nmikstas/atari_gravitar_black_widow/kicad/atari_gravitar_black_widow/Sheet3B.kicad_sch

## KiCad design kicad/atari_gravitar_black_widow/Sheet3B.kicad_sch (2022-01-29, an earlier design)

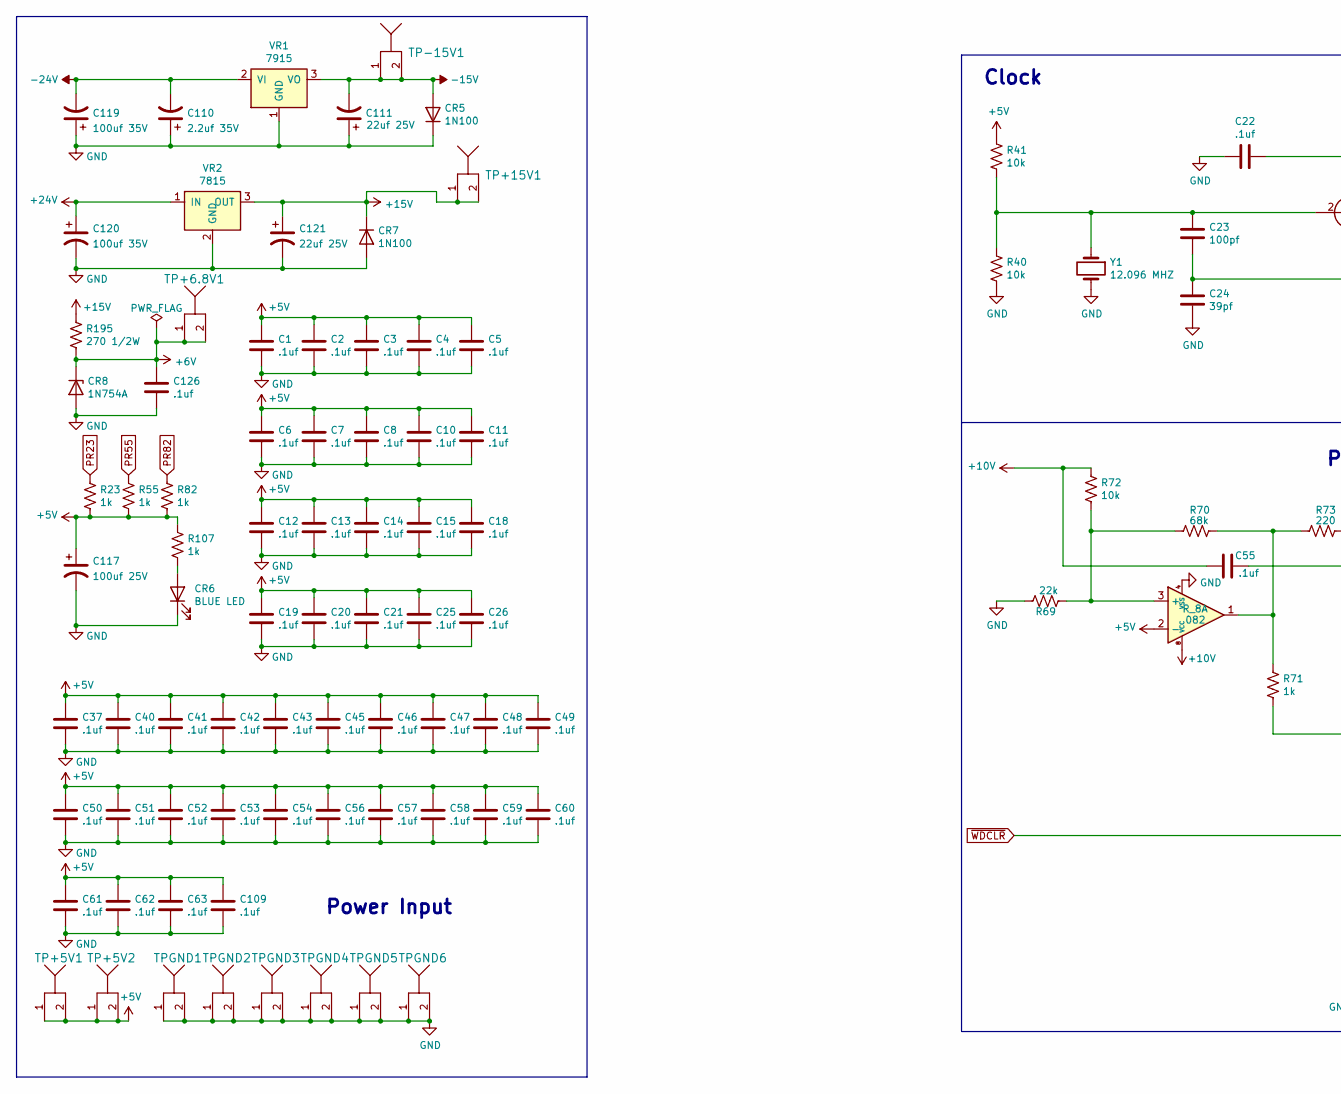
[picture p1: schematic Sheet3B.kicad_sch, part in row 1, column 1]

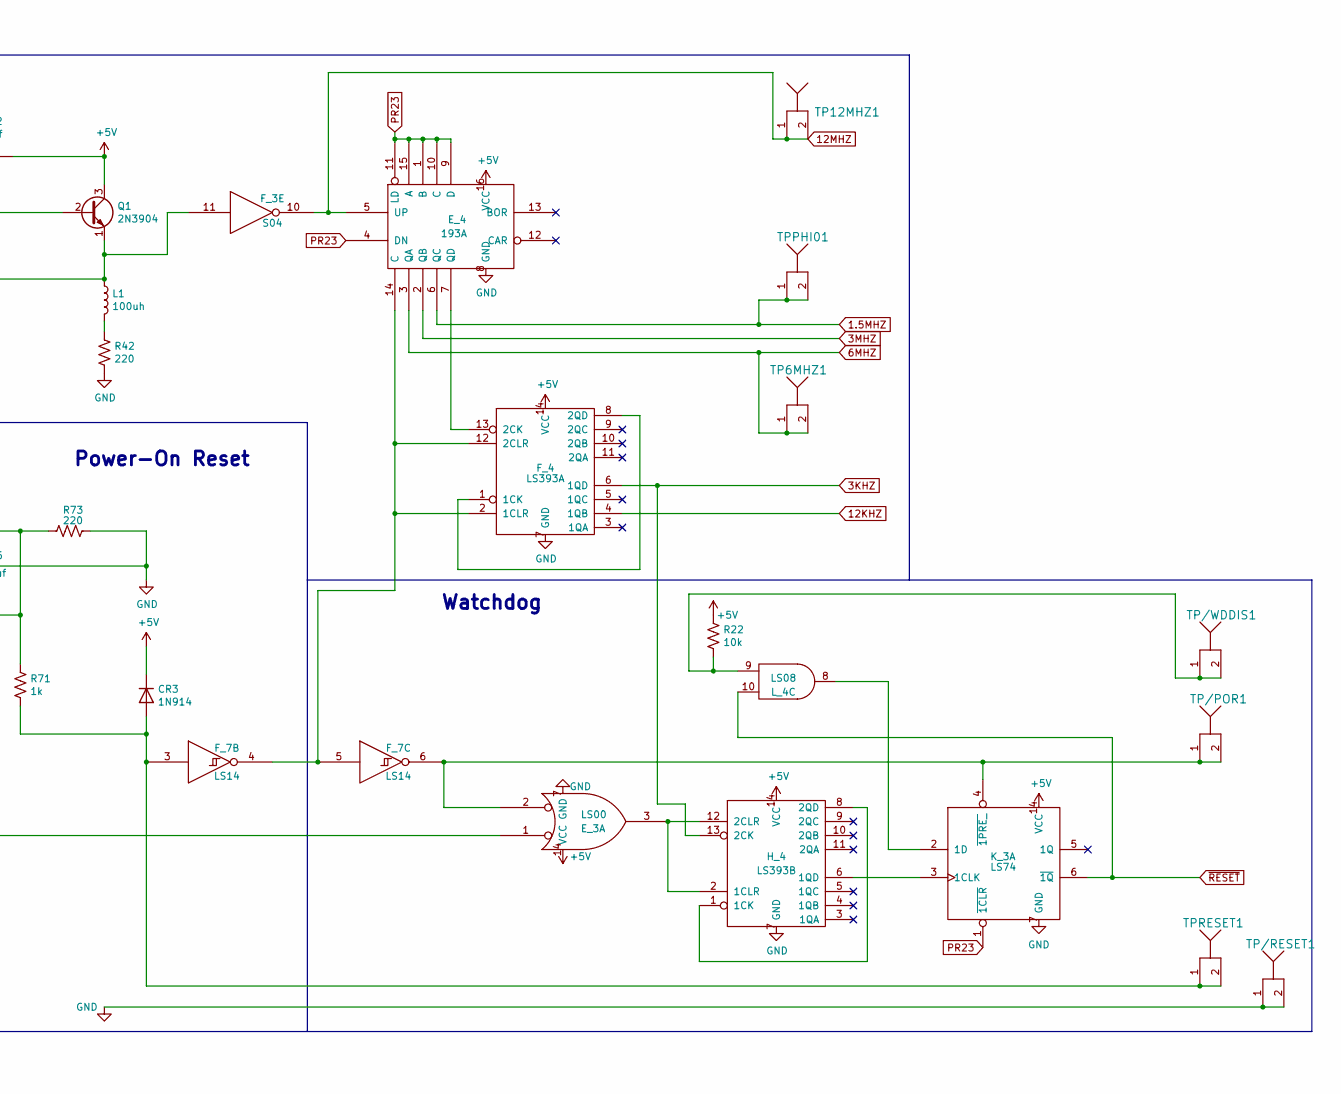
[picture p2: schematic Sheet3B.kicad_sch, part in row 1, column 2]

Parts:
C1, C2, C3, C4, C5, C6, C7, C8, C10, C11, C12, C13, C14, C15, C18, C19, C20, C21, C22, C25, C26, C37, C40, C41, C42, C43, C45, C46, C47, C48, C49, C50, C51, C52, C53, C54, C55, C56, C57, C58, C59, C60, C61, C62, C63, C109, C126: .1uf
C23: 100pf
C24: 39pf
C110: 2.2uf 35V
C111, C121: 22uf 25V
C117: 100uf 25V
C119, C120: 100uf 35V
CR3: 1N914
CR5, CR7: 1N100
CR6: BLUE LED
CR8: 1N754A
E_3: LS00
E_4: 193A
F_3: S04
F_4: LS393A
F_7: LS14
H_4: LS393B
K_3: LS74
L1: 100uh
L_4: LS08
Q1: 2N3904
R22, R40, R41, R72: 10k
R23, R55, R71, R82, R107: 1k
R42, R73: 220
R69: 22k
R70: 68k
R195: 270 1/2W
R_8: 082
TP6MHZ1, TP12MHZ1: TP
TP+5V1, TP+5V2, TP+6.8V1, TP+15V1: TP
TP-15V1: TP
TP/POR1: TP
TP/RESET1: TP
TP/WDDIS1: TP
TPGND1, TPGND2, TPGND3, TPGND4, TPGND5, TPGND6: TP
TPPHI01: TP
TPRESET1: TP
VR1: 7915
VR2: 7815
Y1: 12.096 MHZ

Connections:
1.5MHZ: E_4.6 (QC), TPPHI01.1, TPPHI01.2
3KHZ: F_4.6 (1QD), H_4.13 (2CK)
3MHZ: E_4.2 (QB)
6MHZ: E_4.3 (QA), TP6MHZ1.1, TP6MHZ1.2
12KHZ: F_4.4 (1QB)
12MHZ: E_4.5 (UP), F_3.10, TP12MHZ1.1, TP12MHZ1.2
+5V: C1.1, C2.1, C3.1, C4.1, C5.1, C6.1, C7.1, C8.1, C10.1, C11.1, C12.1, C13.1, C14.1, C15.1, C18.1, C19.1, C20.1, C21.1, C22.1, C25.1, C26.1, C37.1, C40.1, C41.1, C42.1, C43.1, C45.1, C46.1, C47.1, C48.1, C49.1, C50.1, C51.1, C52.1, C53.1, C54.1, C56.1, C57.1, C58.1, C59.1, C60.1, C61.1, C62.1, C63.1, C109.1, C117.1, CR3.1 (K), E_3.14 (VCC), E_4.16 (VCC), F_4.14 (VCC), H_4.14 (VCC), K_3.14 (VCC), Q1.3 (C), R22.1, R23.2, R41.1, R55.2, R82.2, R107.1, R_8.2 (-), TP+5V1.1, TP+5V1.2, TP+5V2.1, TP+5V2.2
+6V: C126.1, CR8.1 (K), R195.2, TP+6.8V1.1, TP+6.8V1.2
+10V: C55.2, R72.1, R_8.8 (VCC)
+15V: C121.1, CR7.1 (K), R195.1, TP+15V1.1, TP+15V1.2, VR2.3 (OUT)
+24V: C120.1, VR2.1 (IN)
-15V: C111.2, CR5.2 (A), TP-15V1.1, TP-15V1.2, VR1.3 (VO)
-24V: C110.2, C119.2, VR1.2 (VI)
GND: C1.2, C2.2, C3.2, C4.2, C5.2, C6.2, C7.2, C8.2, C10.2, C11.2, C12.2, C13.2, C14.2, C15.2, C18.2, C19.2, C20.2, C21.2, C22.2, C24.2, C25.2, C26.2, C37.2, C40.2, C41.2, C42.2, C43.2, C45.2, C46.2, C47.2, C48.2, C49.2, C50.2, C51.2, C52.2, C53.2, C54.2, C55.1, C56.2, C57.2, C58.2, C59.2, C60.2, C61.2, C62.2, C63.2, C109.2, C110.1, C111.1, C117.2, C119.1, C120.2, C121.2, C126.2, CR5.1 (K), CR6.1 (K), CR7.2 (A), CR8.2 (A), E_3.7 (GND), E_4.8 (GND), F_4.7 (GND), H_4.7 (GND), K_3.7 (GND), R40.2, R42.2, R69.2, R73.1, R_8.4 (VSS), TP/RESET1.1, TP/RESET1.2, TPGND1.1, TPGND1.2, TPGND2.1, TPGND2.2, TPGND3.1, TPGND3.2, TPGND4.1, TPGND4.2, TPGND5.1, TPGND5.2, TPGND6.1, TPGND6.2, VR1.1 (GND), VR2.2 (GND), Y1.2
unnamed: C23.1, Q1.2 (B), R40.1, R41.2, Y1.1
unnamed: C23.2, C24.1, F_3.11, L1.1, Q1.1 (E)
unnamed: CR3.2 (A), F_7.3, R71.2, TPRESET1.1, TPRESET1.2
unnamed: CR6.2 (A), R107.2
unnamed: E_3.2, F_7.6, K_3.4 (~1PRE_), TP/POR1.1, TP/POR1.2
unnamed: E_3.3, H_4.2 (1CLR), H_4.12 (2CLR)
unnamed: E_4.7 (QD), F_4.13 (2CK)
unnamed: E_4.14 (C), F_4.2 (1CLR), F_4.12 (2CLR), F_7.4, F_7.5
unnamed: F_4.1 (1CK), F_4.8 (2QD)
unnamed: H_4.1 (1CK), H_4.8 (2QD)
unnamed: H_4.6 (1QD), K_3.3 (1CLK)
unnamed: K_3.2 (1D), L_4.8
unnamed: L1.2, R42.1
unnamed: L_4.9, R22.2, TP/WDDIS1.1, TP/WDDIS1.2
unnamed: R69.1, R70.2, R72.2, R_8.3 (+)
unnamed: R70.1, R71.1, R73.2, R_8.1
PR23: E_4.1 (B), E_4.4 (DN), E_4.9 (D), E_4.10 (C), E_4.11 (LD), E_4.15 (A), K_3.1 (~1CLR), R23.1
PR55: R55.1
PR82: R82.1
~RESET: K_3.6 (~1Q), L_4.10
~WDCLR: E_3.1

Notes on the sheet:
Power-On Reset
Power Input
Clock
Watchdog
