nmikstas/atari_gravitar_black_widow/kicad/atari_gravitar_black_widow/Sheet4A.kicad_sch

## KiCad design kicad/atari_gravitar_black_widow/Sheet4A.kicad_sch (2022-02-08, an earlier design)

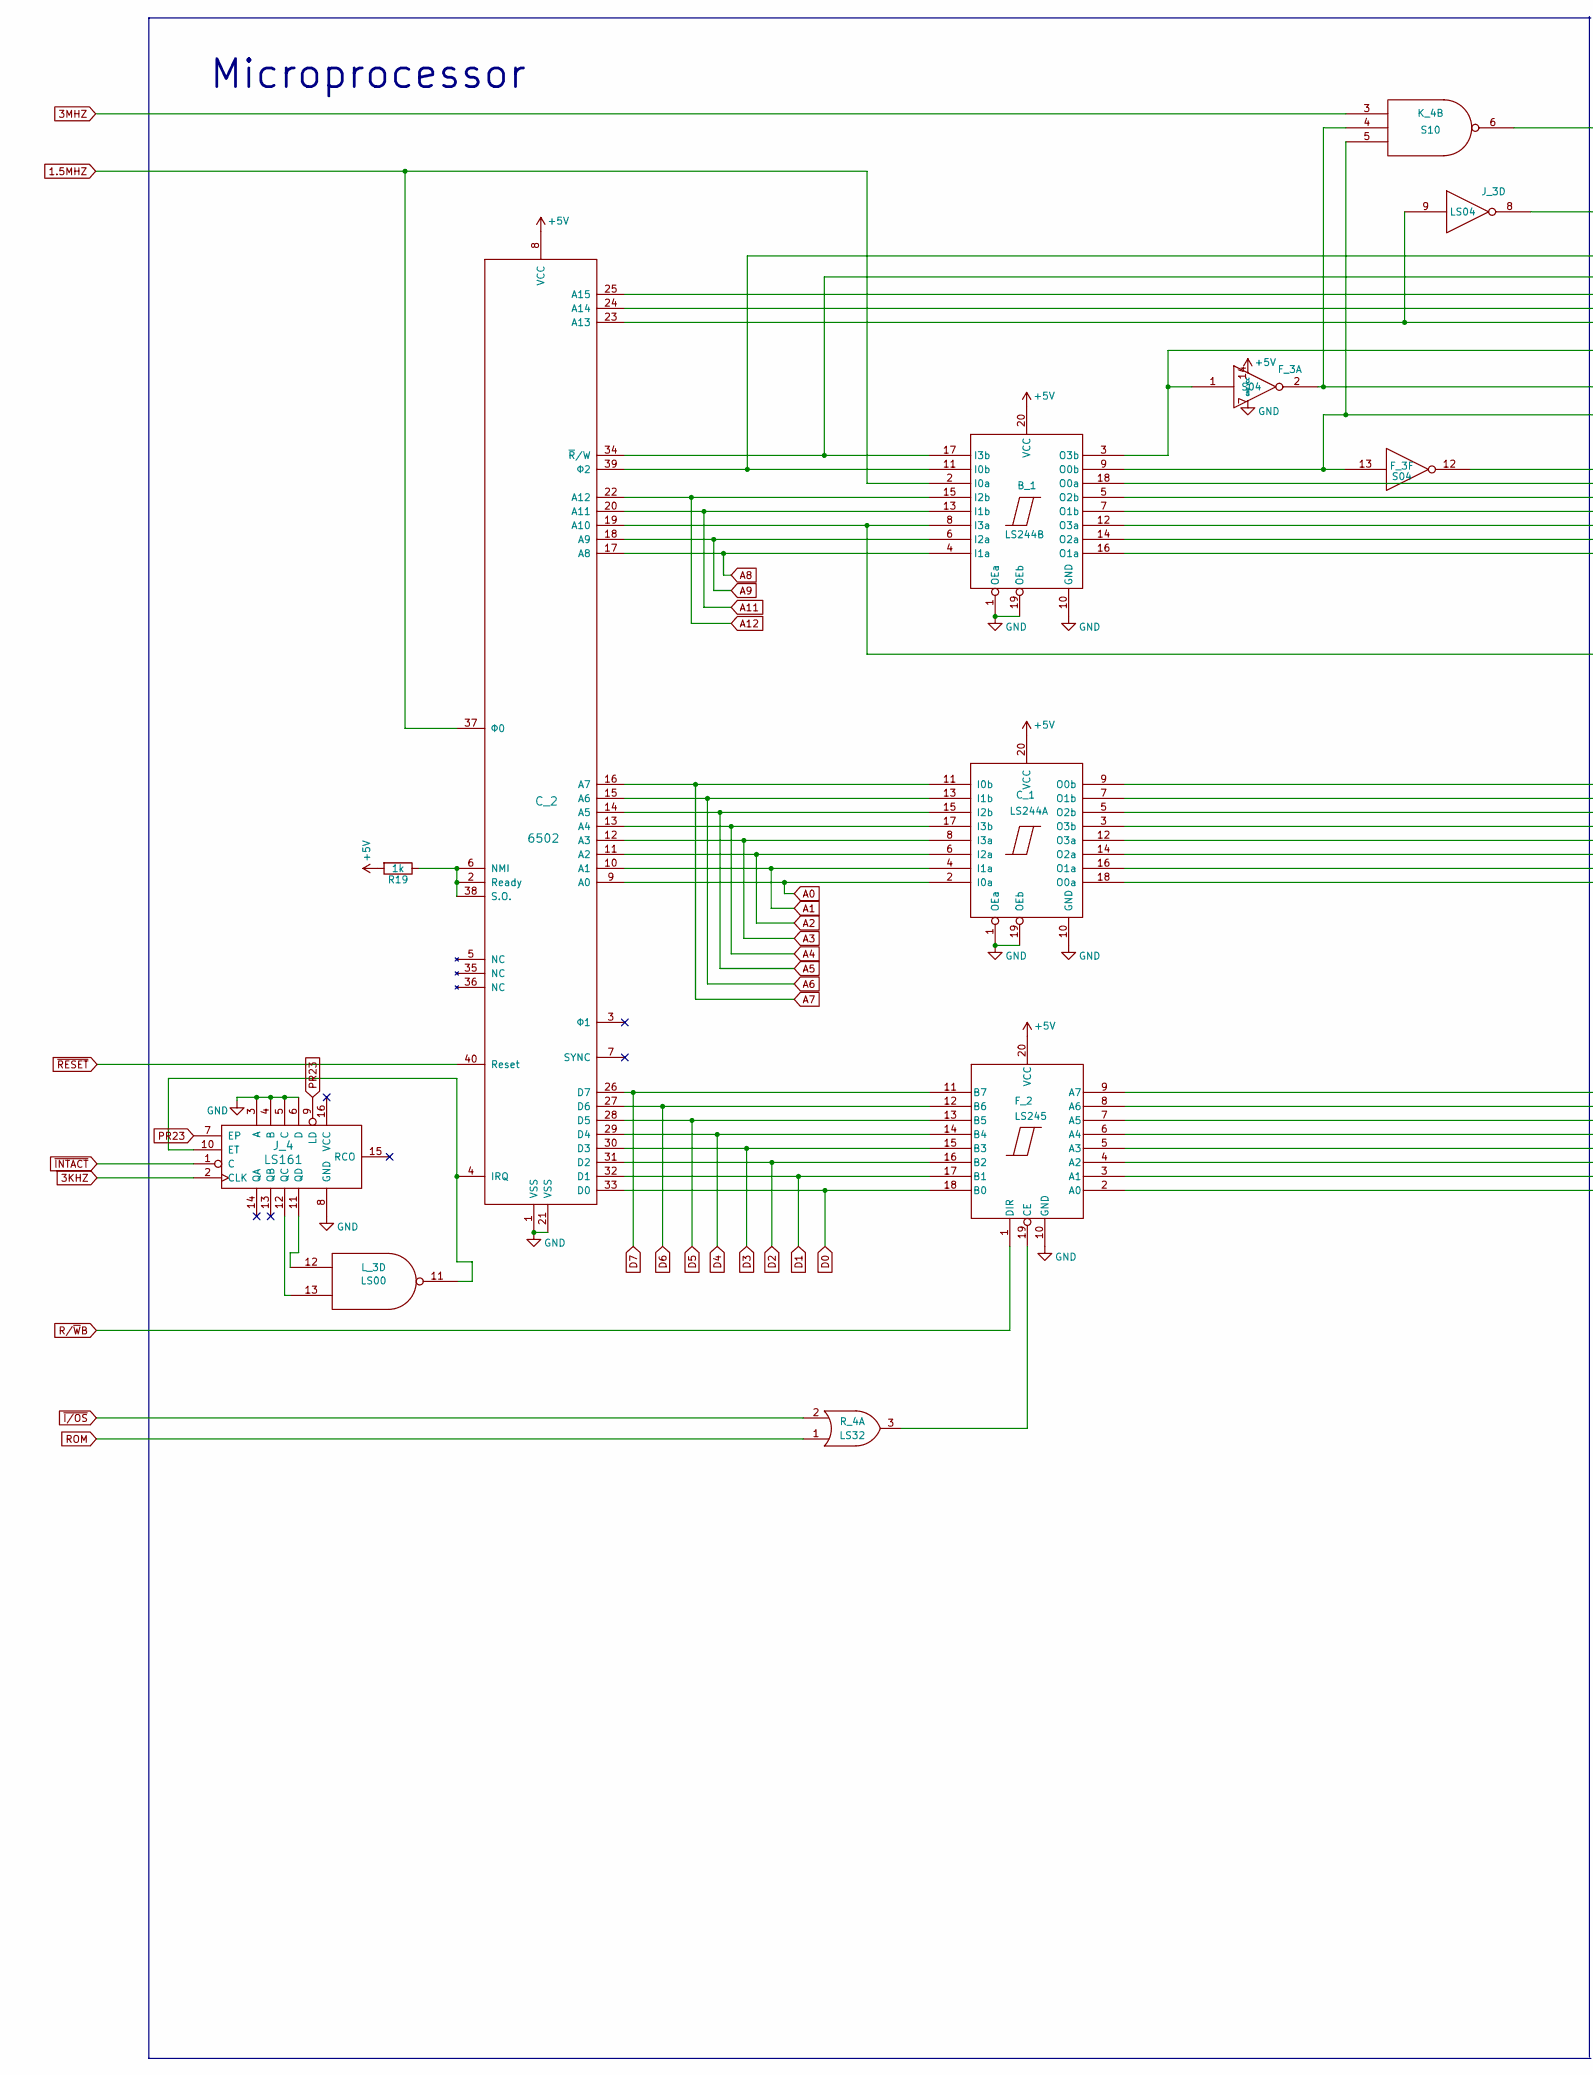
[picture p3: schematic Sheet4A.kicad_sch, part in row 1, column 1]

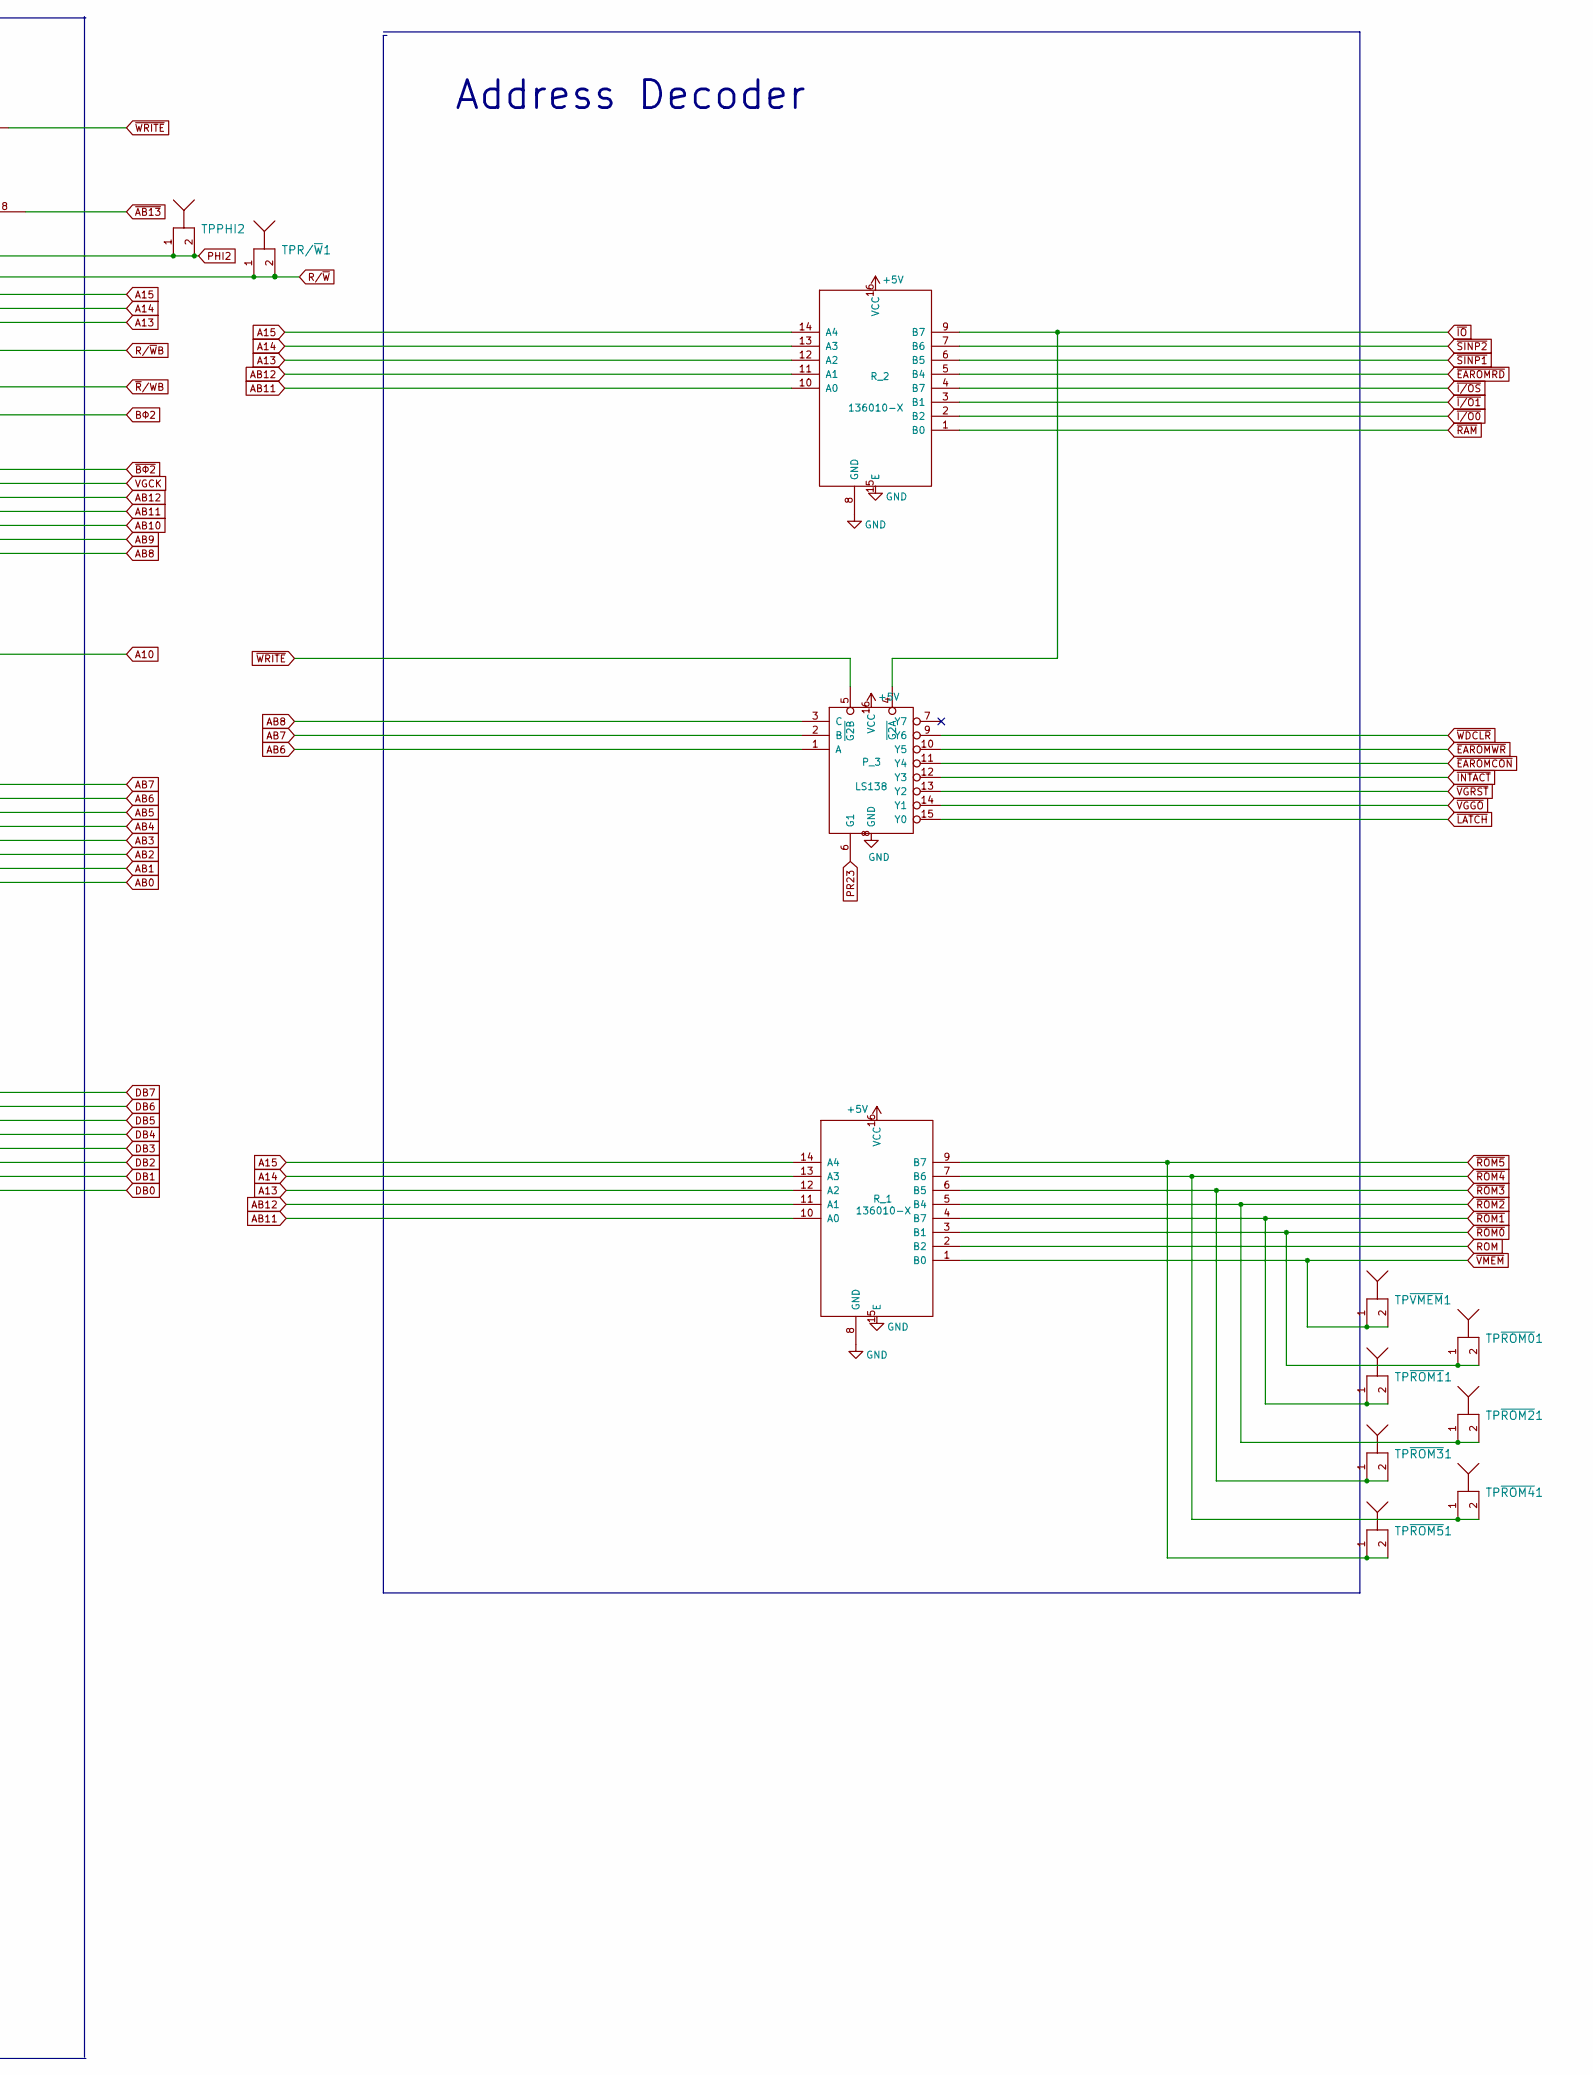
[picture p4: schematic Sheet4A.kicad_sch, part in row 1, column 2]

Parts:
B_1: LS244B
C_1: LS244A
C_2: 6502
F_2: LS245
F_3: S04
J_3: LS04
J_4: LS161
K_4: S10
L_3: LS00
P_3: LS138
R19: 1k
R_1, R_2: 136010-X
R_4: LS32
TPPHI2: TP
TPR/~{W}1: TP
TP~{ROM0}1, TP~{ROM1}1, TP~{ROM2}1, TP~{ROM3}1, TP~{ROM4}1, TP~{ROM5}1: TP
TP~{VMEM}1: TP

Connections:
1.5MHZ: B_1.2 (I0a), C_2.37 (Φ0)
3KHZ: J_4.2 (CLK)
3MHZ: K_4.3
+5V: B_1.20 (VCC), C_1.20 (VCC), C_2.8 (VCC), F_2.20 (VCC), F_3.14 (VCC), P_3.16 (VCC), R19.2, R_1.16 (VCC), R_2.16 (VCC)
A0: C_1.2 (I0a), C_2.9 (A0)
A1: C_1.4 (I1a), C_2.10 (A1)
A2: C_1.6 (I2a), C_2.11 (A2)
A3: C_1.8 (I3a), C_2.12 (A3)
A4: C_1.17 (I3b), C_2.13 (A4)
A5: C_1.15 (I2b), C_2.14 (A5)
A6: C_1.13 (I1b), C_2.15 (A6)
A7: C_1.11 (I0b), C_2.16 (A7)
A8: B_1.4 (I1a), C_2.17 (A8)
A9: B_1.6 (I2a), C_2.18 (A9)
A10: B_1.8 (I3a), C_2.19 (A10)
A11: B_1.13 (I1b), C_2.20 (A11)
A12: B_1.15 (I2b), C_2.22 (A12)
A13: C_2.23 (A13), J_3.9, R_1.12 (A2), R_2.12 (A2)
A14: C_2.24 (A14), R_1.13 (A3), R_2.13 (A3)
A15: C_2.25 (A15), R_1.14 (A4), R_2.14 (A4)
AB0: C_1.18 (O0a)
AB1: C_1.16 (O1a)
AB2: C_1.14 (O2a)
AB3: C_1.12 (O3a)
AB4: C_1.3 (O3b)
AB5: C_1.5 (O2b)
AB6: C_1.7 (O1b), P_3.1 (A)
AB7: C_1.9 (O0b), P_3.2 (B)
AB8: B_1.16 (O1a), P_3.3 (C)
AB9: B_1.14 (O2a)
AB10: B_1.12 (O3a)
AB11: B_1.7 (O1b), R_1.10 (A0), R_2.10 (A0)
AB12: B_1.5 (O2b), R_1.11 (A1), R_2.11 (A1)
BΦ2: B_1.9 (O0b), F_3.13, K_4.5
D0: C_2.33 (D0), F_2.18 (B0)
D1: C_2.32 (D1), F_2.17 (B1)
D2: C_2.31 (D2), F_2.16 (B2)
D3: C_2.30 (D3), F_2.15 (B3)
D4: C_2.29 (D4), F_2.14 (B4)
D5: C_2.28 (D5), F_2.13 (B5)
D6: C_2.27 (D6), F_2.12 (B6)
D7: C_2.26 (D7), F_2.11 (B7)
DB0: F_2.2 (A0)
DB1: F_2.3 (A1)
DB2: F_2.4 (A2)
DB3: F_2.5 (A3)
DB4: F_2.6 (A4)
DB5: F_2.7 (A5)
DB6: F_2.8 (A6)
DB7: F_2.9 (A7)
GND: B_1.1 (OEa), B_1.10 (GND), B_1.19 (OEb), C_1.1 (OEa), C_1.10 (GND), C_1.19 (OEb), C_2.1 (VSS), C_2.21 (VSS), F_2.10 (GND), F_3.7 (GND), J_4.3 (A), J_4.4 (B), J_4.5 (C), J_4.6 (D), J_4.8 (GND), P_3.8 (GND), R_1.8 (GND), R_1.15 (E), R_2.8 (GND), R_2.15 (E)
unnamed: C_2.2 (Ready), C_2.6 (NMI), C_2.38 (S.O.), R19.1
unnamed: C_2.4 (IRQ), J_4.10 (ET), L_3.11
unnamed: F_2.19 (CE), R_4.3
unnamed: J_4.11 (QD), L_3.12
unnamed: J_4.12 (QC), L_3.13
PHI2: B_1.11 (I0b), C_2.39 (Φ2), TPPHI2.1, TPPHI2.2
PR23: J_4.7 (EP), J_4.9 (LD), P_3.6 (G1)
ROM: R_1.2 (B2), R_4.1
R/~W: B_1.17 (I3b), C_2.34 (~R/W), TPR/~{W}1.1, TPR/~{W}1.2
R/~WB: B_1.3 (O3b), F_2.1 (DIR), F_3.1
VGCK: B_1.18 (O0a)
~AB13: J_3.8
~BΦ2: F_3.12
~EAROMCON: P_3.11 (Y4)
~EAROMRD: R_2.5 (B4)
~EAROMWR: P_3.10 (Y5)
~INTACT: J_4.1 (C), P_3.12 (Y3)
~IO: P_3.4 (~G2A), R_2.9 (B7)
~I/O0: R_2.2 (B2)
~I/O1: R_2.3 (B1)
~I/OS: R_2.4 (B7), R_4.2
~LATCH: P_3.15 (Y0)
~RAM: R_2.1 (B0)
~RESET: C_2.40 (Reset)
~ROM0: R_1.3 (B1), TP~{ROM0}1.1, TP~{ROM0}1.2
~ROM1: R_1.4 (B7), TP~{ROM1}1.1, TP~{ROM1}1.2
~ROM2: R_1.5 (B4), TP~{ROM2}1.1, TP~{ROM2}1.2
~ROM3: R_1.6 (B5), TP~{ROM3}1.1, TP~{ROM3}1.2
~ROM4: R_1.7 (B6), TP~{ROM4}1.1, TP~{ROM4}1.2
~ROM5: R_1.9 (B7), TP~{ROM5}1.1, TP~{ROM5}1.2
~R/WB: F_3.2, K_4.4
~SINP1: R_2.6 (B5)
~SINP2: R_2.7 (B6)
~VGGO: P_3.14 (Y1)
~VGRST: P_3.13 (Y2)
~VMEM: R_1.1 (B0), TP~{VMEM}1.1, TP~{VMEM}1.2
~WDCLR: P_3.9 (Y6)
~WRITE: K_4.6, P_3.5 (~G2B)

Notes on the sheet:
Microprocessor
Address Decoder
