nmikstas/atari_gravitar_black_widow/kicad/atari_gravitar_black_widow/Sheet4B.kicad_sch

## KiCad design kicad/atari_gravitar_black_widow/Sheet4B.kicad_sch (2022-03-18, an earlier design)

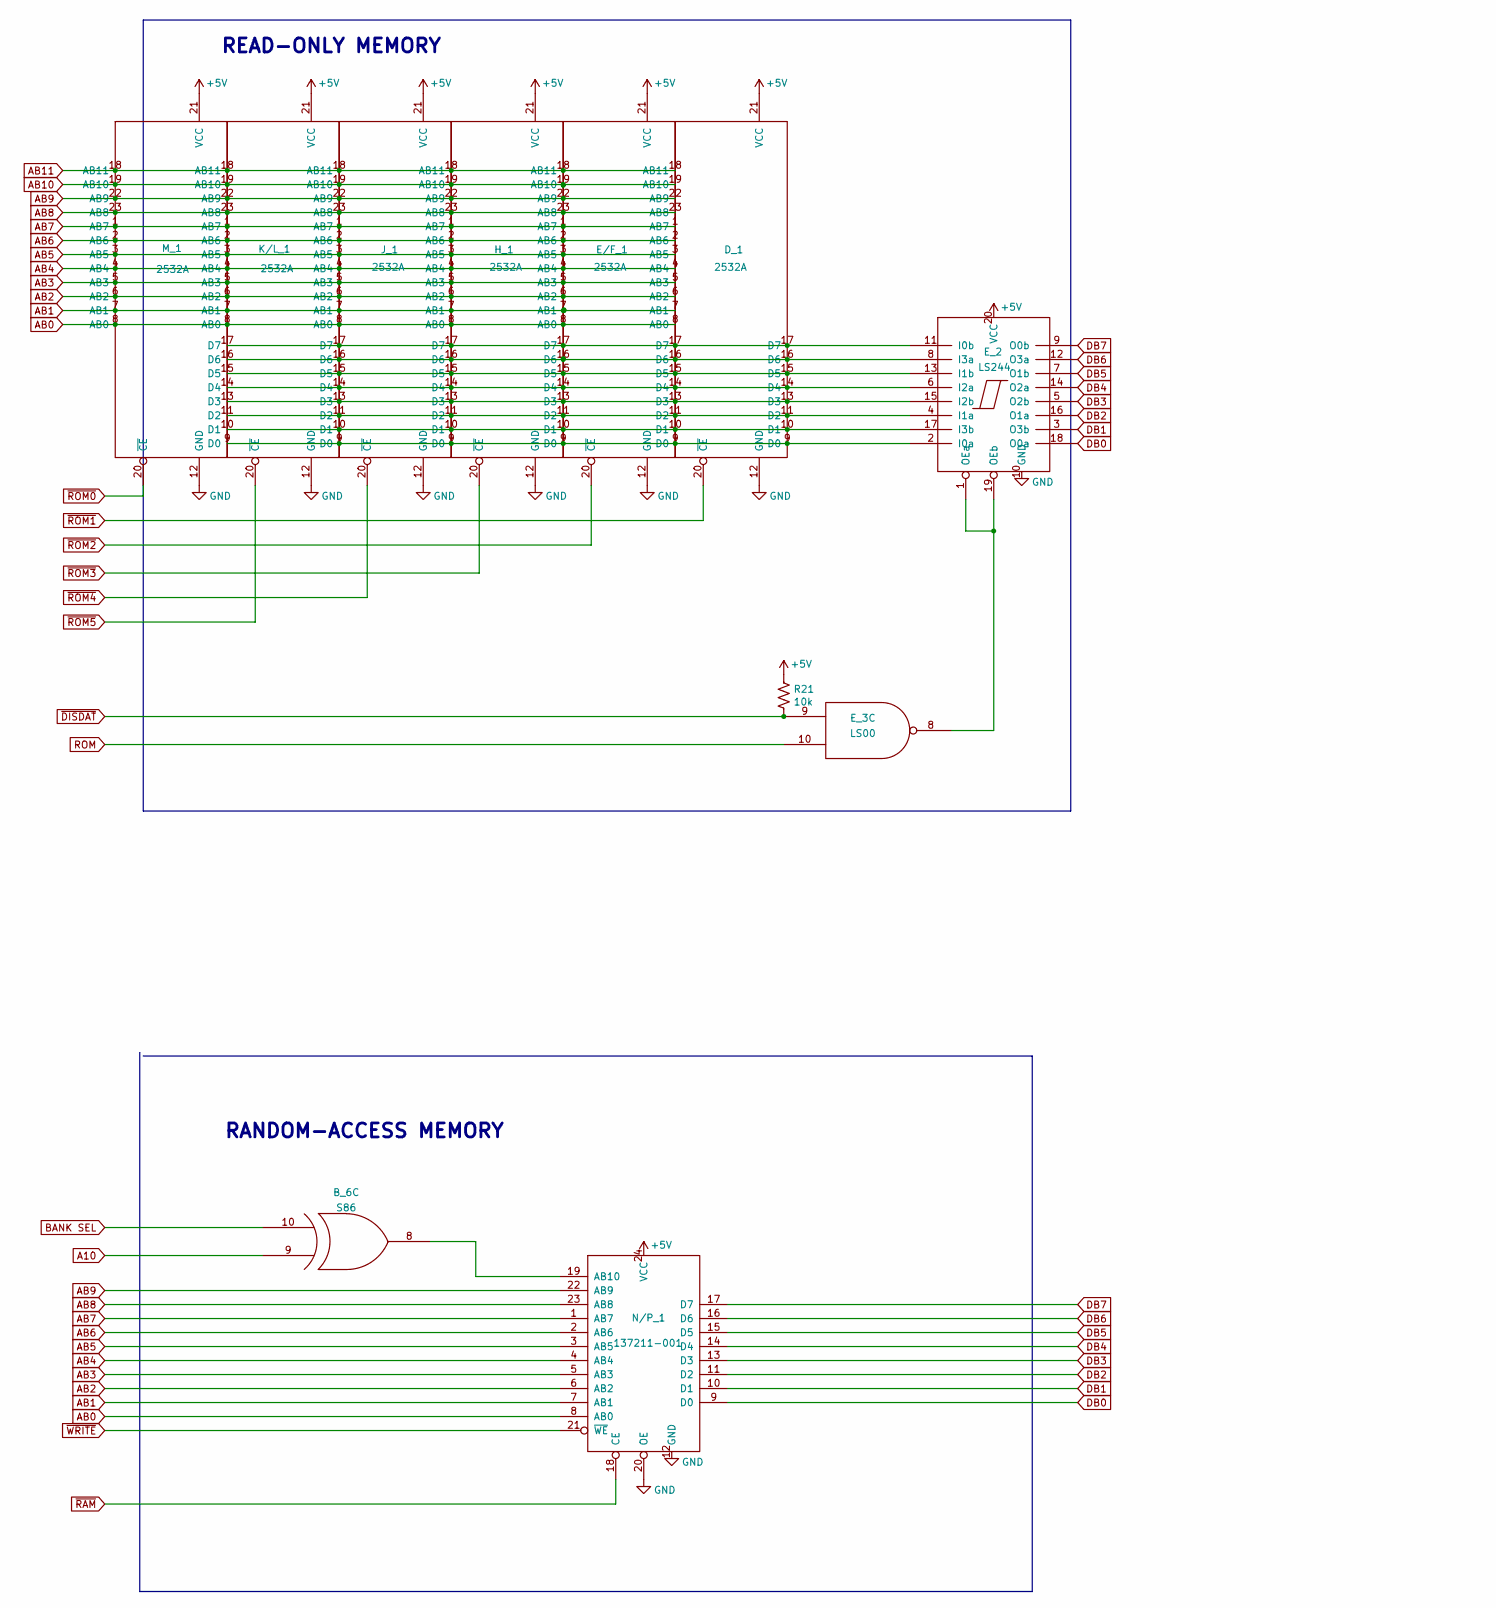
[picture p5: schematic Sheet4B.kicad_sch, part in row 1, column 1]

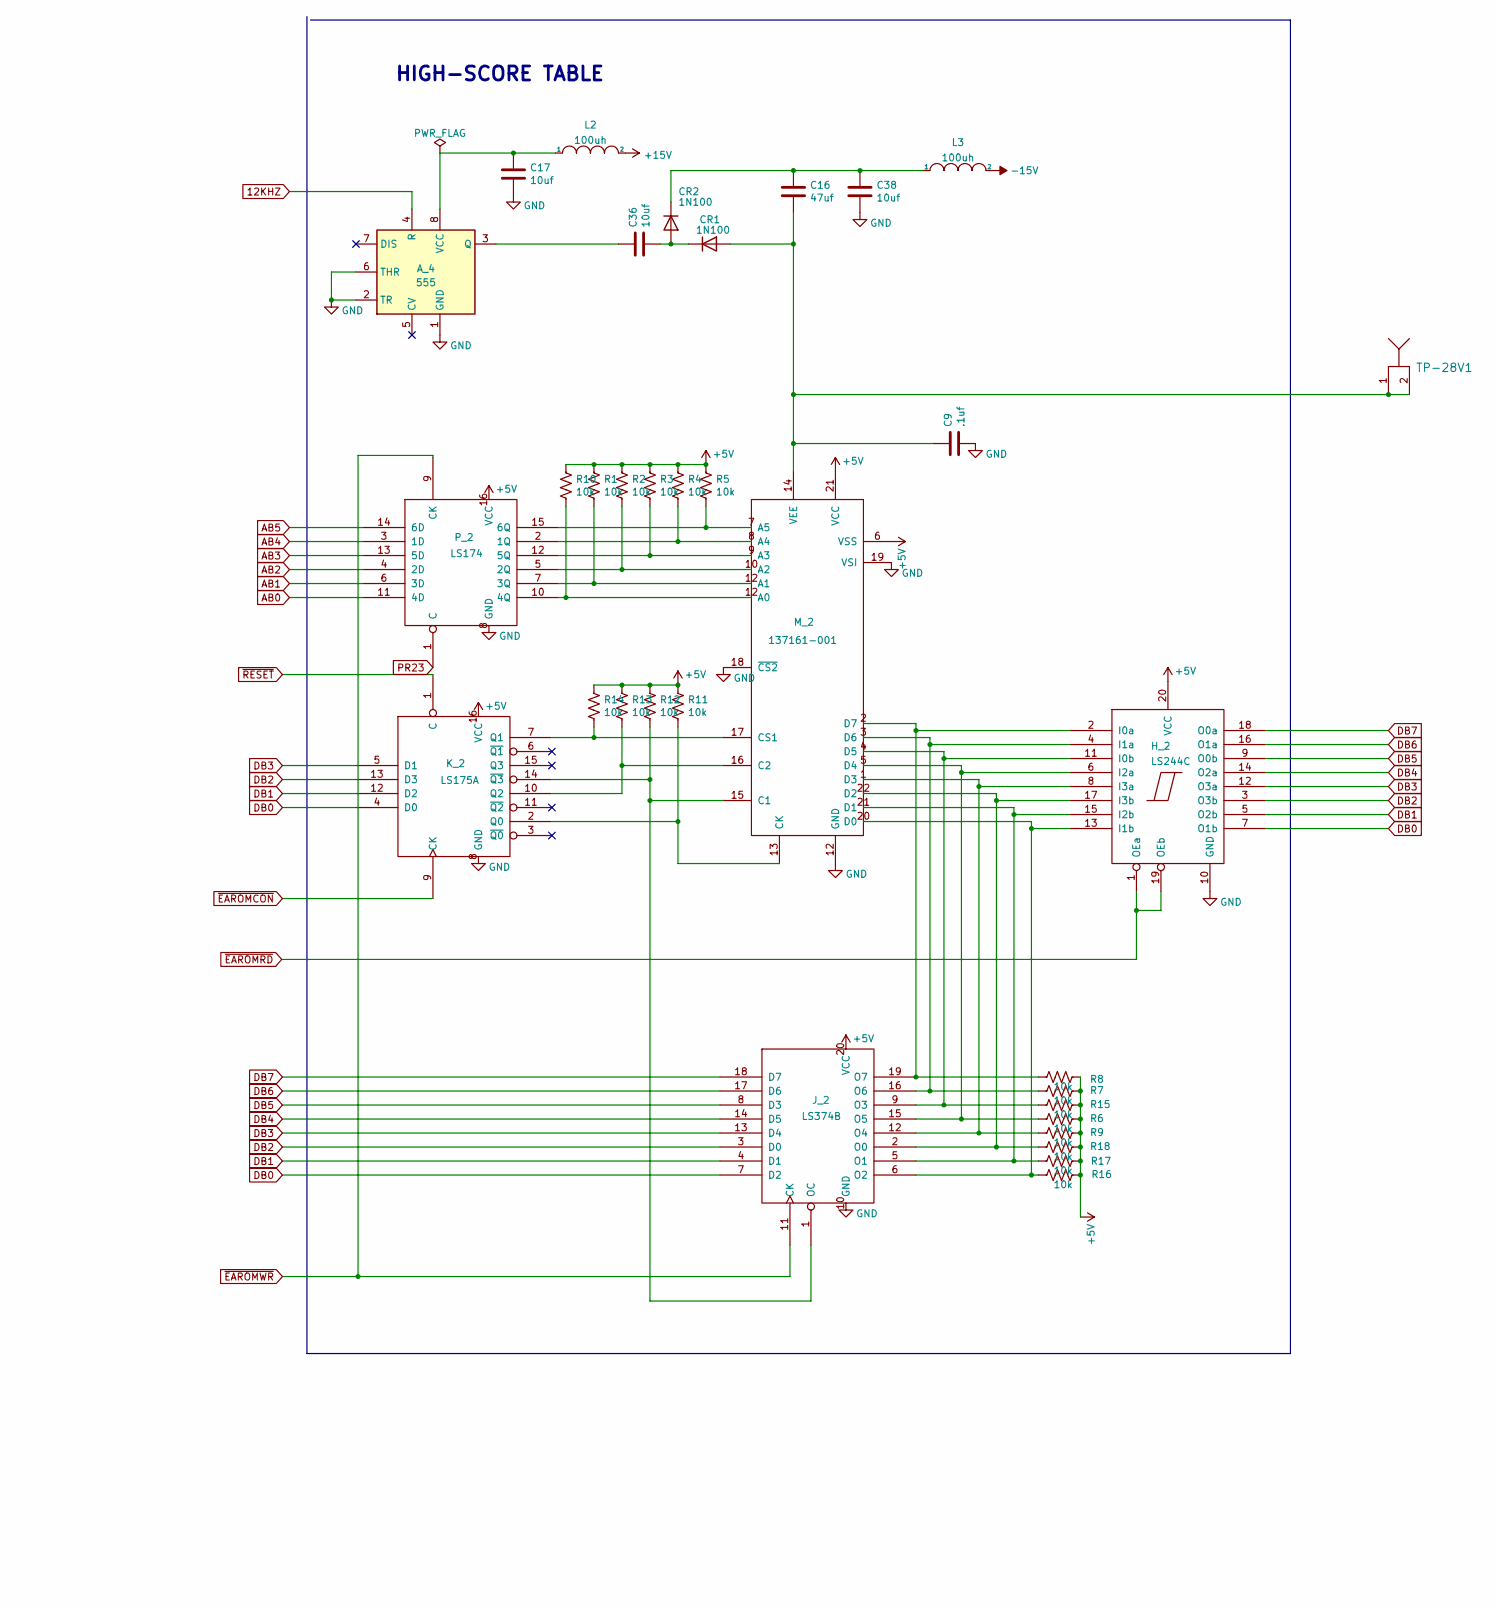
[picture p6: schematic Sheet4B.kicad_sch, part in row 1, column 2]

Parts:
A_4: 555
B_6: S86
C9: .1uf
C16: 47uf
C17, C36, C38: 10uf
CR1, CR2: 1N100
D_1: 2532A
E/F_1: 2532A
E_2: LS244
E_3: LS00
H_1: 2532A
H_2: LS244C
J_1: 2532A
J_2: LS374B
K/L_1: 2532A
K_2: LS175A
L2, L3: 100uh
M_1: 2532A
M_2: 137161-001
N/P_1: 137211-001
P_2: LS174
R1, R2, R3, R4, R5, R6, R7, R8, R9, R10, R11, R12, R13, R14, R15, R16, R17, R18, R21: 10k
TP-28V1: TP

Connections:
12KHZ: A_4.4 (R)
+5V: D_1.21 (VCC), E/F_1.21 (VCC), E_2.20 (VCC), H_1.21 (VCC), H_2.20 (VCC), J_1.21 (VCC), J_2.20 (VCC), K/L_1.21 (VCC), K_2.16 (VCC), M_1.21 (VCC), M_2.6 (VSS), M_2.21 (D1), N/P_1.24 (VCC), P_2.16 (VCC), R1.1, R2.1, R3.1, R4.1, R5.1, R6.1, R7.1, R8.1, R9.1, R10.1, R11.1, R12.1, R13.1, R14.1, R15.1, R16.1, R17.1, R18.1, R21.1
+15V: L2.2
-15V: L3.2
A10: B_6.9
AB0: D_1.8 (AB0), E/F_1.8 (AB0), H_1.8 (AB0), J_1.8 (AB0), K/L_1.8 (AB0), M_1.8 (AB0), N/P_1.8 (AB0), P_2.11 (4D)
AB1: D_1.7 (AB1), E/F_1.7 (AB1), H_1.7 (AB1), J_1.7 (AB1), K/L_1.7 (AB1), M_1.7 (AB1), N/P_1.7 (AB1), P_2.6 (3D)
AB2: D_1.6 (AB2), E/F_1.6 (AB2), H_1.6 (AB2), J_1.6 (AB2), K/L_1.6 (AB2), M_1.6 (AB2), N/P_1.6 (AB2), P_2.4 (2D)
AB3: D_1.5 (AB3), E/F_1.5 (AB3), H_1.5 (AB3), J_1.5 (AB3), K/L_1.5 (AB3), M_1.5 (AB3), N/P_1.5 (AB3), P_2.13 (5D)
AB4: D_1.4 (AB4), E/F_1.4 (AB4), H_1.4 (AB4), J_1.4 (AB4), K/L_1.4 (AB4), M_1.4 (AB4), N/P_1.4 (AB4), P_2.3 (1D)
AB5: D_1.3 (AB5), E/F_1.3 (AB5), H_1.3 (AB5), J_1.3 (AB5), K/L_1.3 (AB5), M_1.3 (AB5), N/P_1.3 (AB5), P_2.14 (6D)
AB6: D_1.2 (AB6), E/F_1.2 (AB6), H_1.2 (AB6), J_1.2 (AB6), K/L_1.2 (AB6), M_1.2 (AB6), N/P_1.2 (AB6)
AB7: D_1.1 (AB7), E/F_1.1 (AB7), H_1.1 (AB7), J_1.1 (AB7), K/L_1.1 (AB7), M_1.1 (AB7), N/P_1.1 (AB7)
AB8: D_1.23 (AB8), E/F_1.23 (AB8), H_1.23 (AB8), J_1.23 (AB8), K/L_1.23 (AB8), M_1.23 (AB8), N/P_1.23 (AB8)
AB9: D_1.22 (AB9), E/F_1.22 (AB9), H_1.22 (AB9), J_1.22 (AB9), K/L_1.22 (AB9), M_1.22 (AB9), N/P_1.22 (AB9)
AB10: D_1.19 (AB10), E/F_1.19 (AB10), H_1.19 (AB10), J_1.19 (AB10), K/L_1.19 (AB10), M_1.19 (AB10)
AB11: D_1.18 (AB11), E/F_1.18 (AB11), H_1.18 (AB11), J_1.18 (AB11), K/L_1.18 (AB11), M_1.18 (AB11)
BANK SEL: B_6.10
DB0: E_2.18 (O0a), H_2.7 (O1b), J_2.7 (D2), K_2.4 (D0), N/P_1.9 (D0)
DB1: E_2.3 (O3b), H_2.5 (O2b), J_2.4 (D1), K_2.12 (D2), N/P_1.10 (D1)
DB2: E_2.16 (O1a), H_2.3 (O3b), J_2.3 (D0), K_2.13 (D3), N/P_1.11 (D2)
DB3: E_2.5 (O2b), H_2.12 (O3a), J_2.13 (D4), K_2.5 (D1), N/P_1.13 (D3)
DB4: E_2.14 (O2a), H_2.14 (O2a), J_2.14 (D5), N/P_1.14 (D4)
DB5: E_2.7 (O1b), H_2.9 (O0b), J_2.8 (D3), N/P_1.15 (D5)
DB6: E_2.12 (O3a), H_2.16 (O1a), J_2.17 (D6), N/P_1.16 (D6)
DB7: E_2.9 (O0b), H_2.18 (O0a), J_2.18 (D7), N/P_1.17 (D7)
GND: A_4.1 (GND), A_4.2 (TR), A_4.6 (THR), C9.2, C17.2, C38.2, D_1.12 (GND), E/F_1.12 (GND), E_2.10 (GND), H_1.12 (GND), H_2.10 (GND), J_1.12 (GND), J_2.10 (GND), K/L_1.12 (GND), K_2.8 (GND), M_1.12 (GND), M_2.12 (A0), M_2.18 (~CS2), M_2.19 (VSI), N/P_1.12 (GND), N/P_1.20 (OE), P_2.8 (GND)
unnamed: A_4.3 (Q), C36.1
unnamed: A_4.8 (VCC), C17.1, L2.1
unnamed: B_6.8, N/P_1.19 (AB10)
unnamed: C16.1, C38.1, CR2.1 (K), L3.1
unnamed: C9.1, C16.2, CR1.2 (A), M_2.14 (VEE), TP-28V1.1, TP-28V1.2
unnamed: C36.2, CR1.1 (K), CR2.2 (A)
unnamed: D_1.9 (D0), E/F_1.9 (D0), E_2.2 (I0a), H_1.9 (D0), J_1.9 (D0), K/L_1.9 (D0), M_1.9 (D0)
unnamed: D_1.10 (D1), E/F_1.10 (D1), E_2.17 (I3b), H_1.10 (D1), J_1.10 (D1), K/L_1.10 (D1), M_1.10 (D1)
unnamed: D_1.11 (D2), E/F_1.11 (D2), E_2.4 (I1a), H_1.11 (D2), J_1.11 (D2), K/L_1.11 (D2), M_1.11 (D2)
unnamed: D_1.13 (D3), E/F_1.13 (D3), E_2.15 (I2b), H_1.13 (D3), J_1.13 (D3), K/L_1.13 (D3), M_1.13 (D3)
unnamed: D_1.14 (D4), E/F_1.14 (D4), E_2.6 (I2a), H_1.14 (D4), J_1.14 (D4), K/L_1.14 (D4), M_1.14 (D4)
unnamed: D_1.15 (D5), E/F_1.15 (D5), E_2.13 (I1b), H_1.15 (D5), J_1.15 (D5), K/L_1.15 (D5), M_1.15 (D5)
unnamed: D_1.16 (D6), E/F_1.16 (D6), E_2.8 (I3a), H_1.16 (D6), J_1.16 (D6), K/L_1.16 (D6), M_1.16 (D6)
unnamed: D_1.17 (D7), E/F_1.17 (D7), E_2.11 (I0b), H_1.17 (D7), J_1.17 (D7), K/L_1.17 (D7), M_1.17 (D7)
unnamed: E_2.1 (OEa), E_2.19 (OEb), E_3.8
unnamed: H_2.2 (I0a), J_2.19 (O7), M_2.2 (D7), R8.2
unnamed: H_2.4 (I1a), J_2.16 (O6), M_2.3 (D6), R7.2
unnamed: H_2.6 (I2a), J_2.15 (O5), M_2.5 (D4), R6.2
unnamed: H_2.8 (I3a), J_2.12 (O4), M_2.1 (D3), R9.2
unnamed: H_2.11 (I0b), J_2.9 (O3), M_2.4 (D5), R15.2
unnamed: H_2.13 (I1b), J_2.6 (O2), M_2.20 (D0), R16.2
unnamed: H_2.15 (I2b), J_2.5 (O1), M_2.21 (D1), R17.2
unnamed: H_2.17 (I3b), J_2.2 (O0), M_2.22 (D2), R18.2
unnamed: J_2.1 (OC), K_2.14 (~Q3), M_2.15 (C1), R12.2
unnamed: K_2.2 (Q0), M_2.13 (CK), R11.2
unnamed: K_2.7 (Q1), M_2.17 (CS1), R14.2
unnamed: K_2.10 (Q2), M_2.16 (C2), R13.2
unnamed: M_2.7 (A5), P_2.15 (6Q), R5.2
unnamed: M_2.8 (A4), P_2.2 (1Q), R4.2
unnamed: M_2.9 (A3), P_2.12 (5Q), R3.2
unnamed: M_2.10 (A2), P_2.5 (2Q), R2.2
unnamed: M_2.12 (A0), P_2.7 (3Q), P_2.10 (4Q), R1.2, R10.2
PR23: P_2.1 (C)
ROM: E_3.10
~DISDAT: E_3.9, R21.2
~EAROMCON: K_2.9 (CK)
~EAROMRD: H_2.1 (OEa), H_2.19 (OEb)
~EAROMWR: J_2.11 (CK), P_2.9 (CK)
~RAM: N/P_1.18 (CE)
~RESET: K_2.1 (C)
~ROM0: M_1.20 (~CE)
~ROM1: D_1.20 (~CE)
~ROM2: E/F_1.20 (~CE)
~ROM3: H_1.20 (~CE)
~ROM4: J_1.20 (~CE)
~ROM5: K/L_1.20 (~CE)
~WRITE: N/P_1.21 (~WE)

Notes on the sheet:
READ-ONLY MEMORY
RANDOM-ACCESS MEMORY
HIGH-SCORE TABLE
