nmikstas/atari_gravitar_black_widow/kicad/atari_gravitar_black_widow/Sheet5A.kicad_sch

## KiCad design kicad/atari_gravitar_black_widow/Sheet5A.kicad_sch (2022-03-22, an earlier design)

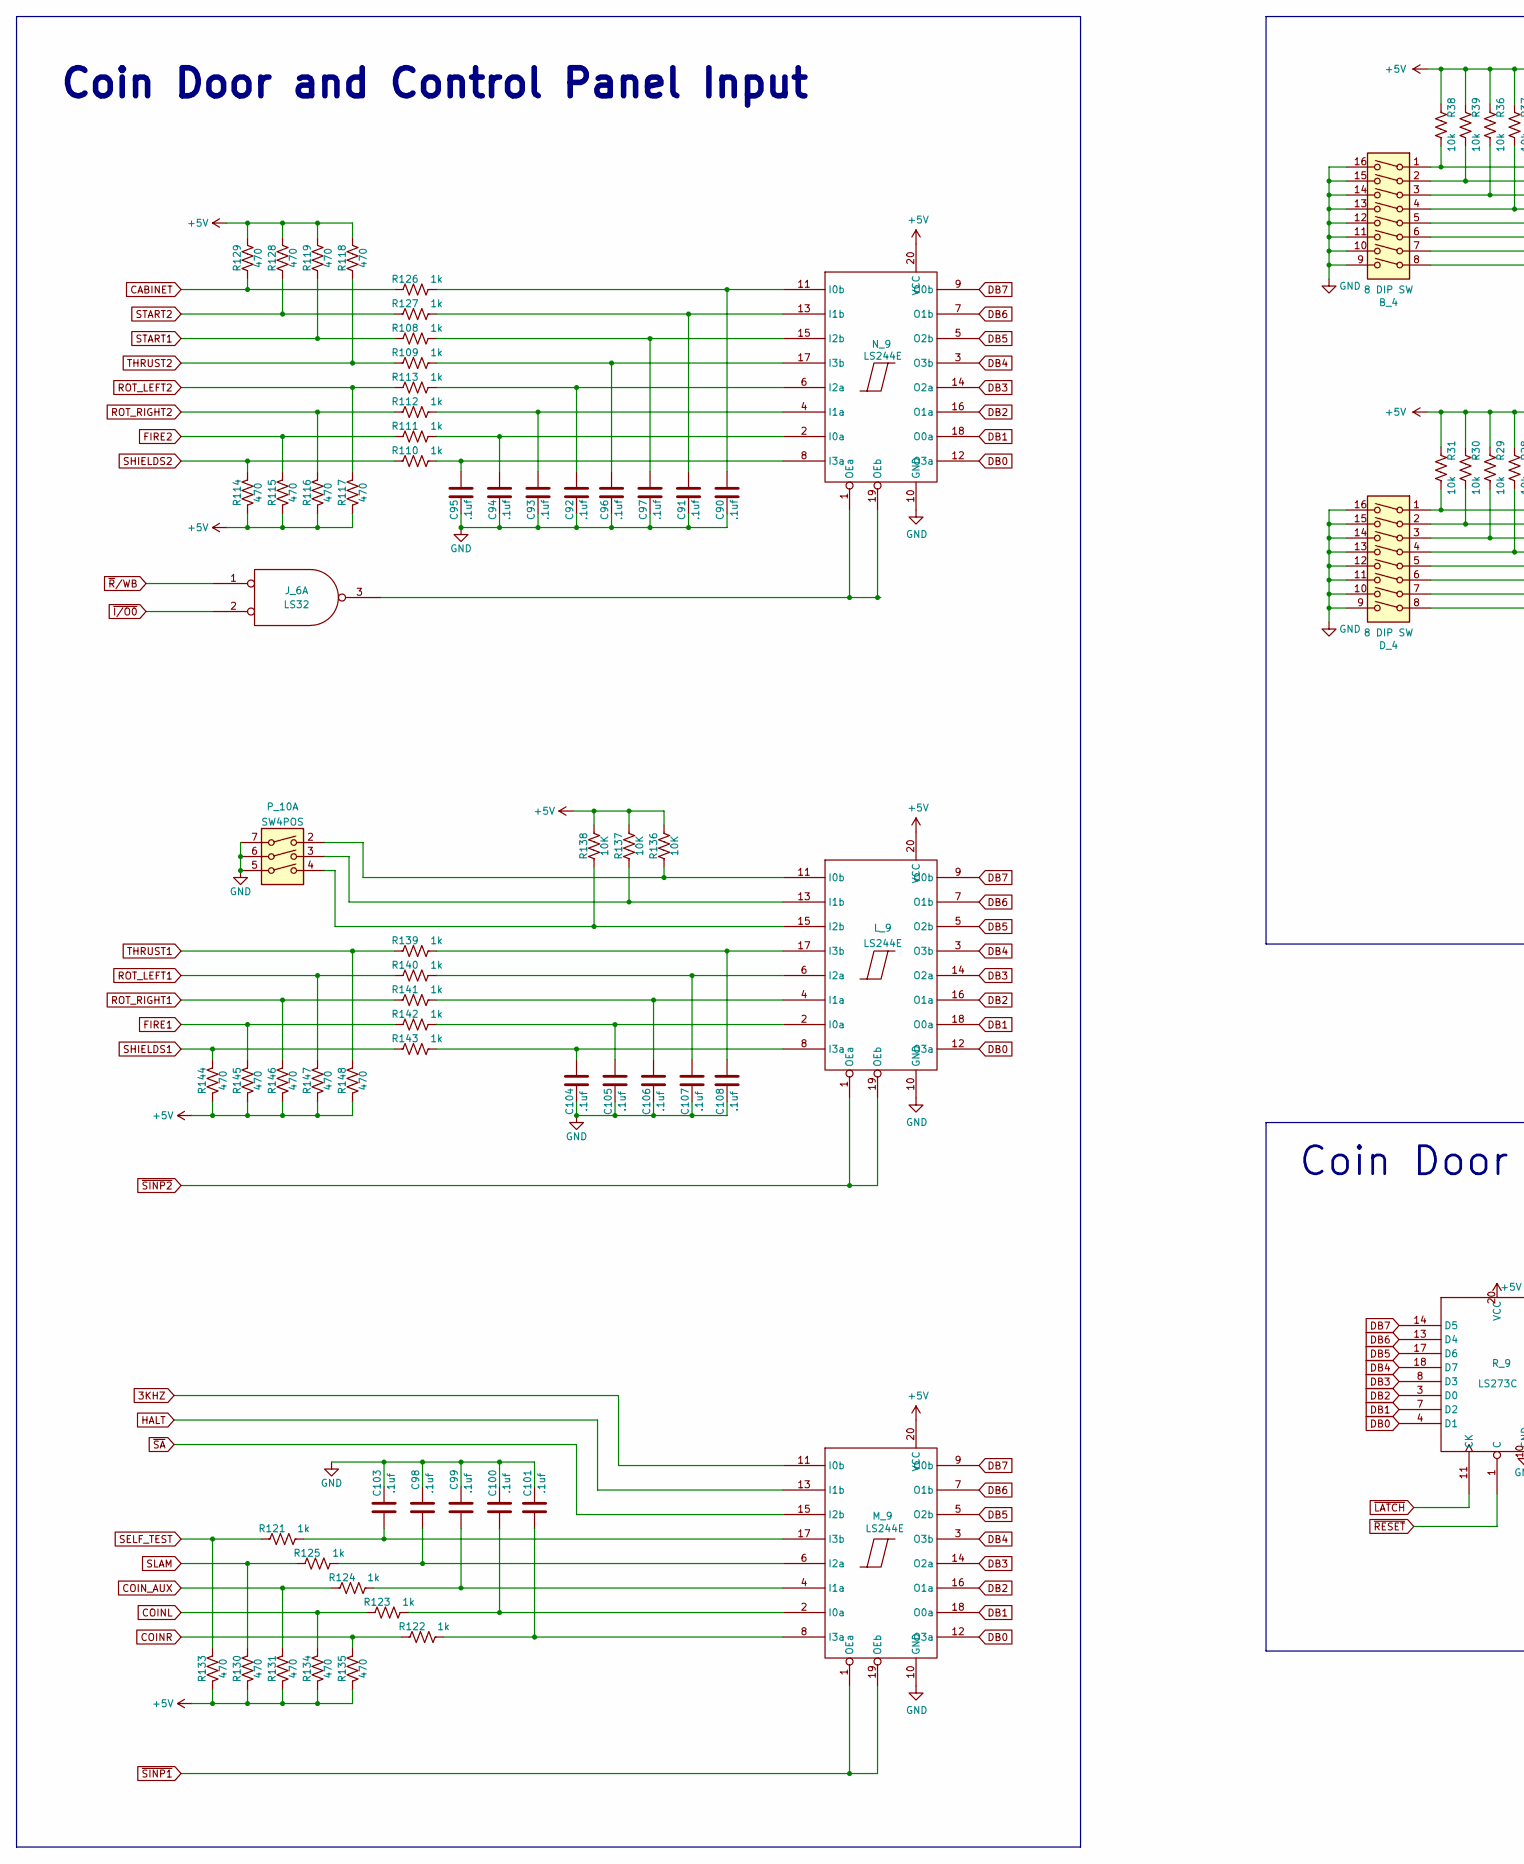
[picture p7: schematic Sheet5A.kicad_sch, part in row 1, column 1]

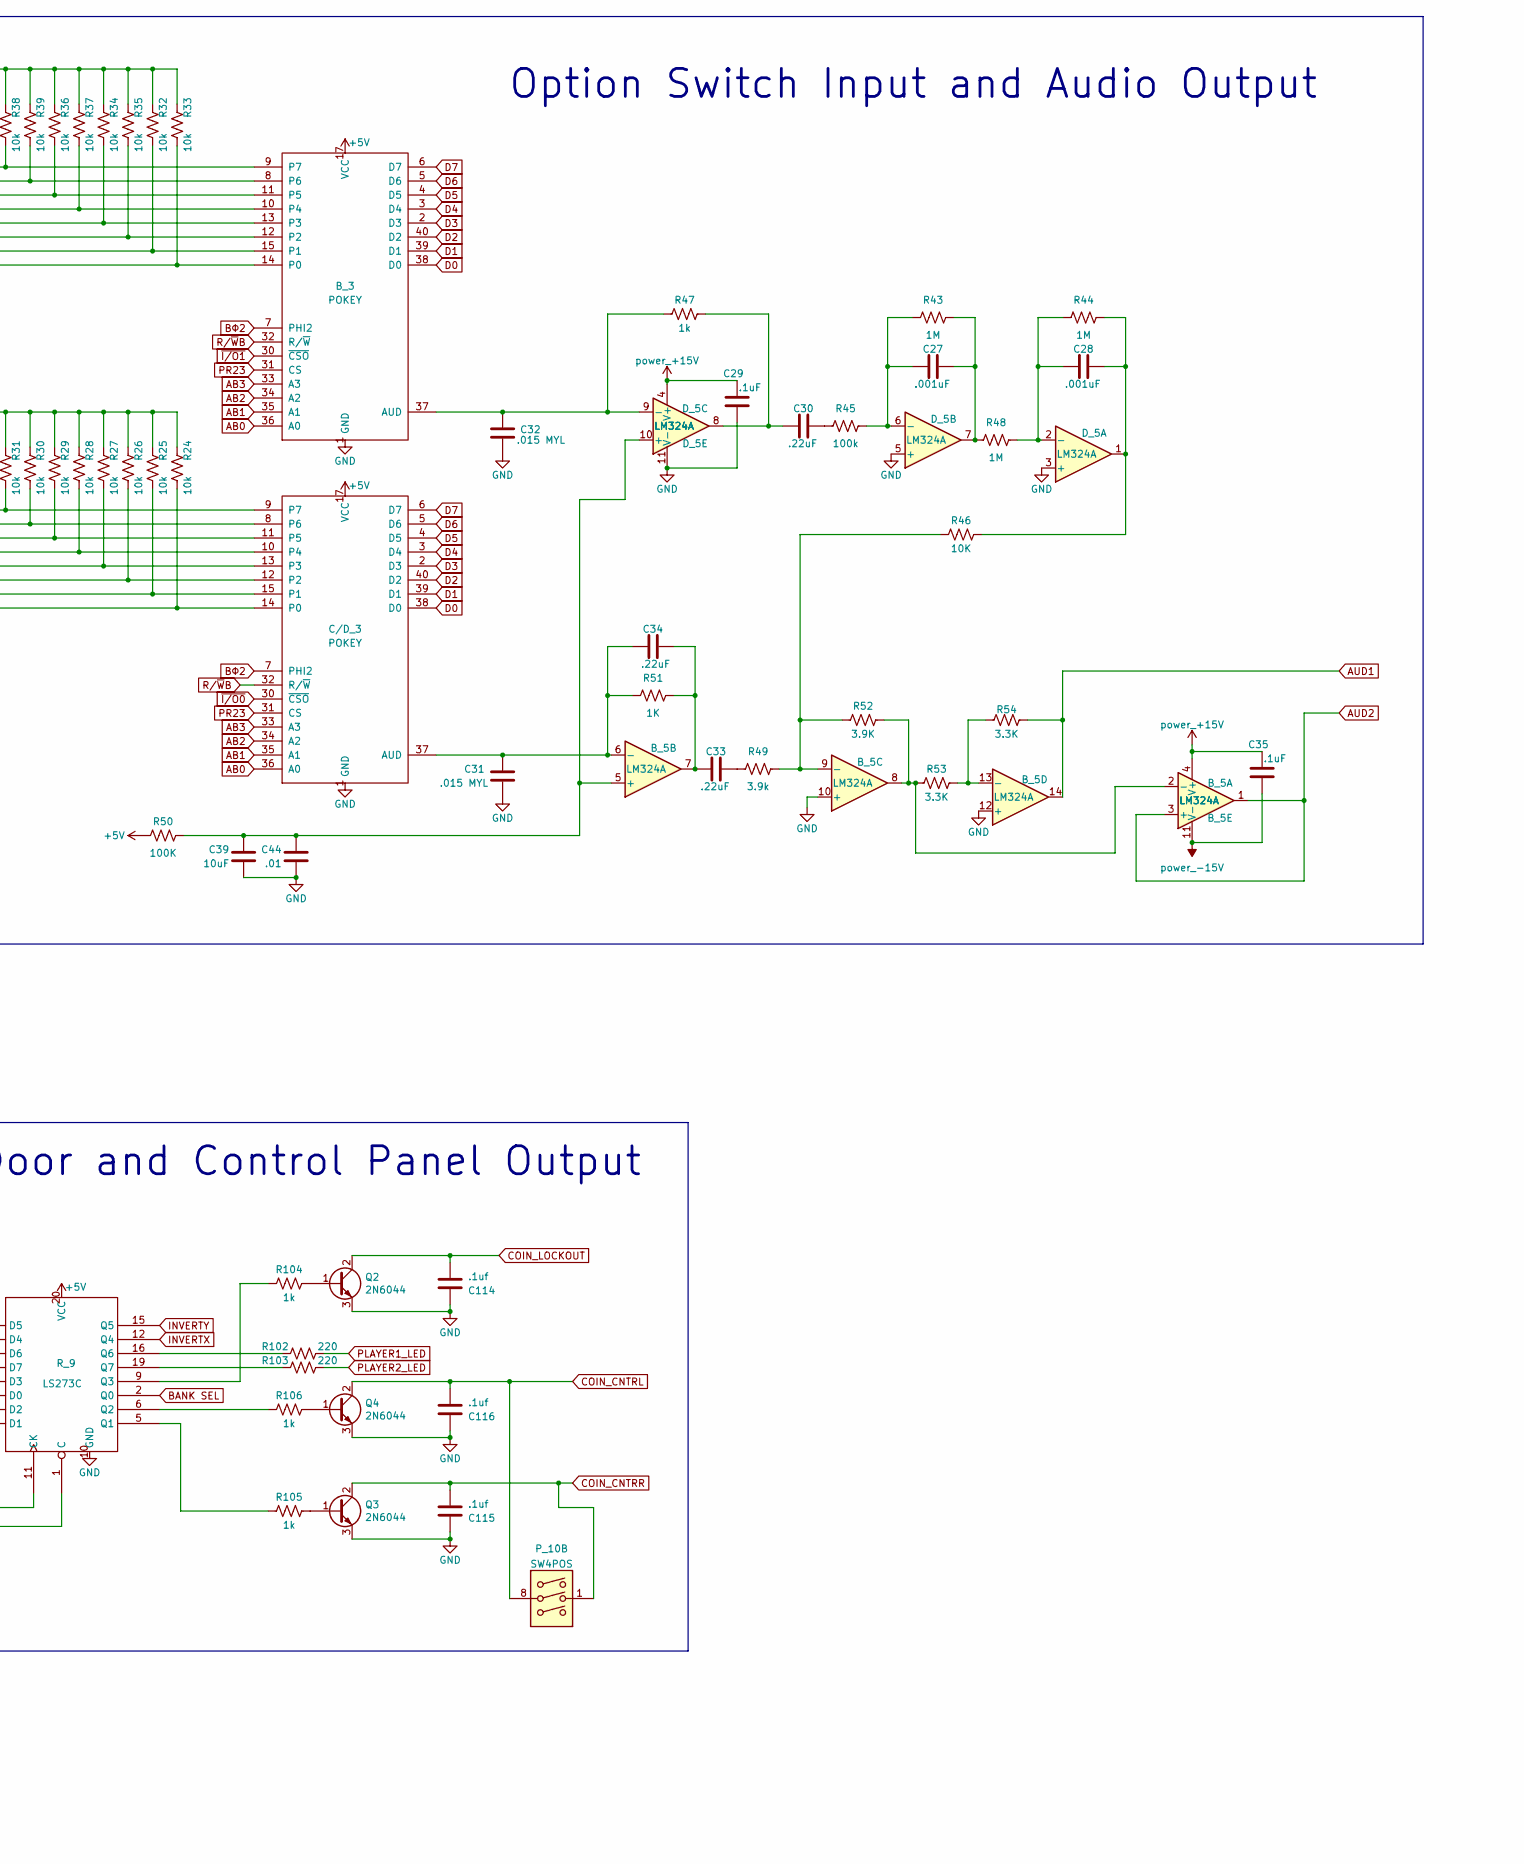
[picture p8: schematic Sheet5A.kicad_sch, part in row 1, column 2]

Parts:
B_3: POKEY
B_4: 8 DIP SW
B_5: LM324A
C27, C28: .001uF
C29, C35: .1uF
C30, C33, C34: .22uF
C31, C32: .015 MYL
C39: 10uF
C44: .01
C90, C91, C92, C93, C94, C95, C96, C97, C98, C99, C100, C101, C103, C104, C105, C106, C107, C108, C114, C115, C116: .1uf
C/D_3: POKEY
D_4: 8 DIP SW
D_5: LM324A
J_6: LS32
L_9: LS244E
M_9: LS244E
N_9: LS244E
P_10: SW4POS
Q2, Q3, Q4: 2N6044
R24, R25, R26, R27, R28, R29, R30, R31, R32, R33, R34, R35, R36, R37, R38, R39: 10k
R43, R44, R48: 1M
R45: 100k
R46, R136, R137, R138: 10K
R47, R104, R105, R106, R108, R109, R110, R111, R112, R113, R121, R122, R123, R124, R125, R126, R127, R139, R140, R141, R142, R143: 1k
R49: 3.9k
R50: 100K
R51: 1K
R52: 3.9K
R53, R54: 3.3K
R102, R103: 220
R114, R115, R116, R117, R118, R119, R128, R129, R130, R131, R133, R134, R135, R144, R145, R146, R147, R148: 470
R_9: LS273C

Connections:
3KHZ: M_9.11 (I0b)
+5V: B_3.17 (VCC), C/D_3.17 (VCC), L_9.20 (VCC), M_9.20 (VCC), N_9.20 (VCC), R24.2, R25.2, R26.2, R27.2, R28.2, R29.2, R30.2, R31.2, R32.2, R33.2, R34.2, R35.2, R36.2, R37.2, R38.2, R39.2, R50.2, R114.1, R115.1, R116.1, R117.1, R118.1, R119.1, R128.1, R129.1, R130.1, R131.1, R133.1, R134.1, R135.1, R136.1, R137.1, R138.1, R144.1, R145.1, R146.1, R147.1, R148.1, R_9.20 (VCC)
AB0: B_3.36 (A0), C/D_3.36 (A0)
AB1: B_3.35 (A1), C/D_3.35 (A1)
AB2: B_3.34 (A2), C/D_3.34 (A2)
AB3: B_3.33 (A3), C/D_3.33 (A3)
AUD1: B_5.14, R54.1
AUD2: B_5.1, B_5.3 (+)
BANK SEL: R_9.2 (Q0)
BΦ2: B_3.7 (PHI2), C/D_3.7 (PHI2)
CABINET: R126.2, R129.2
COINL: R123.2, R134.2
COINR: R122.2, R135.2
COIN_AUX: R124.2, R131.2
COIN_CNTRL: C116.1, P_10.8, Q4.2 (C)
COIN_CNTRR: C115.1, P_10.1, Q3.2 (C)
COIN_LOCKOUT: C114.1, Q2.2 (C)
D0: B_3.38 (D0), C/D_3.38 (D0)
D1: B_3.39 (D1), C/D_3.39 (D1)
D2: B_3.40 (D2), C/D_3.40 (D2)
D3: B_3.2 (D3), C/D_3.2 (D3)
D4: B_3.3 (D4), C/D_3.3 (D4)
D5: B_3.4 (D5), C/D_3.4 (D5)
D6: B_3.5 (D6), C/D_3.5 (D6)
D7: B_3.6 (D7), C/D_3.6 (D7)
DB0: L_9.12 (O3a), M_9.12 (O3a), N_9.12 (O3a), R_9.4 (D1)
DB1: L_9.18 (O0a), M_9.18 (O0a), N_9.18 (O0a), R_9.7 (D2)
DB2: L_9.16 (O1a), M_9.16 (O1a), N_9.16 (O1a), R_9.3 (D0)
DB3: L_9.14 (O2a), M_9.14 (O2a), N_9.14 (O2a), R_9.8 (D3)
DB4: L_9.3 (O3b), M_9.3 (O3b), N_9.3 (O3b), R_9.18 (D7)
DB5: L_9.5 (O2b), M_9.5 (O2b), N_9.5 (O2b), R_9.17 (D6)
DB6: L_9.7 (O1b), M_9.7 (O1b), N_9.7 (O1b), R_9.13 (D4)
DB7: L_9.9 (O0b), M_9.9 (O0b), N_9.9 (O0b), R_9.14 (D5)
FIRE1: R142.2, R145.2
FIRE2: R111.2, R115.2
GND: B_3.1 (GND), B_4.9, B_4.10, B_4.11, B_4.12, B_4.13, B_4.14, B_4.15, B_4.16, B_5.10 (+), B_5.12 (+), C29.1, C31.1, C32.1, C39.1, C44.1, C90.2, C91.2, C92.2, C93.2, C94.2, C95.2, C96.2, C97.2, C98.2, C99.2, C100.2, C101.2, C103.2, C104.2, C105.2, C106.2, C107.2, C108.2, C114.2, C115.2, C116.2, C/D_3.1 (GND), D_4.9, D_4.10, D_4.11, D_4.12, D_4.13, D_4.14, D_4.15, D_4.16, D_5.3 (+), D_5.5 (+), D_5.11 (V-), L_9.10 (GND), M_9.10 (GND), N_9.10 (GND), P_10.5, P_10.6, P_10.7, Q2.3 (E), Q3.3 (E), Q4.3 (E), R_9.10 (GND)
HALT: M_9.13 (I1b)
INVERTX: R_9.12 (Q4)
INVERTY: R_9.15 (Q5)
unnamed: B_3.8 (P6), B_4.2, R39.1
unnamed: B_3.9 (P7), B_4.1, R38.1
unnamed: B_3.10 (P4), B_4.4, R37.1
unnamed: B_3.11 (P5), B_4.3, R36.1
unnamed: B_3.12 (P2), B_4.6, R35.1
unnamed: B_3.13 (P3), B_4.5, R34.1
unnamed: B_3.14 (P0), B_4.8, R33.1
unnamed: B_3.15 (P1), B_4.7, R32.1
unnamed: B_3.37 (AUD), C32.2, D_5.9 (-), R47.2
unnamed: B_5.2 (-), B_5.8, R52.1, R53.2
unnamed: B_5.5 (+), C39.2, C44.2, D_5.10 (+), R50.1
unnamed: B_5.6 (-), C31.2, C34.1, C/D_3.37 (AUD), R51.2
unnamed: B_5.7, C33.1, C34.2, R51.1
unnamed: B_5.9 (-), R46.2, R49.1, R52.2
unnamed: B_5.13 (-), R53.1, R54.2
unnamed: C27.1, D_5.6 (-), R43.2, R45.1
unnamed: C27.2, D_5.7, R43.1, R48.2
unnamed: C28.1, D_5.2 (-), R44.2, R48.1
unnamed: C28.2, D_5.1, R44.1, R46.1
unnamed: C30.1, D_5.8, R47.1
unnamed: C30.2, R45.2
unnamed: C33.2, R49.2
unnamed: C90.1, N_9.11 (I0b), R126.1
unnamed: C91.1, N_9.13 (I1b), R127.1
unnamed: C92.1, N_9.6 (I2a), R113.1
unnamed: C93.1, N_9.4 (I1a), R112.1
unnamed: C94.1, N_9.2 (I0a), R111.1
unnamed: C95.1, N_9.8 (I3a), R110.1
unnamed: C96.1, N_9.17 (I3b), R109.1
unnamed: C97.1, N_9.15 (I2b), R108.1
unnamed: C98.1, M_9.6 (I2a), R125.1
unnamed: C99.1, M_9.4 (I1a), R124.1
unnamed: C100.1, M_9.2 (I0a), R123.1
unnamed: C101.1, M_9.8 (I3a), R122.1
unnamed: C103.1, M_9.17 (I3b), R121.1
unnamed: C104.1, L_9.8 (I3a), R143.1
unnamed: C105.1, L_9.2 (I0a), R142.1
unnamed: C106.1, L_9.4 (I1a), R141.1
unnamed: C107.1, L_9.6 (I2a), R140.1
unnamed: C108.1, L_9.17 (I3b), R139.1
unnamed: C/D_3.8 (P6), D_4.2, R30.1
unnamed: C/D_3.9 (P7), D_4.1, R31.1
unnamed: C/D_3.10 (P4), D_4.4, R28.1
unnamed: C/D_3.11 (P5), D_4.3, R29.1
unnamed: C/D_3.12 (P2), D_4.6, R26.1
unnamed: C/D_3.13 (P3), D_4.5, R27.1
unnamed: C/D_3.14 (P0), D_4.8, R24.1
unnamed: C/D_3.15 (P1), D_4.7, R25.1
unnamed: L_9.11 (I0b), P_10.2, R136.2
unnamed: L_9.13 (I1b), P_10.3, R137.2
unnamed: L_9.15 (I2b), P_10.4, R138.2
unnamed: N_9.1 (OEa), N_9.19 (OEb)
unnamed: Q2.1 (B), R104.1
unnamed: Q3.1 (B), R105.1
unnamed: Q4.1 (B), R106.1
unnamed: R102.2, R_9.16 (Q6)
unnamed: R103.2, R_9.19 (Q7)
unnamed: R104.2, R_9.9 (Q3)
unnamed: R105.2, R_9.5 (Q1)
unnamed: R106.2, R_9.6 (Q2)
PLAYER1_LED: R102.1
PLAYER2_LED: R103.1
PR23: B_3.31 (CS), C/D_3.31 (CS)
ROT_LEFT1: R140.2, R147.2
ROT_LEFT2: R113.2, R117.2
ROT_RIGHT1: R141.2, R146.2
ROT_RIGHT2: R112.2, R116.2
R/~WB: B_3.32 (R/~W), C/D_3.32 (R/~W)
SELF_TEST: R121.2, R133.2
SHIELDS1: R143.2, R144.2
SHIELDS2: R110.2, R114.2
SLAM: R125.2, R130.2
START1: R108.2, R119.2
START2: R127.2, R128.2
THRUST1: R139.2, R148.2
THRUST2: R109.2, R118.2
power_+15V: B_5.4 (V+), C29.2, C35.2, D_5.4 (V+)
power_-15V: B_5.11 (V-), C35.1
~I/O0: C/D_3.30 (~CSO)
~I/O1: B_3.30 (~CSO)
~LATCH: R_9.11 (CK)
~RESET: R_9.1 (C)
~SA: M_9.15 (I2b)
~SINP1: M_9.1 (OEa), M_9.19 (OEb)
~SINP2: L_9.1 (OEa), L_9.19 (OEb)

Notes on the sheet:
Option Switch Input and Audio Output
Coin Door and Control Panel Input
Coin Door and Control Panel Output
