nmikstas/atari_gravitar_black_widow/kicad/atari_gravitar_black_widow/Sheet5B.kicad_sch

## KiCad design kicad/atari_gravitar_black_widow/Sheet5B.kicad_sch (2022-02-02, an earlier design)

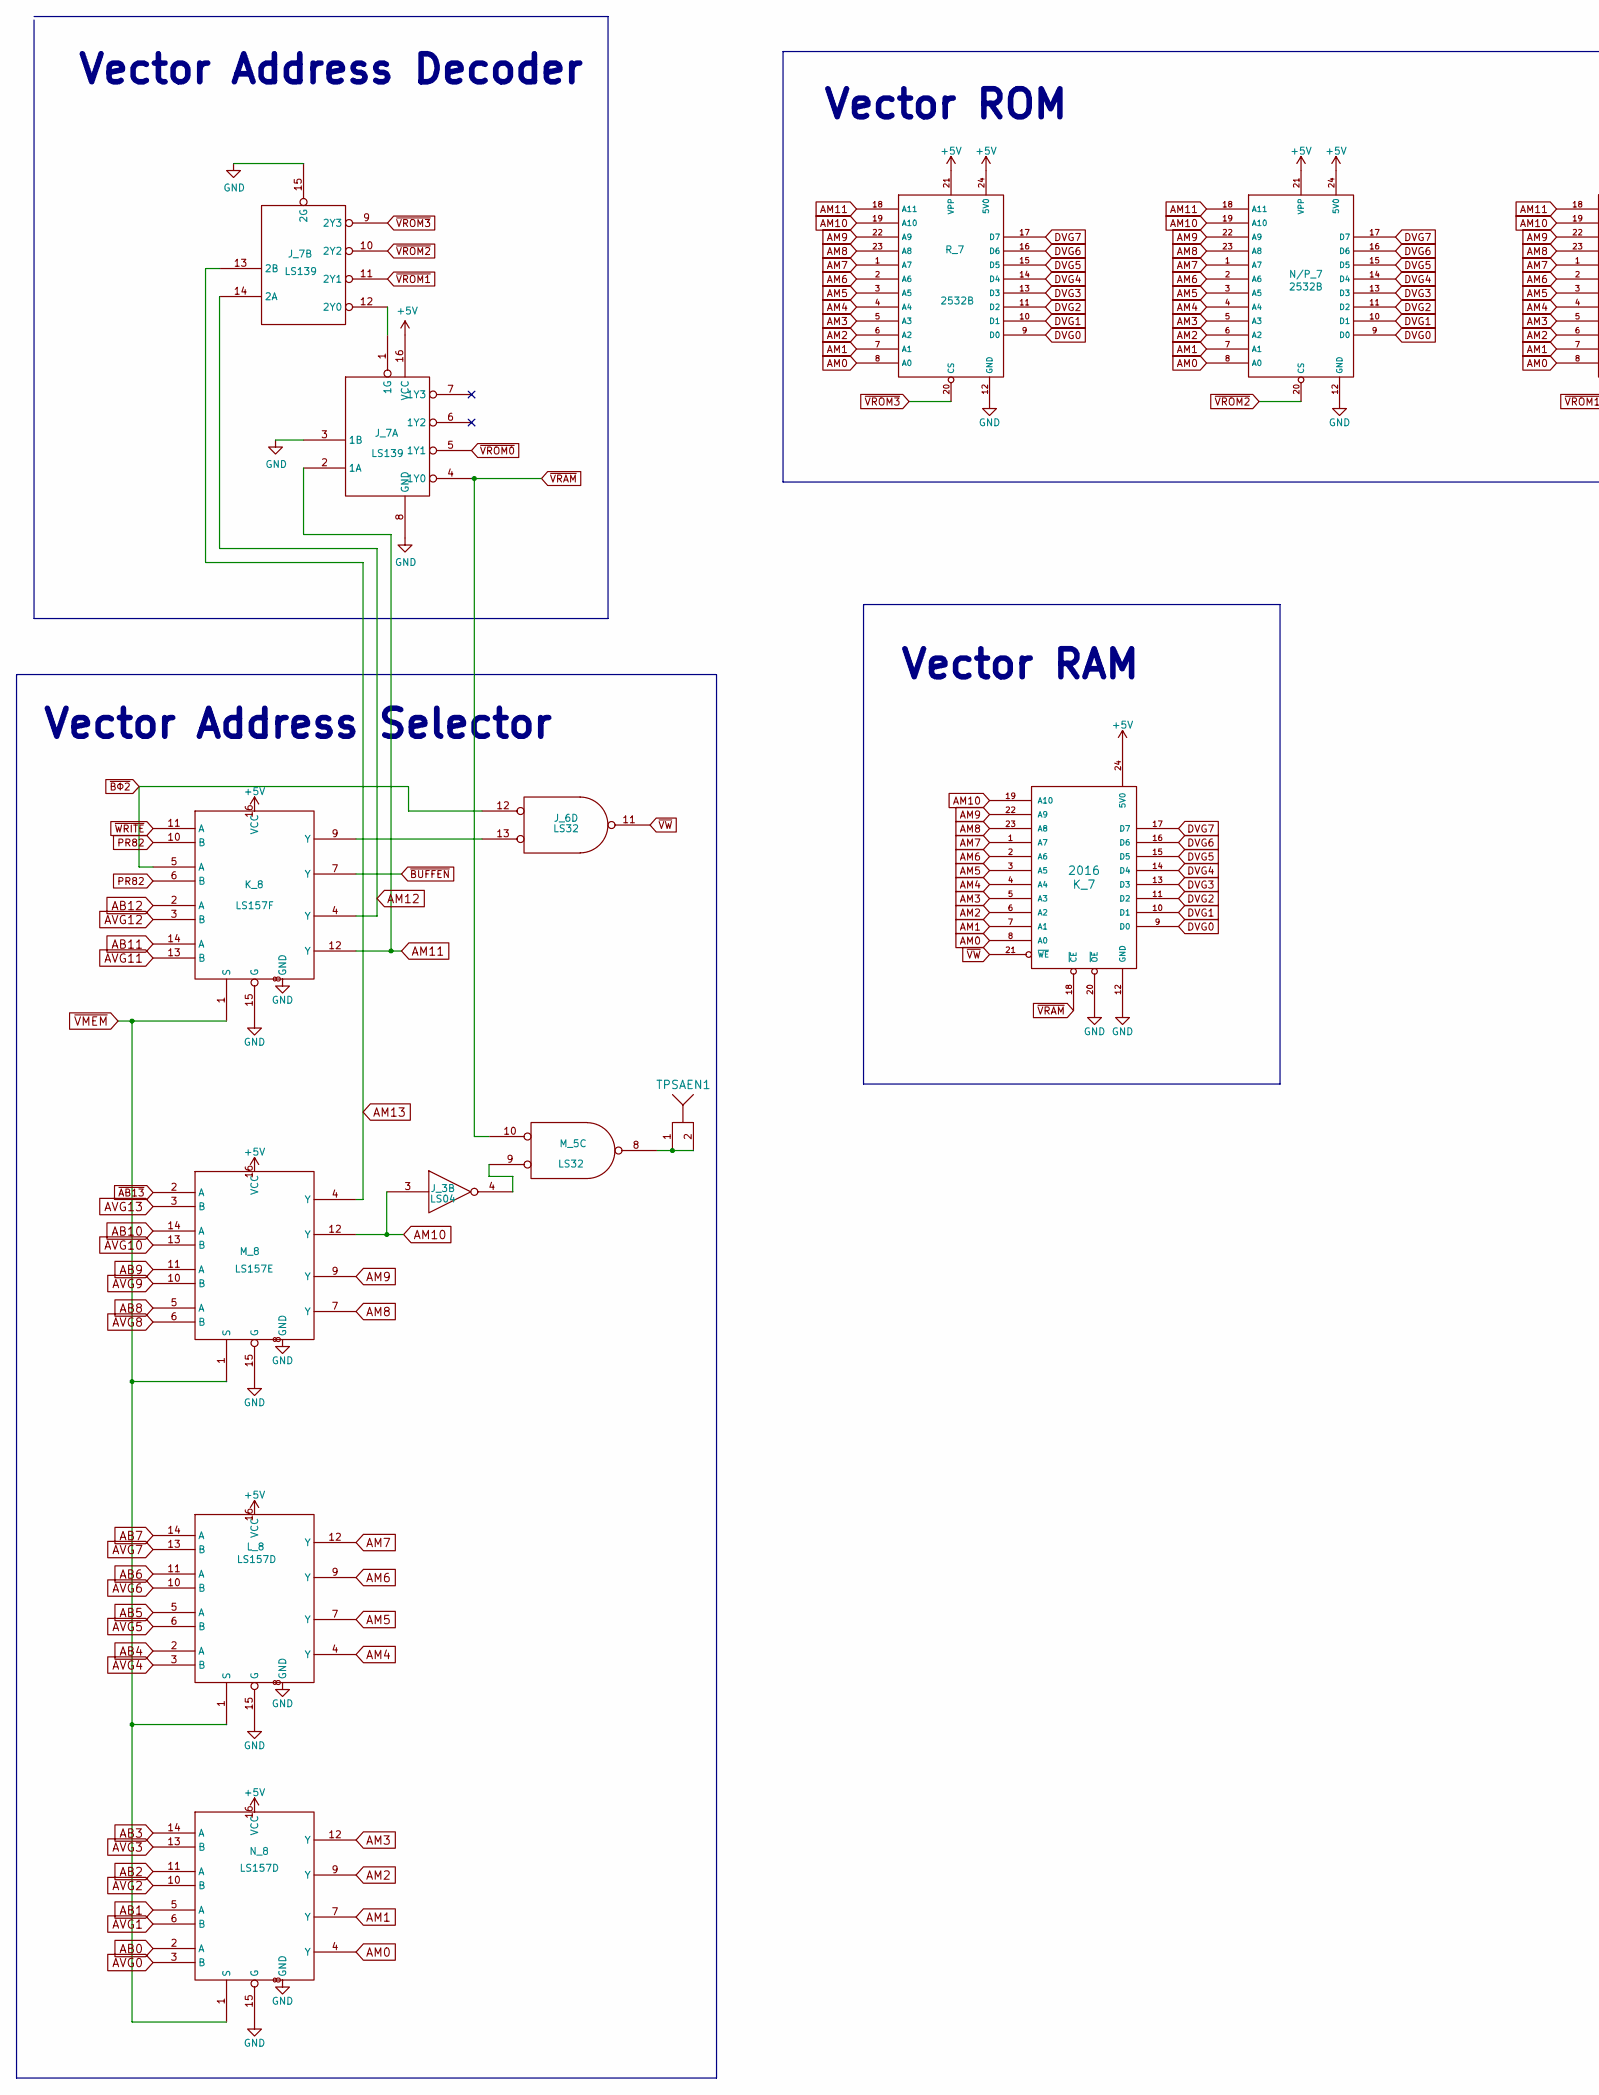
[picture p9: schematic Sheet5B.kicad_sch, part in row 1, column 1]

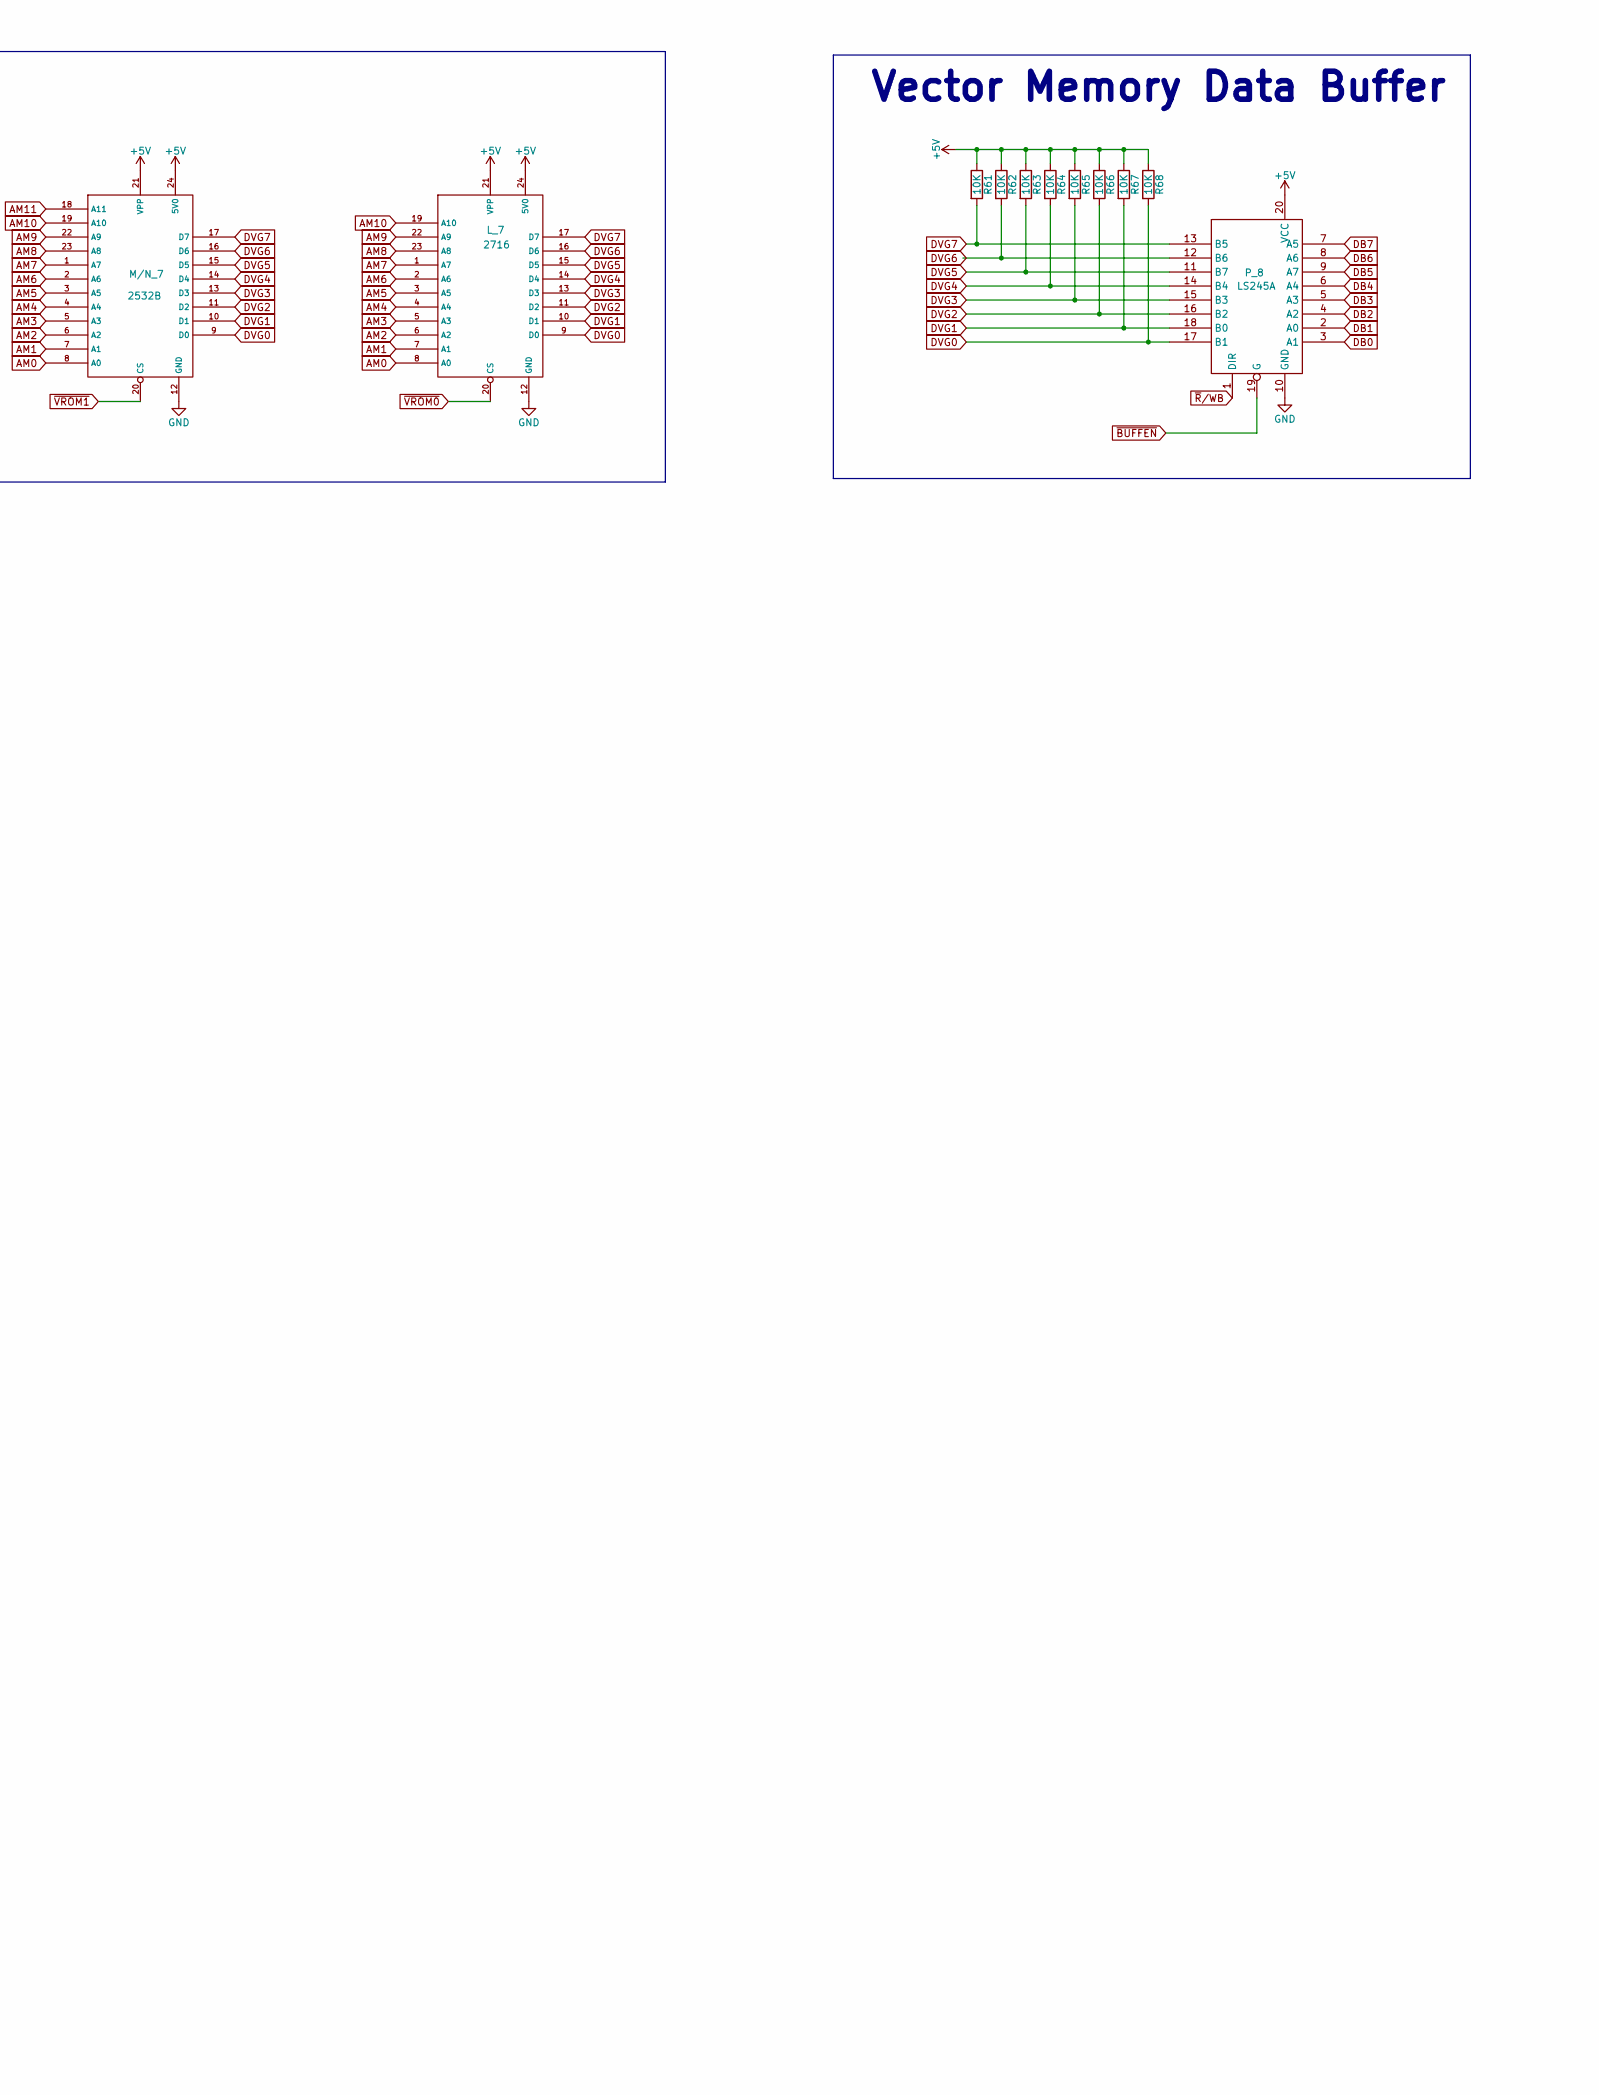
[picture p10: schematic Sheet5B.kicad_sch, part in row 1, column 2]

Parts:
J_3: LS04
J_6: LS32
J_7: LS139
K_7: 2016
K_8: LS157F
L_7: 2716
L_8: LS157D
M/N_7: 2532B
M_5: LS32
M_8: LS157E
N/P_7: 2532B
N_8: LS157D
P_8: LS245A
R61, R62, R63, R64, R65, R66, R67, R68: 10K
R_7: 2532B
TPSAEN1: TP

Connections:
+5V: J_7.16 (VCC), K_7.24 (5V0), K_8.16 (VCC), L_7.21 (VPP), L_7.24 (5V0), L_8.16 (VCC), M/N_7.21 (VPP), M/N_7.24 (5V0), M_8.16 (VCC), N/P_7.21 (VPP), N/P_7.24 (5V0), N_8.16 (VCC), P_8.20 (VCC), R61.1, R62.1, R63.1, R64.1, R65.1, R66.1, R67.1, R68.1, R_7.21 (VPP), R_7.24 (5V0)
AB0: N_8.2 (A)
AB1: N_8.5 (A)
AB2: N_8.11 (A)
AB3: N_8.14 (A)
AB4: L_8.2 (A)
AB5: L_8.5 (A)
AB6: L_8.11 (A)
AB7: L_8.14 (A)
AB8: M_8.5 (A)
AB9: M_8.11 (A)
AB10: M_8.14 (A)
AB11: K_8.14 (A)
AB12: K_8.2 (A)
AM0: K_7.8 (A0), L_7.8 (A0), M/N_7.8 (A0), N/P_7.8 (A0), N_8.4 (Y), R_7.8 (A0)
AM1: K_7.7 (A1), L_7.7 (A1), M/N_7.7 (A1), N/P_7.7 (A1), N_8.7 (Y), R_7.7 (A1)
AM2: K_7.6 (A2), L_7.6 (A2), M/N_7.6 (A2), N/P_7.6 (A2), N_8.9 (Y), R_7.6 (A2)
AM3: K_7.5 (A3), L_7.5 (A3), M/N_7.5 (A3), N/P_7.5 (A3), N_8.12 (Y), R_7.5 (A3)
AM4: K_7.4 (A4), L_7.4 (A4), L_8.4 (Y), M/N_7.4 (A4), N/P_7.4 (A4), R_7.4 (A4)
AM5: K_7.3 (A5), L_7.3 (A5), L_8.7 (Y), M/N_7.3 (A5), N/P_7.3 (A5), R_7.3 (A5)
AM6: K_7.2 (A6), L_7.2 (A6), L_8.9 (Y), M/N_7.2 (A6), N/P_7.2 (A6), R_7.2 (A6)
AM7: K_7.1 (A7), L_7.1 (A7), L_8.12 (Y), M/N_7.1 (A7), N/P_7.1 (A7), R_7.1 (A7)
AM8: K_7.23 (A8), L_7.23 (A8), M/N_7.23 (A8), M_8.7 (Y), N/P_7.23 (A8), R_7.23 (A8)
AM9: K_7.22 (A9), L_7.22 (A9), M/N_7.22 (A9), M_8.9 (Y), N/P_7.22 (A9), R_7.22 (A9)
AM10: J_3.3, K_7.19 (A10), L_7.19 (A10), M/N_7.19 (A10), M_8.12 (Y), N/P_7.19 (A10), R_7.19 (A10)
AM11: J_7.2 (1A), K_8.12 (Y), M/N_7.18 (A11), N/P_7.18 (A11), R_7.18 (A11)
AM12: J_7.14 (2A), K_8.4 (Y)
AM13: J_7.13 (2B), M_8.4 (Y)
AVG0: N_8.3 (B)
AVG1: N_8.6 (B)
AVG2: N_8.10 (B)
AVG3: N_8.13 (B)
AVG4: L_8.3 (B)
AVG5: L_8.6 (B)
AVG6: L_8.10 (B)
AVG7: L_8.13 (B)
AVG8: M_8.6 (B)
AVG9: M_8.10 (B)
AVG10: M_8.13 (B)
AVG11: K_8.13 (B)
AVG12: K_8.3 (B)
AVG13: M_8.3 (B)
DB0: P_8.3 (A1)
DB1: P_8.2 (A0)
DB2: P_8.4 (A2)
DB3: P_8.5 (A3)
DB4: P_8.6 (A4)
DB5: P_8.9 (A7)
DB6: P_8.8 (A6)
DB7: P_8.7 (A5)
DVG0: K_7.9 (D0), L_7.9 (D0), M/N_7.9 (D0), N/P_7.9 (D0), P_8.17 (B1), R68.2, R_7.9 (D0)
DVG1: K_7.10 (D1), L_7.10 (D1), M/N_7.10 (D1), N/P_7.10 (D1), P_8.18 (B0), R67.2, R_7.10 (D1)
DVG2: K_7.11 (D2), L_7.11 (D2), M/N_7.11 (D2), N/P_7.11 (D2), P_8.16 (B2), R66.2, R_7.11 (D2)
DVG3: K_7.13 (D3), L_7.13 (D3), M/N_7.13 (D3), N/P_7.13 (D3), P_8.15 (B3), R65.2, R_7.13 (D3)
DVG4: K_7.14 (D4), L_7.14 (D4), M/N_7.14 (D4), N/P_7.14 (D4), P_8.14 (B4), R64.2, R_7.14 (D4)
DVG5: K_7.15 (D5), L_7.15 (D5), M/N_7.15 (D5), N/P_7.15 (D5), P_8.11 (B7), R63.2, R_7.15 (D5)
DVG6: K_7.16 (D6), L_7.16 (D6), M/N_7.16 (D6), N/P_7.16 (D6), P_8.12 (B6), R62.2, R_7.16 (D6)
DVG7: K_7.17 (D7), L_7.17 (D7), M/N_7.17 (D7), N/P_7.17 (D7), P_8.13 (B5), R61.2, R_7.17 (D7)
GND: J_7.3 (1B), J_7.8 (GND), J_7.15 (2G), K_7.12 (GND), K_7.20 (~OE), K_8.8 (GND), K_8.15 (G), L_7.12 (GND), L_8.8 (GND), L_8.15 (G), M/N_7.12 (GND), M_8.8 (GND), M_8.15 (G), N/P_7.12 (GND), N_8.8 (GND), N_8.15 (G), P_8.10 (GND), R_7.12 (GND)
unnamed: J_7.1 (1G), J_7.12 (2Y0)
unnamed: TPSAEN1.1, TPSAEN1.2
PR82: K_8.6 (B), K_8.10 (B)
~AB13: M_8.2 (A)
~BUFFEN: K_8.7 (Y), P_8.19 (G)
~BΦ2: K_8.5 (A)
~R/WB: P_8.1 (DIR)
~VMEM: K_8.1 (S), L_8.1 (S), M_8.1 (S), N_8.1 (S)
~VRAM: J_7.4 (1Y0), K_7.18 (~CE)
~VROM0: J_7.5 (1Y1), L_7.20 (CS)
~VROM1: J_7.11 (2Y1), M/N_7.20 (CS)
~VROM2: J_7.10 (2Y2), N/P_7.20 (CS)
~VROM3: J_7.9 (2Y3), R_7.20 (CS)
~VW: K_7.21 (~WE)
~WRITE: K_8.11 (A)

Notes on the sheet:
Vector RAM
Vector ROM
Vector Address Selector
Vector Address Decoder
Vector Memory Data Buffer
