nmikstas/atari_gravitar_black_widow/kicad/atari_gravitar_black_widow/Sheet6A.kicad_sch

## KiCad design kicad/atari_gravitar_black_widow/Sheet6A.kicad_sch (2023-12-24, an earlier design)

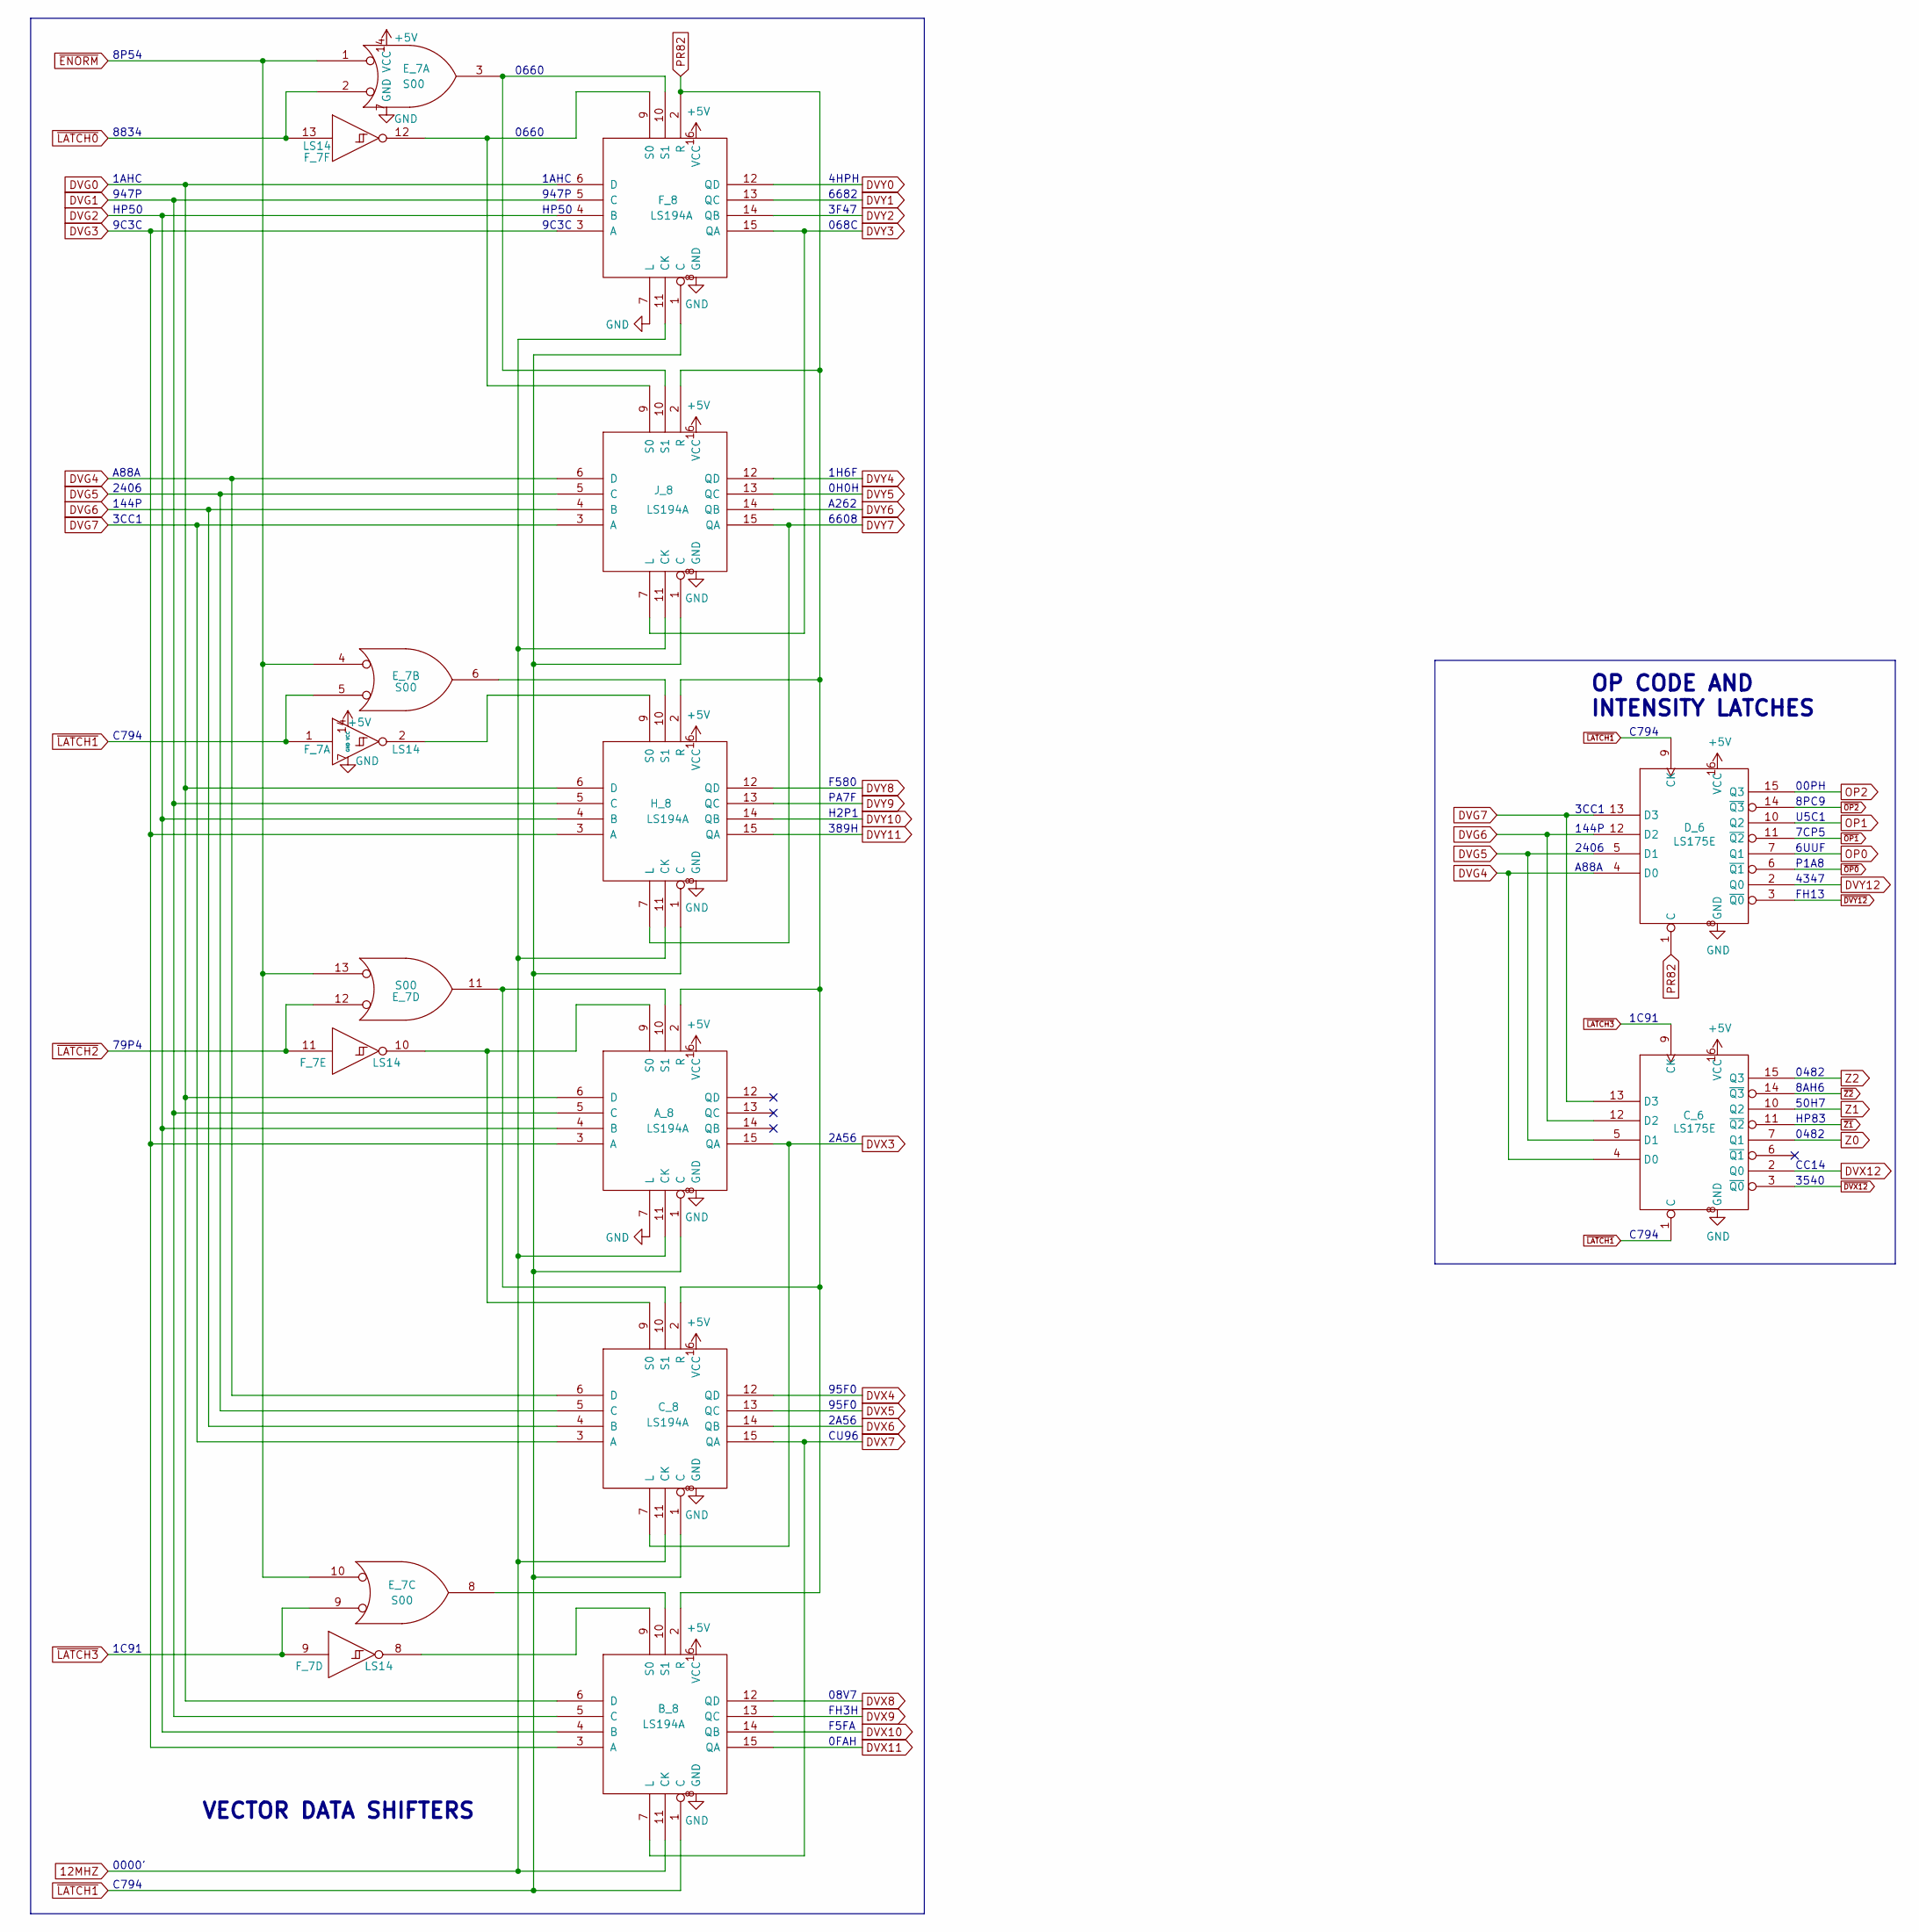
[picture p11: schematic Sheet6A.kicad_sch]

Parts:
A_8: LS194A
B_8: LS194A
C_6: LS175E
C_8: LS194A
D_6: LS175E
E_7: S00
F_7: LS14
F_8: LS194A
H_8: LS194A
J_8: LS194A

Connections:
12MHZ: A_8.11 (CK), B_8.11 (CK), C_8.11 (CK), F_8.11 (CK), H_8.11 (CK), J_8.11 (CK)
+5V: A_8.16 (VCC), B_8.16 (VCC), C_6.16 (VCC), C_8.16 (VCC), D_6.16 (VCC), E_7.14 (VCC), F_7.14 (VCC), F_8.16 (VCC), H_8.16 (VCC), J_8.16 (VCC)
DVG0: A_8.6 (D), B_8.6 (D), F_8.6 (D), H_8.6 (D)
DVG1: A_8.5 (C), B_8.5 (C), F_8.5 (C), H_8.5 (C)
DVG2: A_8.4 (B), B_8.4 (B), F_8.4 (B), H_8.4 (B)
DVG3: A_8.3 (A), B_8.3 (A), F_8.3 (A), H_8.3 (A)
DVG4: C_6.4 (D0), C_8.6 (D), D_6.4 (D0), J_8.6 (D)
DVG5: C_6.5 (D1), C_8.5 (C), D_6.5 (D1), J_8.5 (C)
DVG6: C_6.12 (D2), C_8.4 (B), D_6.12 (D2), J_8.4 (B)
DVG7: C_6.13 (D3), C_8.3 (A), D_6.13 (D3), J_8.3 (A)
DVX3: A_8.15 (QA), C_8.7 (L)
DVX4: C_8.12 (QD)
DVX5: C_8.13 (QC)
DVX6: C_8.14 (QB)
DVX7: B_8.7 (L), C_8.15 (QA)
DVX8: B_8.12 (QD)
DVX9: B_8.13 (QC)
DVX10: B_8.14 (QB)
DVX11: B_8.15 (QA)
DVX12: C_6.2 (Q0)
DVY0: F_8.12 (QD)
DVY1: F_8.13 (QC)
DVY2: F_8.14 (QB)
DVY3: F_8.15 (QA), J_8.7 (L)
DVY4: J_8.12 (QD)
DVY5: J_8.13 (QC)
DVY6: J_8.14 (QB)
DVY7: H_8.7 (L), J_8.15 (QA)
DVY8: H_8.12 (QD)
DVY9: H_8.13 (QC)
DVY10: H_8.14 (QB)
DVY11: H_8.15 (QA)
DVY12: D_6.2 (Q0)
GND: A_8.7 (L), A_8.8 (GND), B_8.8 (GND), C_6.8 (GND), C_8.8 (GND), D_6.8 (GND), E_7.7 (GND), F_7.7 (GND), F_8.7 (L), F_8.8 (GND), H_8.8 (GND), J_8.8 (GND)
unnamed: A_8.9 (S0), C_8.9 (S0), F_7.10
unnamed: A_8.10 (S1), C_8.10 (S1), E_7.11
unnamed: B_8.9 (S0), F_7.8
unnamed: B_8.10 (S1), E_7.8
unnamed: E_7.3, F_8.10 (S1), J_8.10 (S1)
unnamed: E_7.6, H_8.10 (S1)
unnamed: F_7.2, H_8.9 (S0)
unnamed: F_7.12, F_8.9 (S0), J_8.9 (S0)
OP0: D_6.7 (Q1)
OP1: D_6.10 (Q2)
OP2: D_6.15 (Q3)
PR82: A_8.2 (R), B_8.2 (R), C_8.2 (R), D_6.1 (C), F_8.2 (R), H_8.2 (R), J_8.2 (R)
Z0: C_6.7 (Q1)
Z1: C_6.10 (Q2)
Z2: C_6.15 (Q3)
~DVX12: C_6.3 (~Q0)
~DVY12: D_6.3 (~Q0)
~ENORM: E_7.1, E_7.5, E_7.9, E_7.12
~LATCH0: E_7.2, F_7.13
~LATCH1: A_8.1 (C), B_8.1 (C), C_6.1 (C), C_8.1 (C), D_6.9 (CK), E_7.4, F_7.1, F_8.1 (C), H_8.1 (C), J_8.1 (C)
~LATCH2: E_7.13, F_7.11
~LATCH3: C_6.9 (CK), E_7.10, F_7.9
~OP0: D_6.6 (~Q1)
~OP1: D_6.11 (~Q2)
~OP2: D_6.14 (~Q3)
~Z1: C_6.11 (~Q2)
~Z2: C_6.14 (~Q3)

Notes on the sheet:
FH13
2406
3CC1
8P54
3540
1H6F
CC14
068C
6608
F5FA
A88A
HP50
6UUF
95F0
2A56
0482
CU96
7CP5
C794
6682
0FAH
4347
947P
PA7F
8834
00PH
FH3H
9C3C
0H0H
1C91
50H7
389H
OP CODE AND INTENSITY LATCHES
144P
VECTOR DATA SHIFTERS
1AHC
0000'
P1A8
0660
A262
F580
3F47
8PC9
H2P1
8AH6
U5C1
HP83
79P4
4HPH
08V7
