nmikstas/atari_gravitar_black_widow/kicad/atari_gravitar_black_widow/Sheet6B.kicad_sch

## KiCad design kicad/atari_gravitar_black_widow/Sheet6B.kicad_sch (2023-12-24, an earlier design)

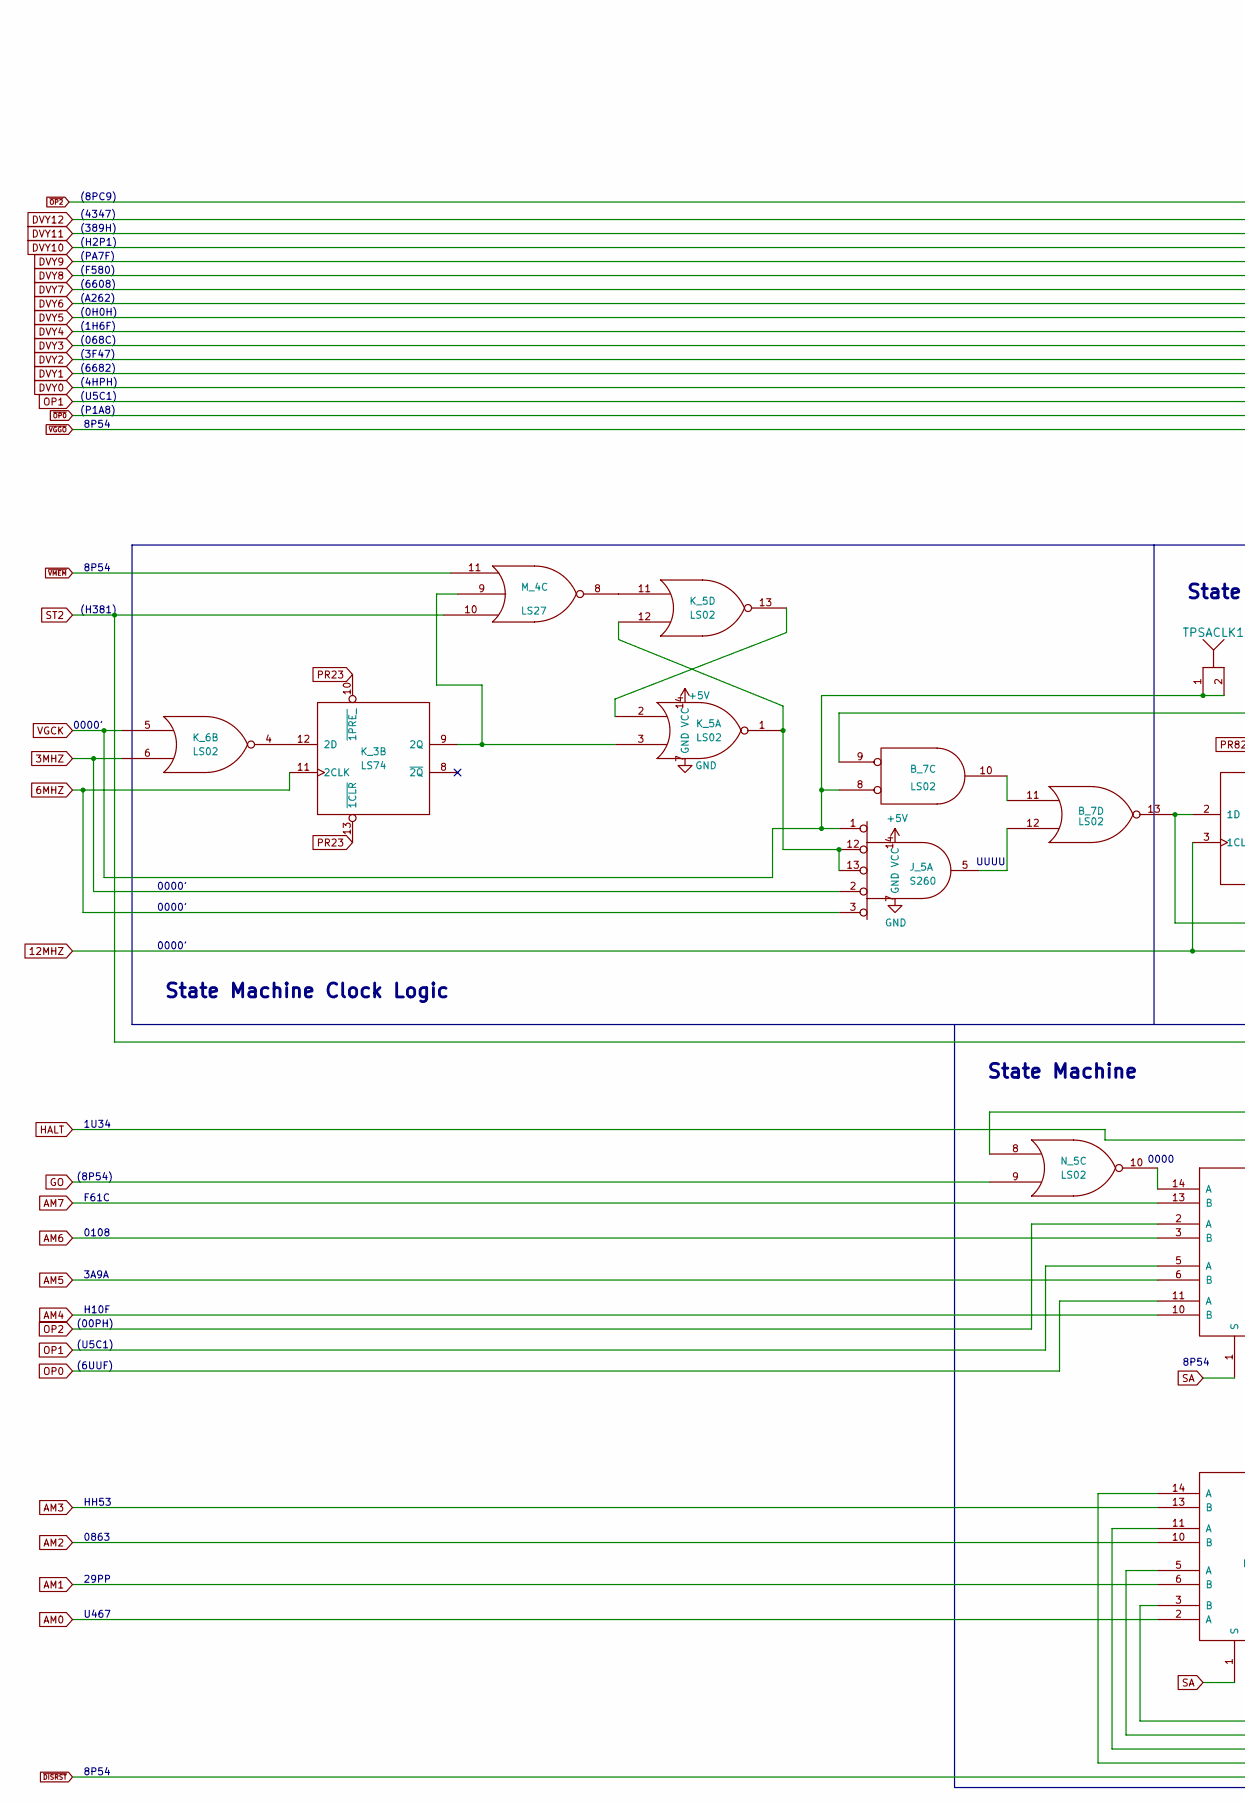
[picture p12: schematic Sheet6B.kicad_sch, part in row 1, column 1]

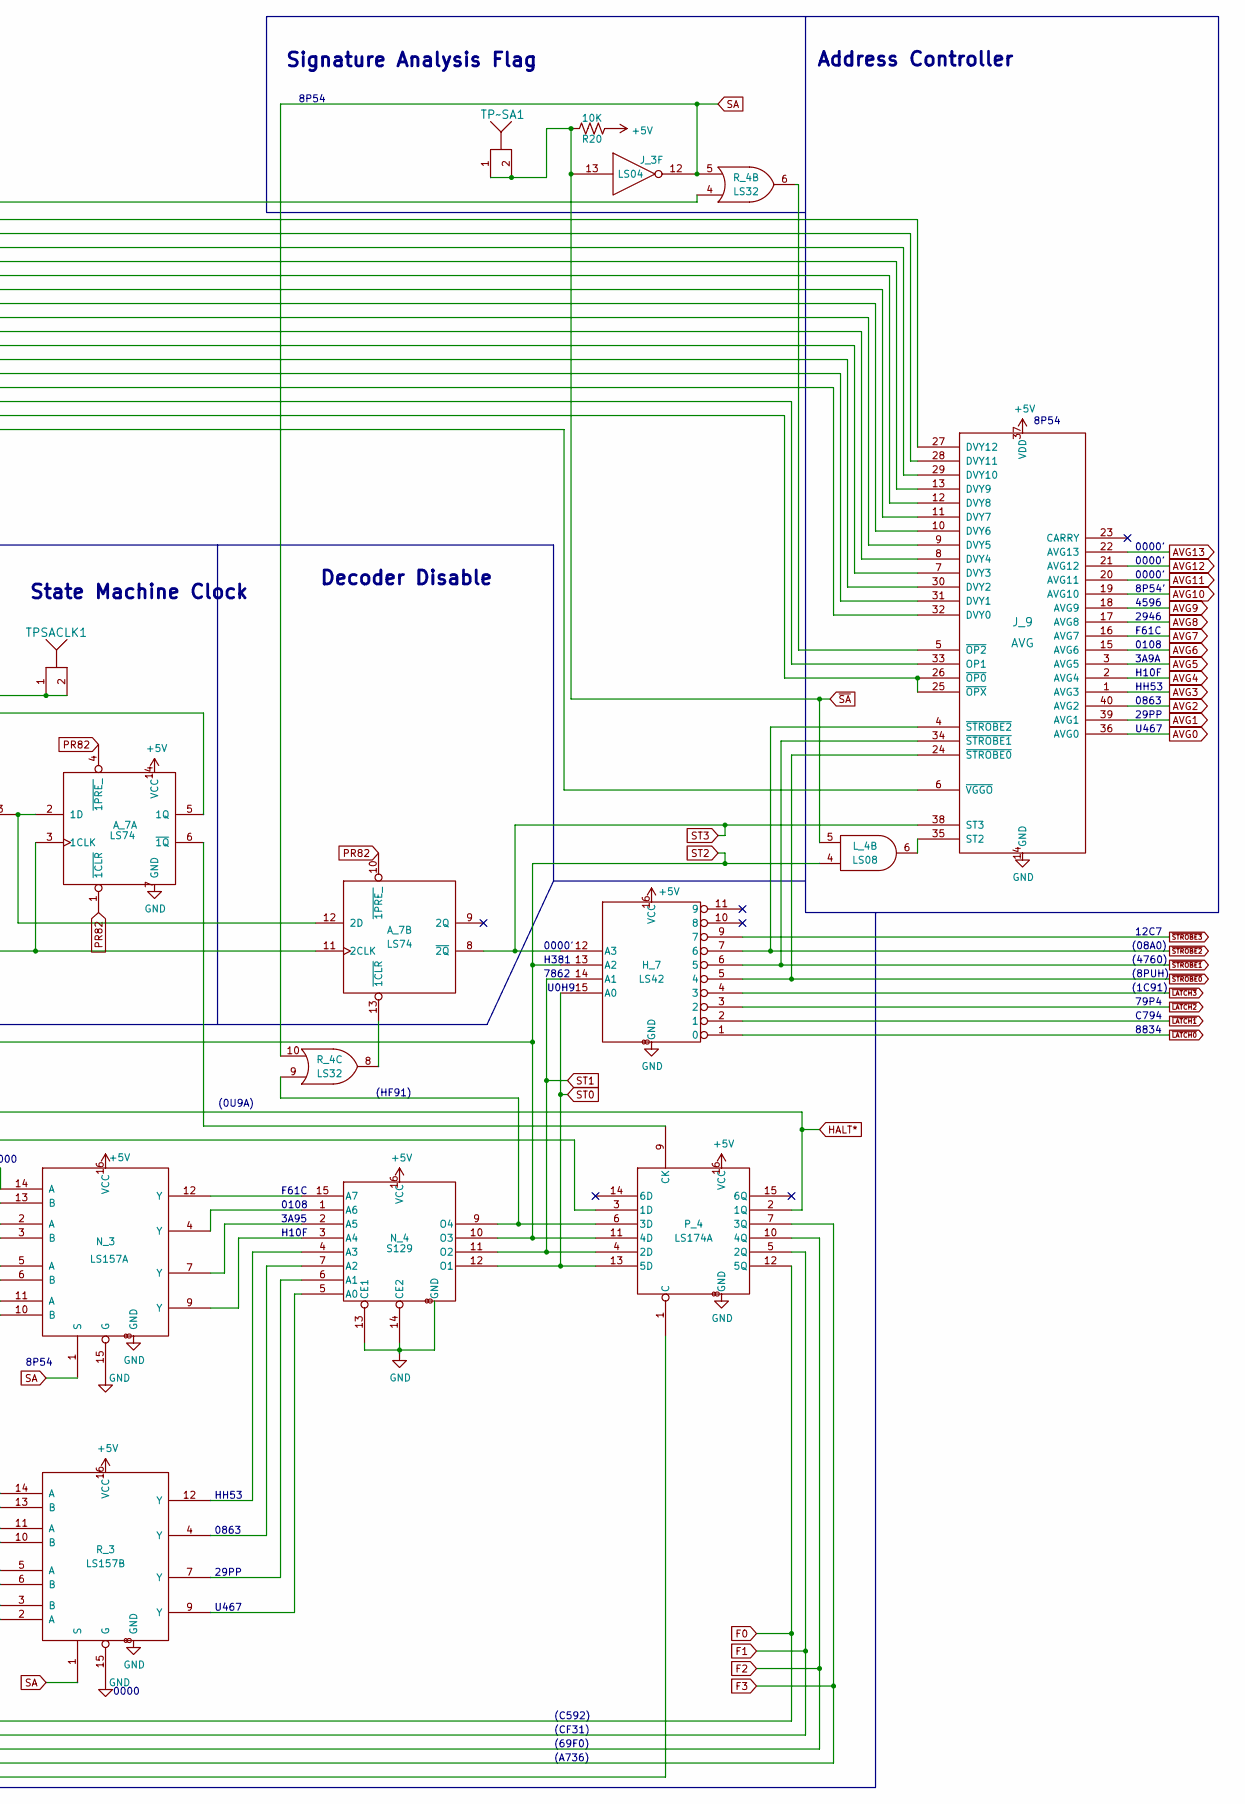
[picture p13: schematic Sheet6B.kicad_sch, part in row 1, column 2]

Parts:
A_7: LS74
B_7: LS02
H_7: LS42
J_3: LS04
J_5: S260
J_9: AVG
K_3: LS74
K_5, K_6: LS02
L_4: LS08
M_4: LS27
N_3: LS157A
N_4: S129
N_5: LS02
P_4: LS174A
R20: 10K
R_3: LS157B
R_4: LS32
TPSACLK1: TP
TP~SA1: TP

Connections:
3MHZ: K_6.6
6MHZ: K_3.11 (2CLK)
12MHZ: A_7.3 (1CLK), A_7.11 (2CLK)
+5V: A_7.14 (VCC), H_7.16 (VCC), J_5.14 (VCC), J_9.37 (VDD), K_5.14 (VCC), N_3.16 (VCC), N_4.16 (VCC), P_4.16 (VCC), R20.1, R_3.16 (VCC)
AM0: R_3.2 (A)
AM1: R_3.6 (B)
AM2: R_3.10 (B)
AM3: R_3.13 (B)
AM4: N_3.10 (B)
AM5: N_3.6 (B)
AM6: N_3.3 (B)
AM7: N_3.13 (B)
AVG0: J_9.36 (AVG0)
AVG1: J_9.39 (AVG1)
AVG2: J_9.40 (AVG2)
AVG3: J_9.1 (AVG3)
AVG4: J_9.2 (AVG4)
AVG5: J_9.3 (AVG5)
AVG6: J_9.15 (AVG6)
AVG7: J_9.16 (AVG7)
AVG8: J_9.17 (AVG8)
AVG9: J_9.18 (AVG9)
AVG10: J_9.19 (AVG10)
AVG11: J_9.20 (AVG11)
AVG12: J_9.21 (AVG12)
AVG13: J_9.22 (AVG13)
DVY0: J_9.32 (DVY0)
DVY1: J_9.31 (DVY1)
DVY2: J_9.30 (DVY2)
DVY3: J_9.7 (DVY3)
DVY4: J_9.8 (DVY4)
DVY5: J_9.9 (DVY5)
DVY6: J_9.10 (DVY6)
DVY7: J_9.11 (DVY7)
DVY8: J_9.12 (DVY8)
DVY9: J_9.13 (DVY9)
DVY10: J_9.29 (DVY10)
DVY11: J_9.28 (DVY11)
DVY12: J_9.27 (DVY12)
F0: P_4.12 (5Q), R_3.3 (B)
F1: P_4.5 (2Q), R_3.5 (A)
F2: P_4.10 (4Q), R_3.11 (A)
F3: P_4.7 (3Q), R_3.14 (A)
GND: A_7.7 (GND), H_7.8 (GND), J_5.7 (GND), J_9.14 (GND), K_5.7 (GND), N_3.8 (GND), N_3.15 (G), N_4.8 (GND), N_4.13 (CE1), N_4.14 (CE2), P_4.8 (GND), R_3.8 (GND), R_3.15 (G)
GO: N_5.9
HALT: P_4.3 (1D)
HALT*: N_5.8, P_4.2 (1Q)
unnamed: A_7.5 (1Q), B_7.9
unnamed: A_7.6 (~1Q), P_4.9 (CK)
unnamed: A_7.2 (1D), A_7.12 (2D), B_7.13
unnamed: A_7.13 (~1CLR), R_4.8
unnamed: B_7.10, B_7.11
unnamed: B_7.12, J_5.5
unnamed: J_9.5 (~OP2), R_4.6
unnamed: J_9.35 (ST2), L_4.6
unnamed: K_3.9 (2Q), K_5.3, M_4.9
unnamed: K_3.12 (2D), K_6.4
unnamed: K_5.1, K_5.12
unnamed: K_5.11, M_4.8
unnamed: K_5.2, K_5.13
unnamed: N_3.4 (Y), N_4.1 (A6)
unnamed: N_3.7 (Y), N_4.2 (A5)
unnamed: N_3.9 (Y), N_4.3 (A4)
unnamed: N_3.12 (Y), N_4.15 (A7)
unnamed: N_3.14 (A), N_5.10
unnamed: N_4.4 (A3), R_3.12 (Y)
unnamed: N_4.5 (A0), R_3.9 (Y)
unnamed: N_4.6 (A1), R_3.7 (Y)
unnamed: N_4.7 (A2), R_3.4 (Y)
unnamed: N_4.9 (O4), P_4.6 (3D), R_4.9
OP0: N_3.11 (A)
OP1: J_9.33 (OP1), N_3.5 (A)
OP2: N_3.2 (A)
PR23: K_3.10 (~1PRE_), K_3.13 (~1CLR)
PR82: A_7.1 (~1CLR), A_7.4 (~1PRE_), A_7.10 (~1PRE_)
SA: J_3.12, N_3.1 (S), R_3.1 (S), R_4.5, R_4.10
ST0: H_7.15 (A0), N_4.12 (O1), P_4.13 (5D)
ST1: H_7.14 (A1), N_4.11 (O2), P_4.4 (2D)
ST2: H_7.13 (A2), L_4.4, M_4.10, N_4.10 (O3), P_4.11 (4D)
ST3: A_7.8 (~2Q), H_7.12 (A3), J_9.38 (ST3)
VGCK: B_7.8, K_6.5, TPSACLK1.1, TPSACLK1.2
~DISRST: P_4.1 (C)
~LATCH0: H_7.1 (0)
~LATCH1: H_7.2 (1)
~LATCH2: H_7.3 (2)
~LATCH3: H_7.4 (3)
~OP0: J_9.25 (~OPX), J_9.26 (~OP0)
~OP2: R_4.4
~SA: J_3.13, L_4.5, R20.2, TP~SA1.1, TP~SA1.2
~STROBE0: H_7.5 (4), J_9.24 (~STROBE0)
~STROBE1: H_7.6 (5), J_9.34 (~STROBE1)
~STROBE2: H_7.7 (6), J_9.4 (~STROBE2)
~STROBE3: H_7.9 (7)
~VGGO: J_9.6 (~VGGO)
~VMEM: M_4.11

Notes on the sheet:
(08A0)
3A95
U467
0000'
HH53
0108
(0H0H)
F61C
7862
(A262)
79P4
H381
(F580)
29PP
8P54'
(8PUH)
(389H)
8P54
(PA7F)
Signature Analysis Flag
(H381)
(H2P1)
State Machine Clock Logic
U0H9
Decoder Disable
H10F
(8P54)
(068C)
0000
C794
(8PC9)
0863
1U34
Address Controller
State Machine Clock
3A9A
(6682)
(1C91)
4596
(U5C1)
(HF91)
(6608)
(A736)
(CF31)
(1H6F)
State Machine
(00PH)
2946
8834
(4760)
UUUU
(69F0)
(3F47)
(4HPH)
(C592)
(0U9A)
12C7
(6UUF)
(P1A8)
(4347)
