nmikstas/atari_gravitar_black_widow/kicad/atari_gravitar_black_widow/Sheet7A.kicad_sch

## KiCad design kicad/atari_gravitar_black_widow/Sheet7A.kicad_sch (2022-02-08, an earlier design)

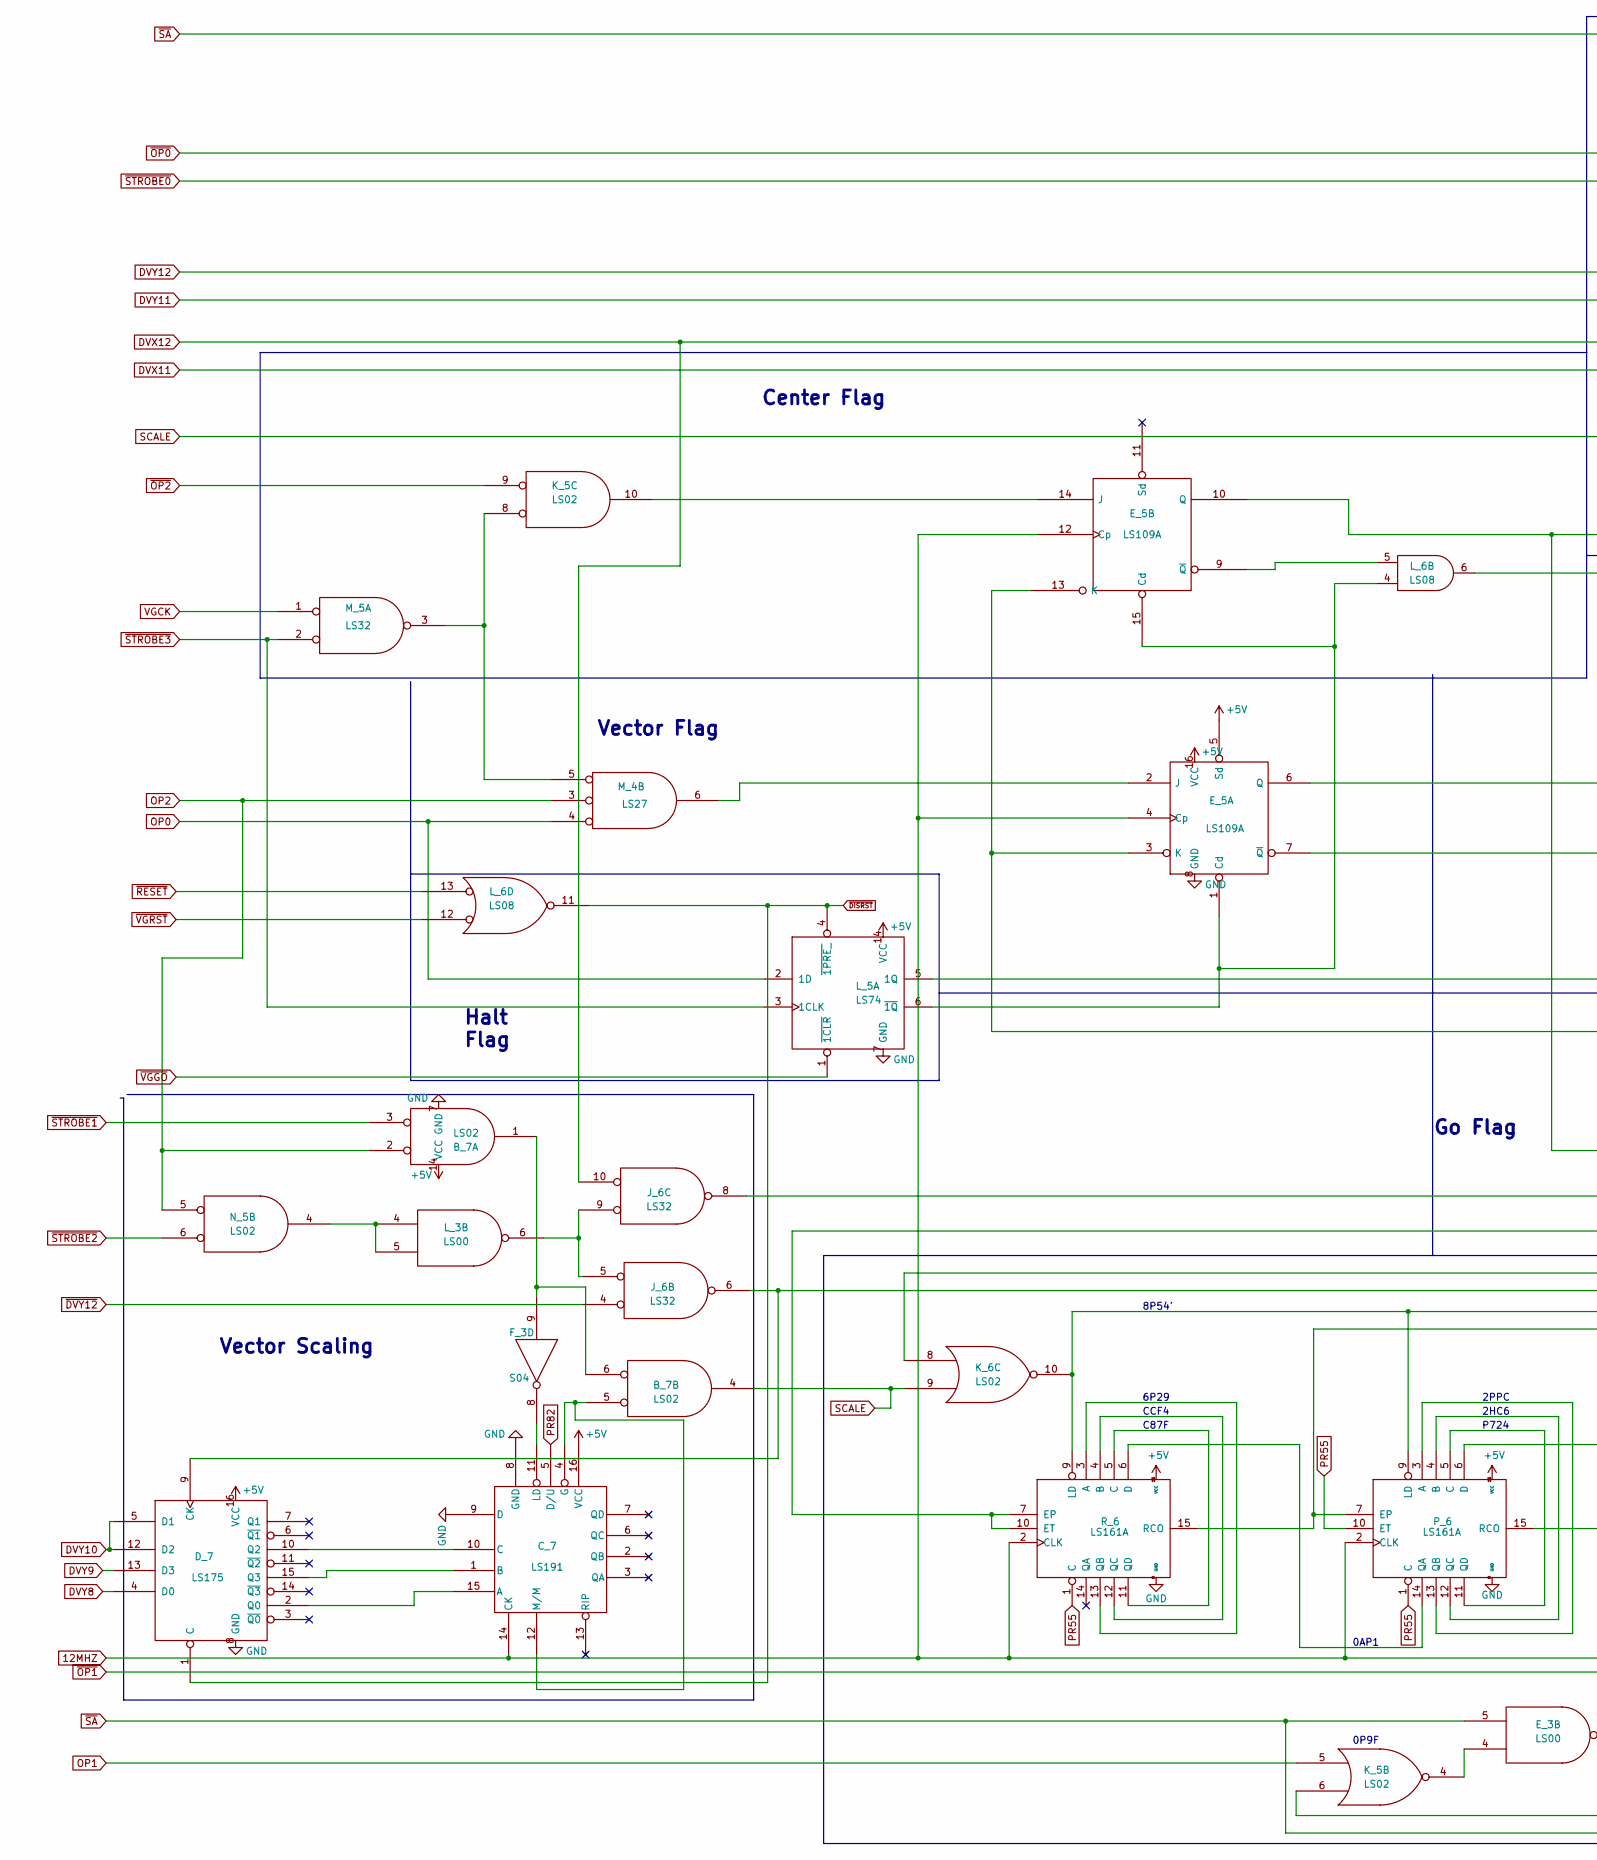
[picture p14: schematic Sheet7A.kicad_sch, part in row 1, column 1]

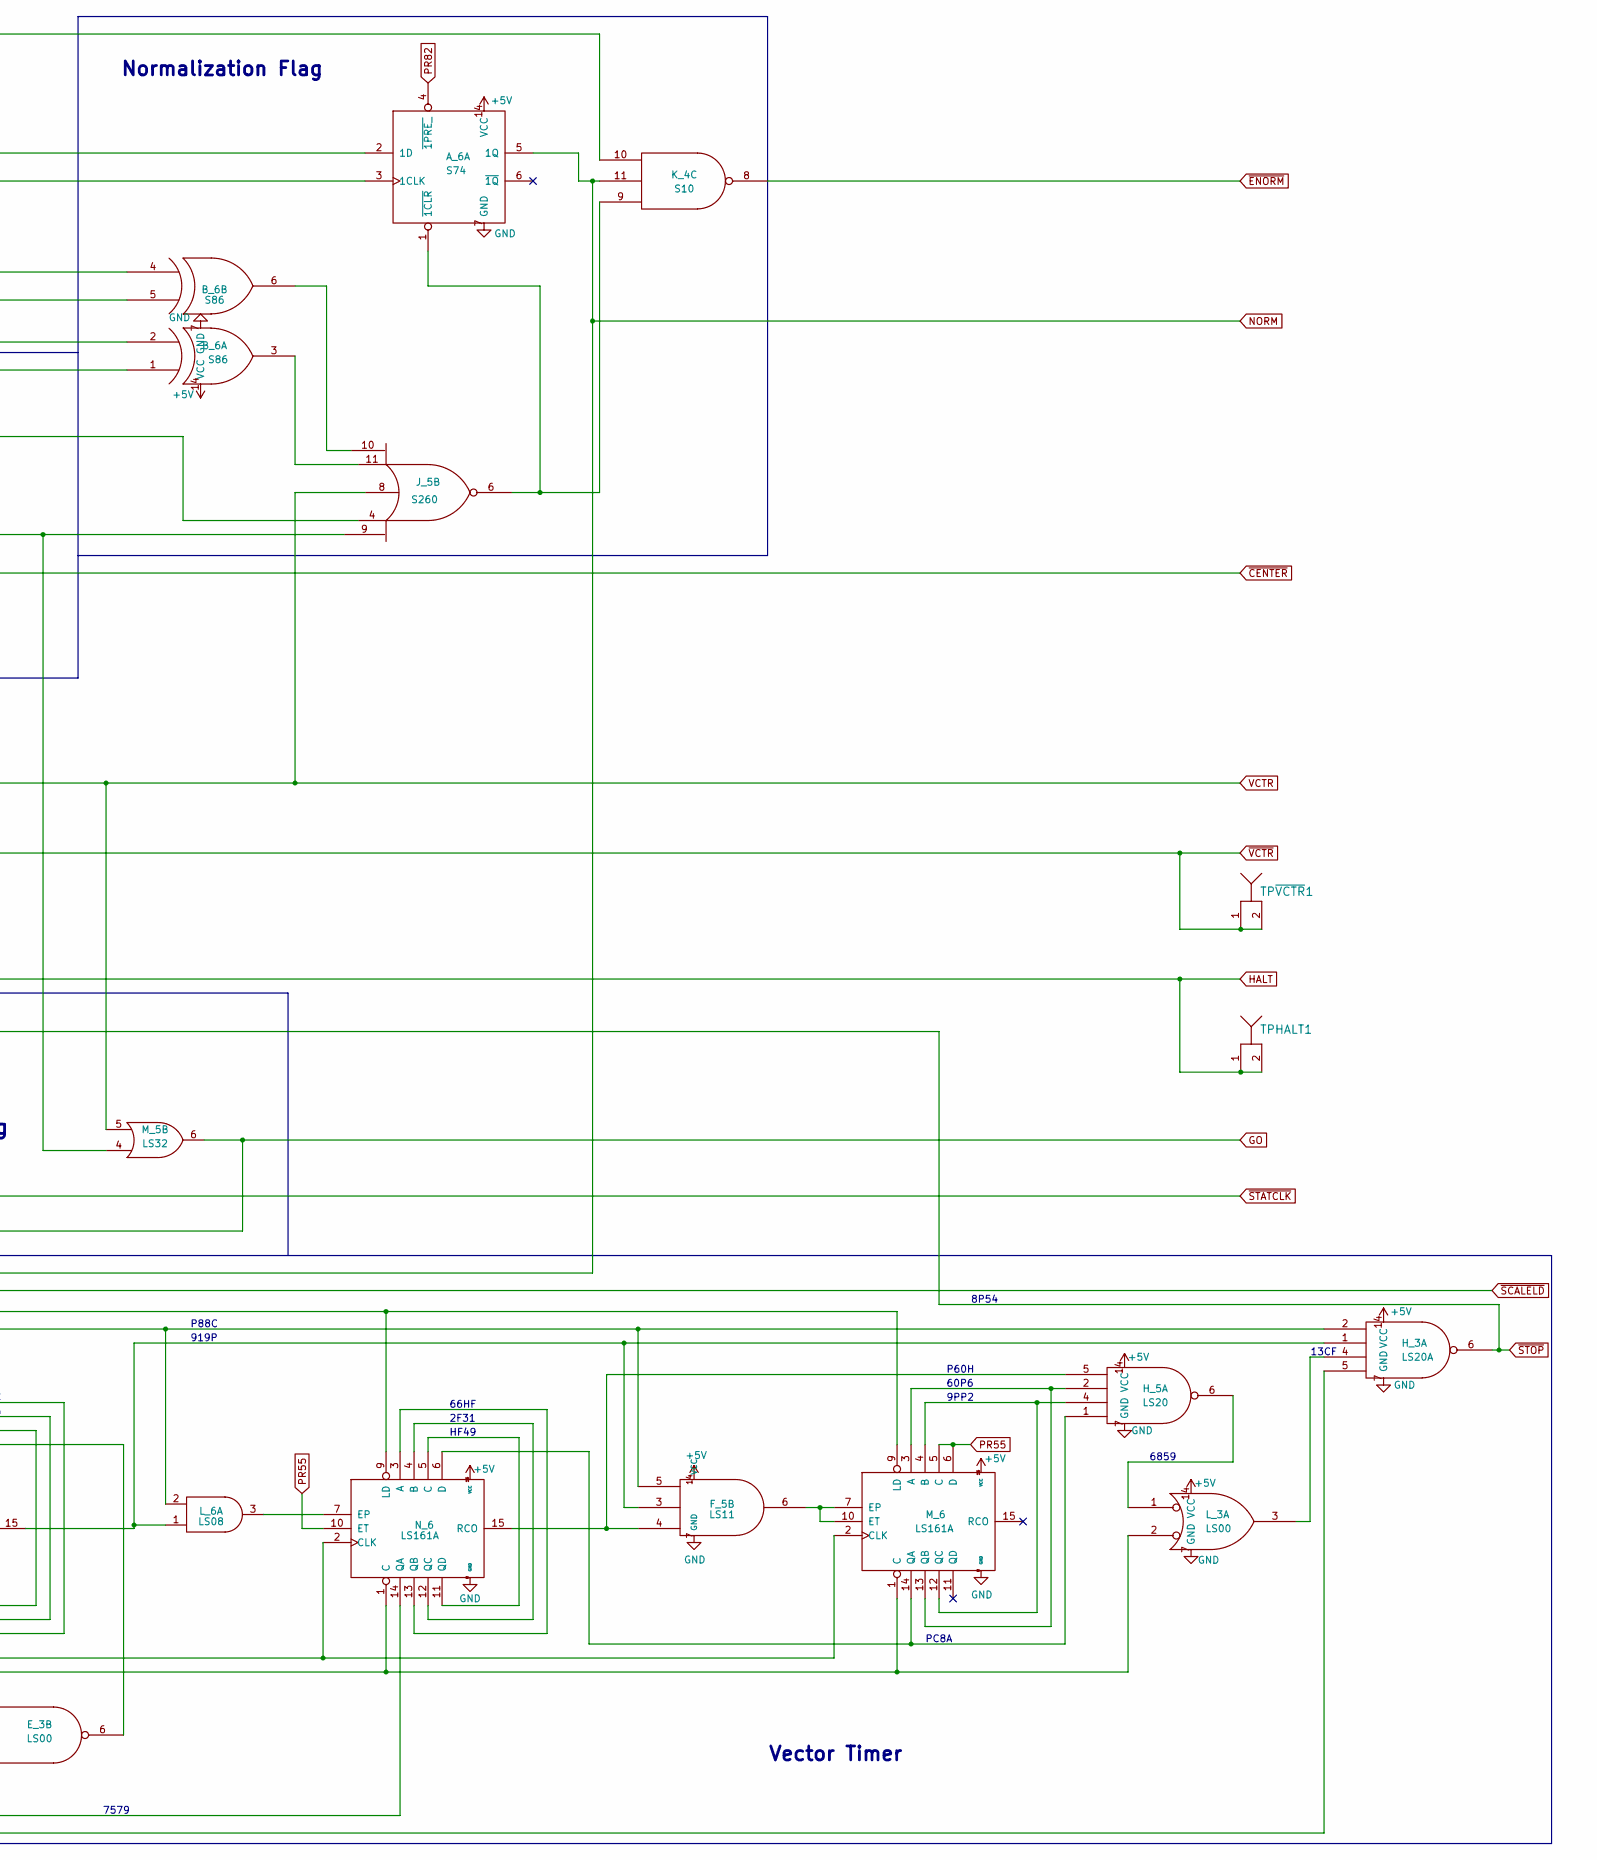
[picture p15: schematic Sheet7A.kicad_sch, part in row 1, column 2]

Parts:
A_6: S74
B_6: S86
B_7: LS02
C_7: LS191
D_7: LS175
E_3: LS00
E_5: LS109A
F_3: S04
F_5: LS11
H_3: LS20A
H_5: LS20
J_5: S260
J_6: LS32
K_4: S10
K_5, K_6: LS02
L_3: LS00
L_5: LS74
L_6: LS08
M_4: LS27
M_5: LS32
M_6: LS161A
N_5: LS02
N_6: LS161A
P_6: LS161A
R_6: LS161A
TPHALT1: TP
TP~{VCTR}1: TP

Connections:
12MHZ: C_7.14 (CK), E_5.4 (Cp), E_5.12 (Cp), M_6.2 (CLK), N_6.2 (CLK), P_6.2 (CLK), R_6.2 (CLK)
+5V: A_6.14 (VCC), B_6.14 (VCC), B_7.14 (VCC), C_7.16 (VCC), D_7.16 (VCC), E_5.5 (Sd), E_5.16 (VCC), F_5.14 (VCC), H_3.14 (VCC), H_5.14 (VCC), L_3.14 (VCC), L_5.14 (VCC), M_6.16 (VCC), N_6.16 (VCC), P_6.16 (VCC), R_6.16 (VCC)
DVX11: B_6.1
DVX12: B_6.2
DVY8: D_7.4 (D0)
DVY9: D_7.13 (D3)
DVY10: D_7.5 (D1), D_7.12 (D2)
DVY11: B_6.5
DVY12: B_6.4
GND: A_6.7 (GND), B_6.7 (GND), B_7.7 (GND), C_7.8 (GND), C_7.9 (D), D_7.8 (GND), E_5.8 (GND), F_5.7 (GND), H_3.7 (GND), H_5.7 (GND), L_3.7 (GND), L_5.7 (GND), M_6.8 (GND), N_6.8 (GND), P_6.8 (GND), R_6.8 (GND)
GO: M_5.6, R_6.7 (EP), R_6.10 (ET)
HALT: L_5.5 (1Q), TPHALT1.1, TPHALT1.2
NORM: A_6.5 (1Q), K_4.11, K_6.8
unnamed: A_6.1 (~1CLR), J_5.6, K_4.9
unnamed: B_6.3, J_5.11
unnamed: B_6.6, J_5.10
unnamed: B_7.1, B_7.6, F_3.9
unnamed: B_7.5, C_7.4 (G), C_7.12 (M/M)
unnamed: C_7.1 (B), D_7.15 (Q3)
unnamed: C_7.10 (C), D_7.10 (Q2)
unnamed: C_7.11 (LD), F_3.8
unnamed: C_7.15 (A), D_7.2 (Q0)
unnamed: E_3.4, K_5.4
unnamed: E_3.6, P_6.6 (D)
unnamed: E_5.1 (Cd), E_5.15 (Cd), L_5.6 (~1Q), L_6.4
unnamed: E_5.2 (J), M_4.6
unnamed: E_5.9 (~Q), L_6.5
unnamed: E_5.10 (Q), J_5.9, M_5.4
unnamed: E_5.14 (J), K_5.10
unnamed: F_5.3, H_3.1, L_6.1, P_6.15 (RCO)
unnamed: F_5.4, H_5.5, N_6.15 (RCO)
unnamed: F_5.5, H_3.2, L_6.2, P_6.7 (EP), R_6.15 (RCO)
unnamed: F_5.6, M_6.7 (EP), M_6.10 (ET)
unnamed: H_3.4, L_3.3
unnamed: H_5.1, M_6.14 (QA), N_6.6 (D)
unnamed: H_5.2, M_6.3 (A), M_6.13 (QB)
unnamed: H_5.4, M_6.4 (B), M_6.12 (QC)
unnamed: H_5.6, L_3.1
unnamed: K_5.6, N_6.14 (QA)
unnamed: K_5.8, M_4.5
unnamed: K_6.10, M_6.9 (LD), N_6.9 (LD), P_6.9 (LD), R_6.9 (LD)
unnamed: L_3.4, L_3.5, N_5.4
unnamed: L_6.3, N_6.7 (EP)
unnamed: N_6.5 (C), N_6.11 (QD)
unnamed: N_6.4 (B), N_6.12 (QC)
unnamed: N_6.3 (A), N_6.13 (QB)
unnamed: P_6.5 (C), P_6.11 (QD)
unnamed: P_6.4 (B), P_6.12 (QC)
unnamed: P_6.3 (A), P_6.13 (QB)
unnamed: P_6.14 (QA), R_6.6 (D)
unnamed: R_6.5 (C), R_6.11 (QD)
unnamed: R_6.4 (B), R_6.12 (QC)
unnamed: R_6.3 (A), R_6.13 (QB)
OP0: L_5.2 (1D)
OP1: K_5.5
OP2: B_7.2, N_5.5
PR55: M_6.5 (C), M_6.6 (D), N_6.10 (ET), P_6.1 (C), P_6.10 (ET), R_6.1 (C)
PR82: A_6.4 (~1PRE_), C_7.5 (D/U)
SCALE: B_7.4, J_5.4, K_6.9
VCTR: E_5.6 (Q), J_5.8, M_5.5
~CENTER: L_6.6
~DISRST: D_7.1 (C), L_5.4 (~1PRE_)
~ENORM: K_4.8
~OP0: A_6.2 (1D)
~OP1: L_3.2, M_6.1 (C), N_6.1 (C)
~OP2: K_5.9
~SA: E_3.5, H_3.5, K_4.10
~SCALELD: D_7.9 (CK)
~STOP: E_5.3 (K), E_5.13 (K), H_3.6
~STROBE0: A_6.3 (1CLK)
~STROBE1: B_7.3
~STROBE2: N_5.6
~STROBE3: L_5.3 (1CLK)
~VCTR: E_5.7 (~Q), TP~{VCTR}1.1, TP~{VCTR}1.2
~VGGO: L_5.1 (~1CLR)

Notes on the sheet:
Go Flag
919P
6859
C87F
9PP2
8P54
66HF
0P9F
Center Flag
CCF4
Vector Timer
8P54'
60P6
2HC6
2F31
P88C
HF49
0AP1
Vector Flag
PC8A
Vector Scaling
6P29
P60H
Normalization Flag
P724
13CF
Halt Flag
7579
2PPC
