nmikstas/atari_gravitar_black_widow/kicad/atari_gravitar_black_widow/Sheet7B.kicad_sch

## KiCad design kicad/atari_gravitar_black_widow/Sheet7B.kicad_sch (2022-02-06, an earlier design)

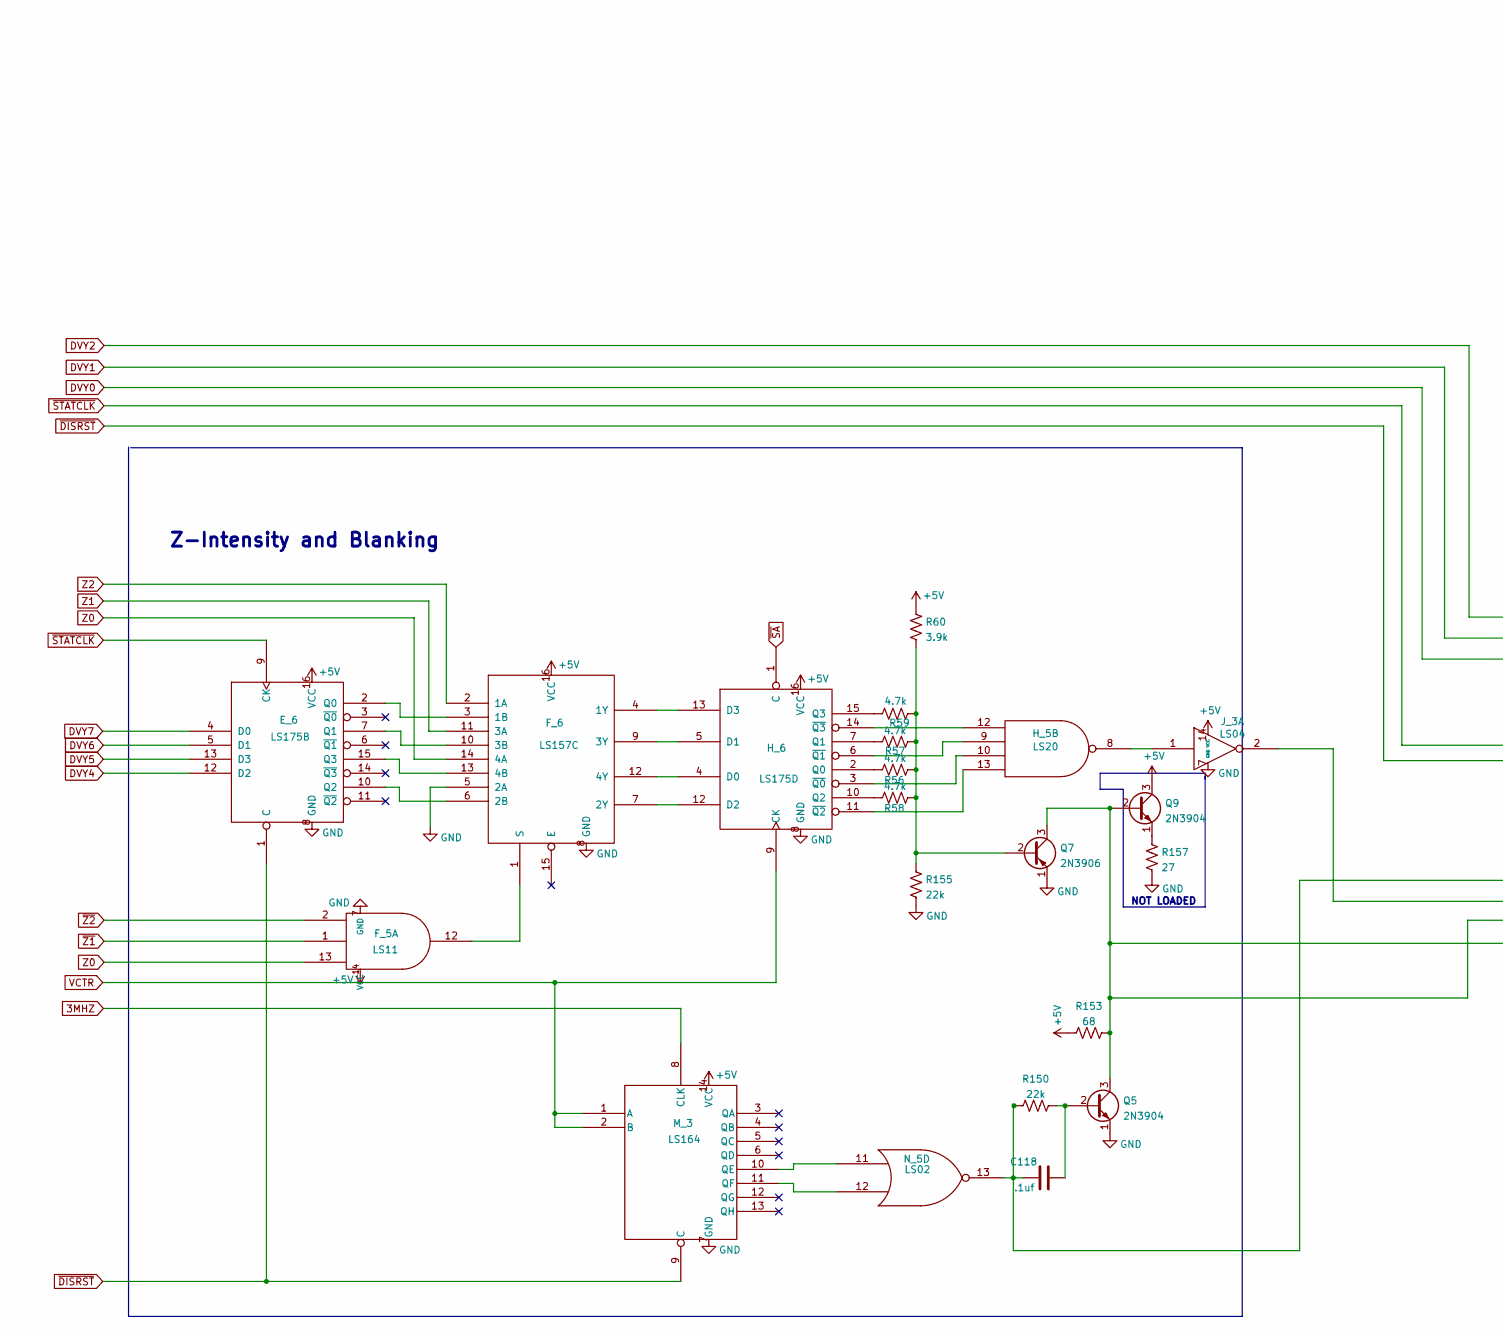
[picture p16: schematic Sheet7B.kicad_sch, part in row 1, column 1]

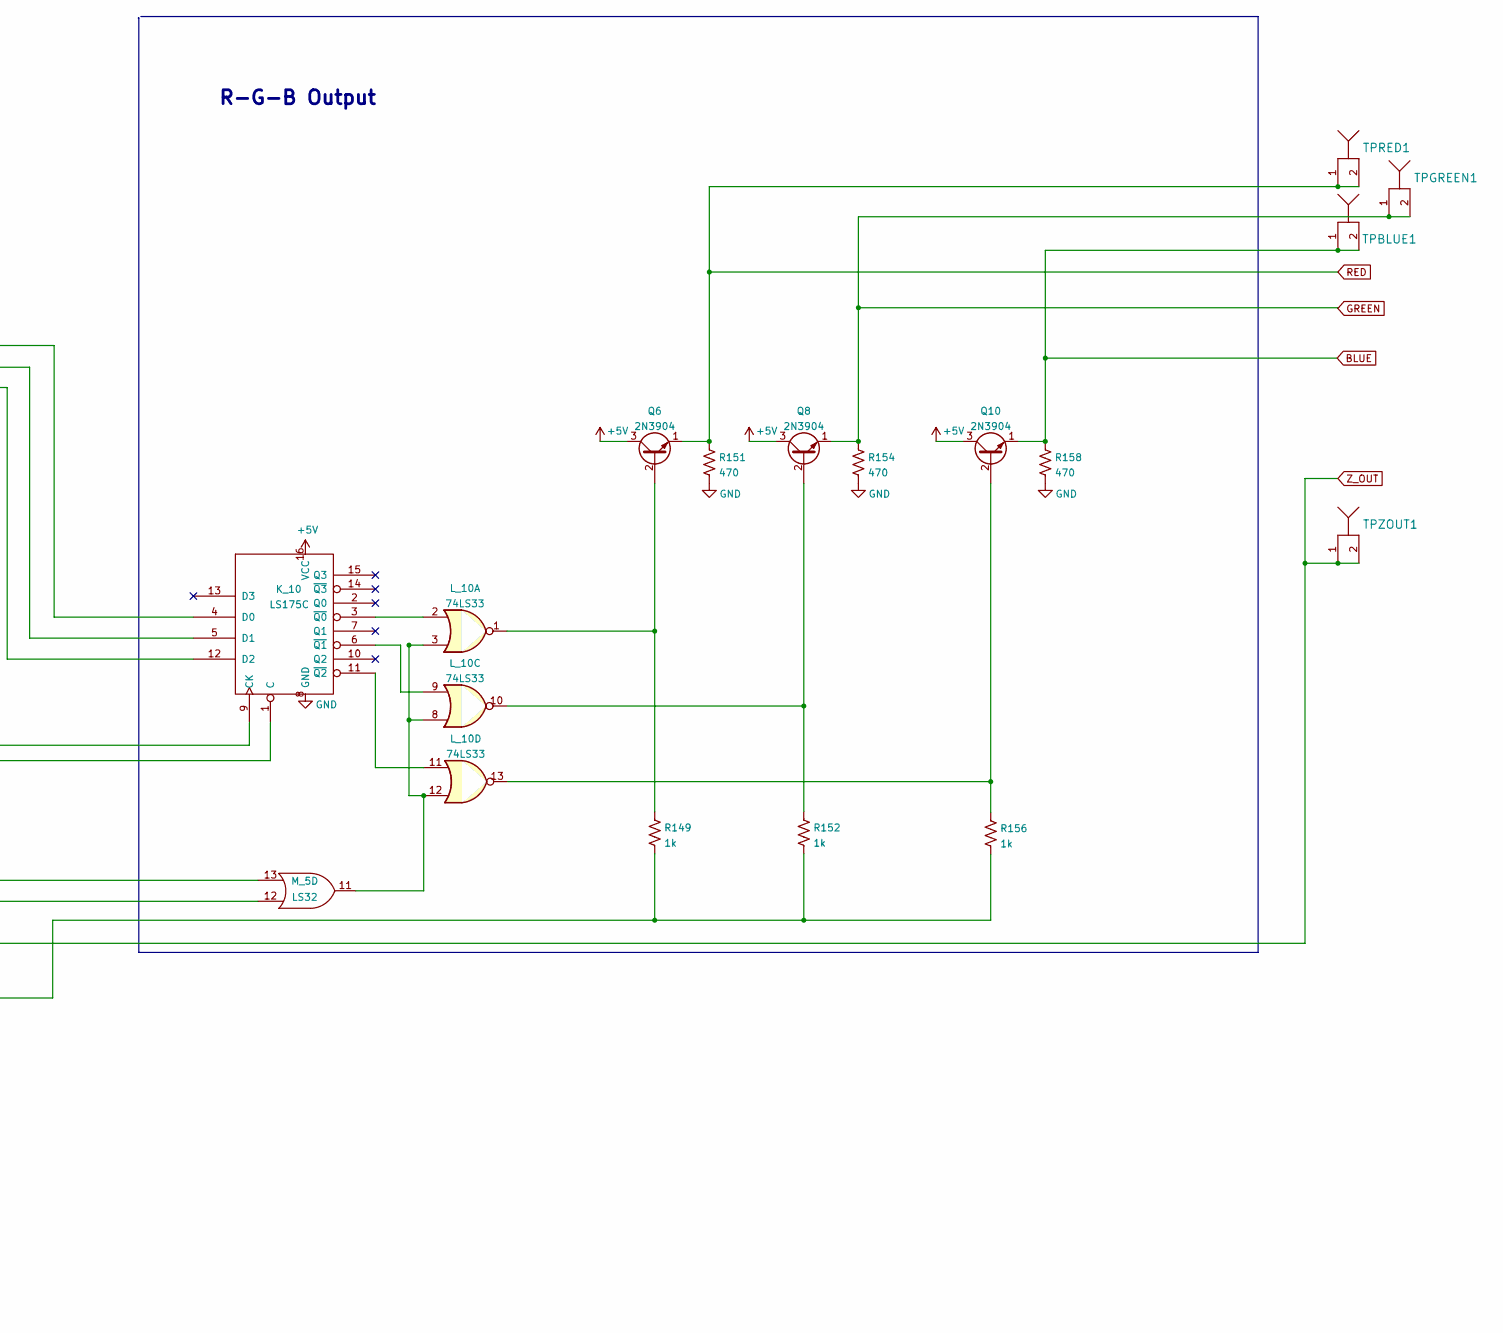
[picture p17: schematic Sheet7B.kicad_sch, part in row 1, column 2]

Parts:
C118: .1uf
E_6: LS175B
F_5: LS11
F_6: LS157C
H_5: LS20
H_6: LS175D
J_3: LS04
K_10: LS175C
L_10: 74LS33
M_3: LS164
M_5: LS32
N_5: LS02
Q5, Q6, Q8, Q9, Q10: 2N3904
Q7: 2N3906
R56, R57, R58, R59: 4.7k
R60: 3.9k
R149, R152, R156: 1k
R150, R155: 22k
R151, R154, R158: 470
R153: 68
R157: 27
TPBLUE1: TP
TPGREEN1: TP
TPRED1: TP
TPZOUT1: TP

Connections:
3MHZ: M_3.8 (CLK)
+5V: E_6.16 (VCC), F_5.14 (VCC), F_6.16 (VCC), H_6.16 (VCC), J_3.14 (VCC), K_10.16 (VCC), M_3.14 (VCC), Q6.3 (C), Q8.3 (C), Q9.3 (C), Q10.3 (C), R60.1, R153.1
BLUE: Q10.1 (E), R158.2, TPBLUE1.1, TPBLUE1.2
DVY0: K_10.12 (D2)
DVY1: K_10.5 (D1)
DVY2: K_10.4 (D0)
DVY4: E_6.12 (D2)
DVY5: E_6.13 (D3)
DVY6: E_6.5 (D1)
DVY7: E_6.4 (D0)
GND: E_6.8 (GND), F_5.7 (GND), F_6.5 (2A), F_6.8 (GND), H_6.8 (GND), J_3.7 (GND), K_10.8 (GND), M_3.7 (GND), Q5.1 (E), Q7.1 (E), R151.1, R154.1, R155.1, R157.1, R158.1
GREEN: Q8.1 (E), R154.2, TPGREEN1.1, TPGREEN1.2
unnamed: C118.1, M_5.13, N_5.13, R150.2
unnamed: C118.2, Q5.2 (B), R150.1
unnamed: E_6.2 (Q0), F_6.3 (1B)
unnamed: E_6.7 (Q1), F_6.10 (3B)
unnamed: E_6.10 (Q2), F_6.6 (2B)
unnamed: E_6.15 (Q3), F_6.13 (4B)
unnamed: F_5.12, F_6.1 (S)
unnamed: F_6.4 (1Y), H_6.13 (D3)
unnamed: F_6.7 (2Y), H_6.12 (D2)
unnamed: F_6.9 (3Y), H_6.5 (D1)
unnamed: F_6.12 (4Y), H_6.4 (D0)
unnamed: H_5.8, J_3.1
unnamed: H_5.9, H_6.6 (~Q1)
unnamed: H_5.10, H_6.3 (~Q0)
unnamed: H_5.12, H_6.14 (~Q3)
unnamed: H_5.13, H_6.11 (~Q2)
unnamed: H_6.2 (Q0), R56.2
unnamed: H_6.7 (Q1), R57.2
unnamed: H_6.10 (Q2), R58.2
unnamed: H_6.15 (Q3), R59.2
unnamed: J_3.2, M_5.12
unnamed: K_10.3 (~Q0), L_10.2
unnamed: K_10.6 (~Q1), L_10.9
unnamed: K_10.11 (~Q2), L_10.11
unnamed: L_10.1, Q6.2 (B), R149.2
unnamed: L_10.10, Q8.2 (B), R152.2
unnamed: L_10.3, L_10.8, L_10.12, M_5.11
unnamed: L_10.13, Q10.2 (B), R156.2
unnamed: M_3.10 (QE), N_5.11
unnamed: M_3.11 (QF), N_5.12
unnamed: Q7.2 (B), R56.1, R57.1, R58.1, R59.1, R60.2, R155.2
unnamed: Q9.1 (E), R157.2
RED: Q6.1 (E), R151.2, TPRED1.1, TPRED1.2
VCTR: H_6.9 (CK), M_3.1 (A), M_3.2 (B)
Z0: F_5.13, F_6.14 (4A)
Z1: F_6.11 (3A)
Z2: F_6.2 (1A)
Z_OUT: Q5.3 (C), Q7.3 (C), Q9.2 (B), R149.1, R152.1, R153.2, R156.1, TPZOUT1.1, TPZOUT1.2
~DISRST: E_6.1 (C), K_10.1 (C), M_3.9 (C)
~SA: H_6.1 (C)
~STATCLK: E_6.9 (CK), K_10.9 (CK)
~Z1: F_5.1
~Z2: F_5.2

Notes on the sheet:
R-G-B Output
Z-Intensity and Blanking
NOT LOADED
