nmikstas/atari_gravitar_black_widow/kicad/atari_gravitar_black_widow/Sheet8A.kicad_sch

## KiCad design kicad/atari_gravitar_black_widow/Sheet8A.kicad_sch (2022-02-09, an earlier design)

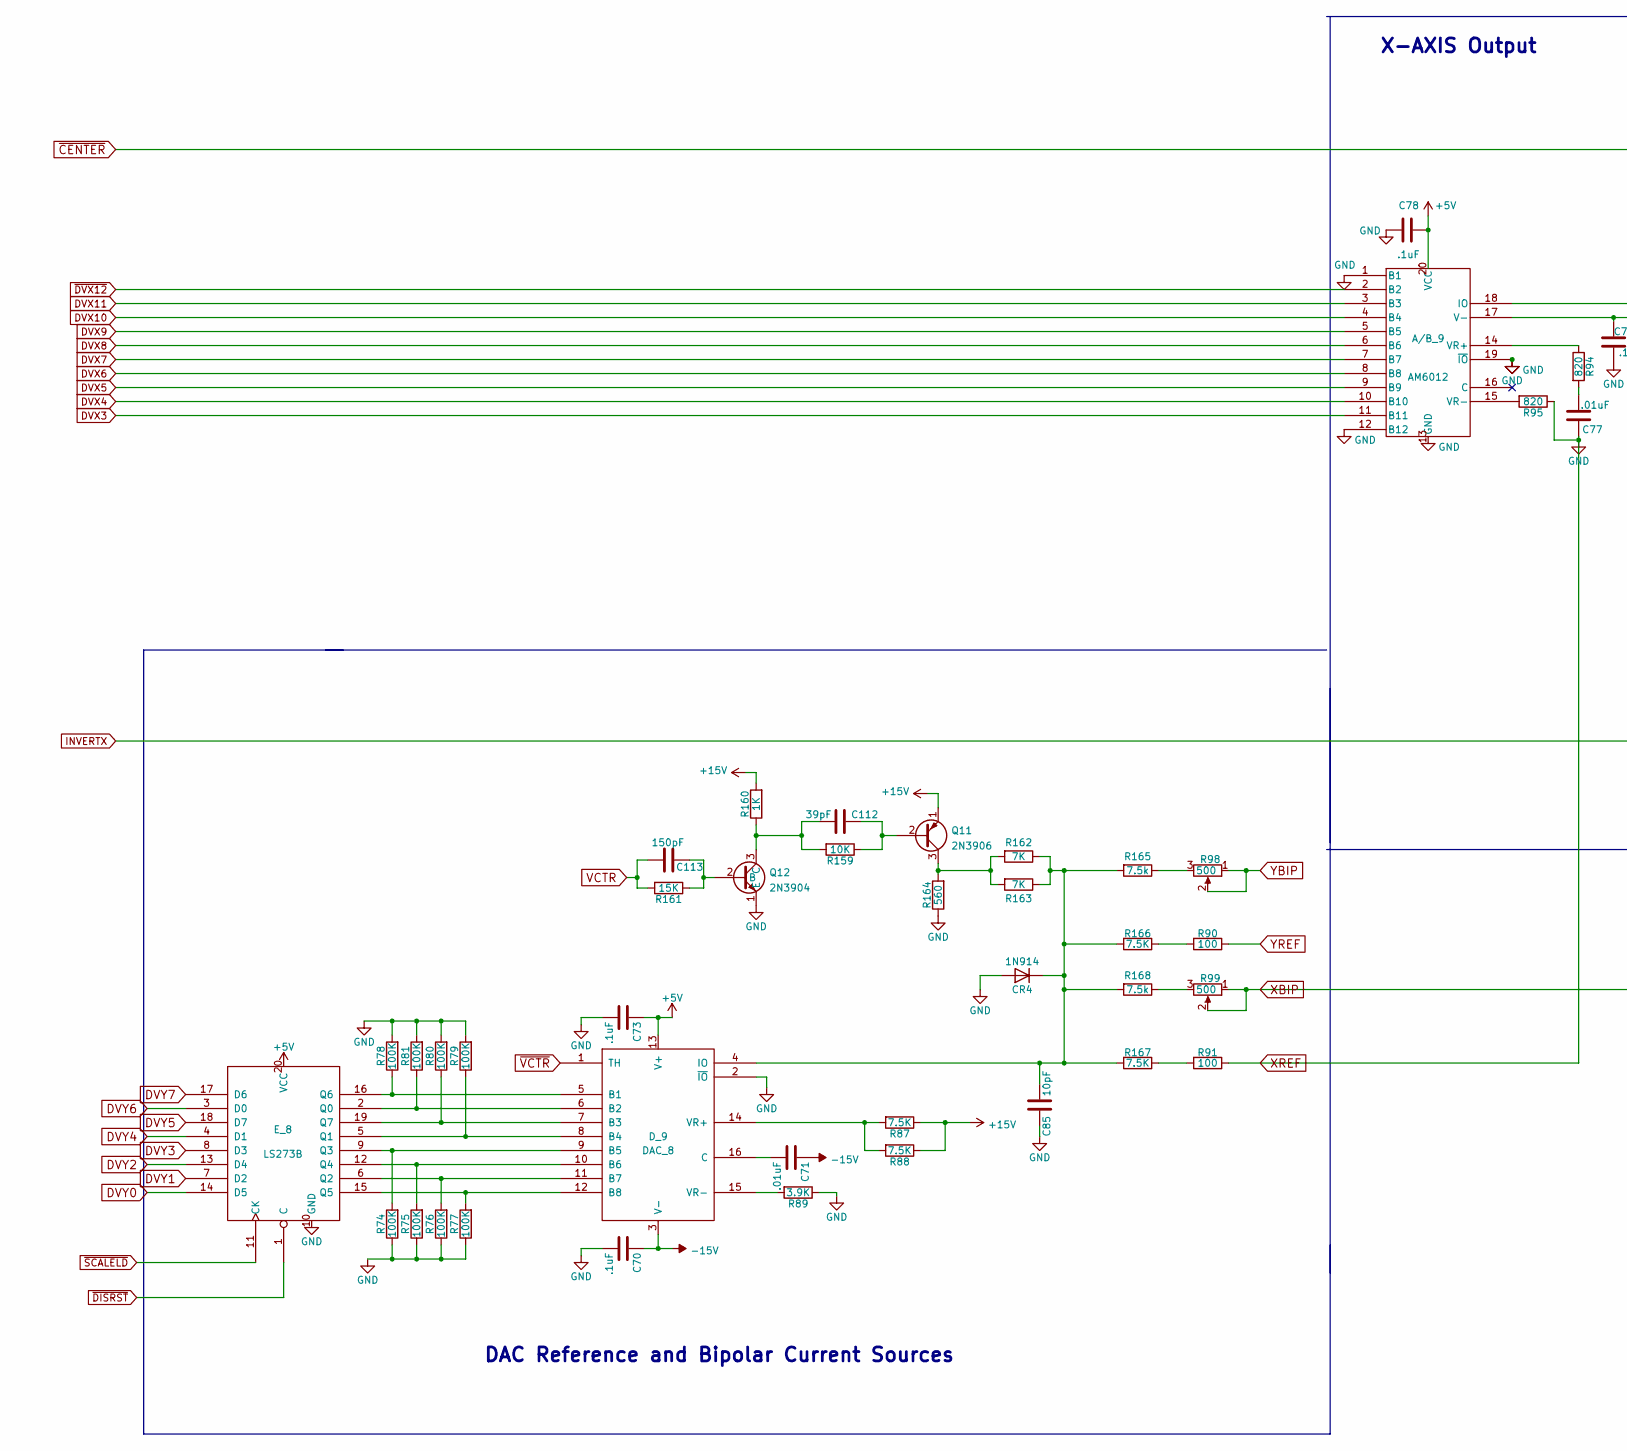
[picture p18: schematic Sheet8A.kicad_sch, part in row 1, column 1]

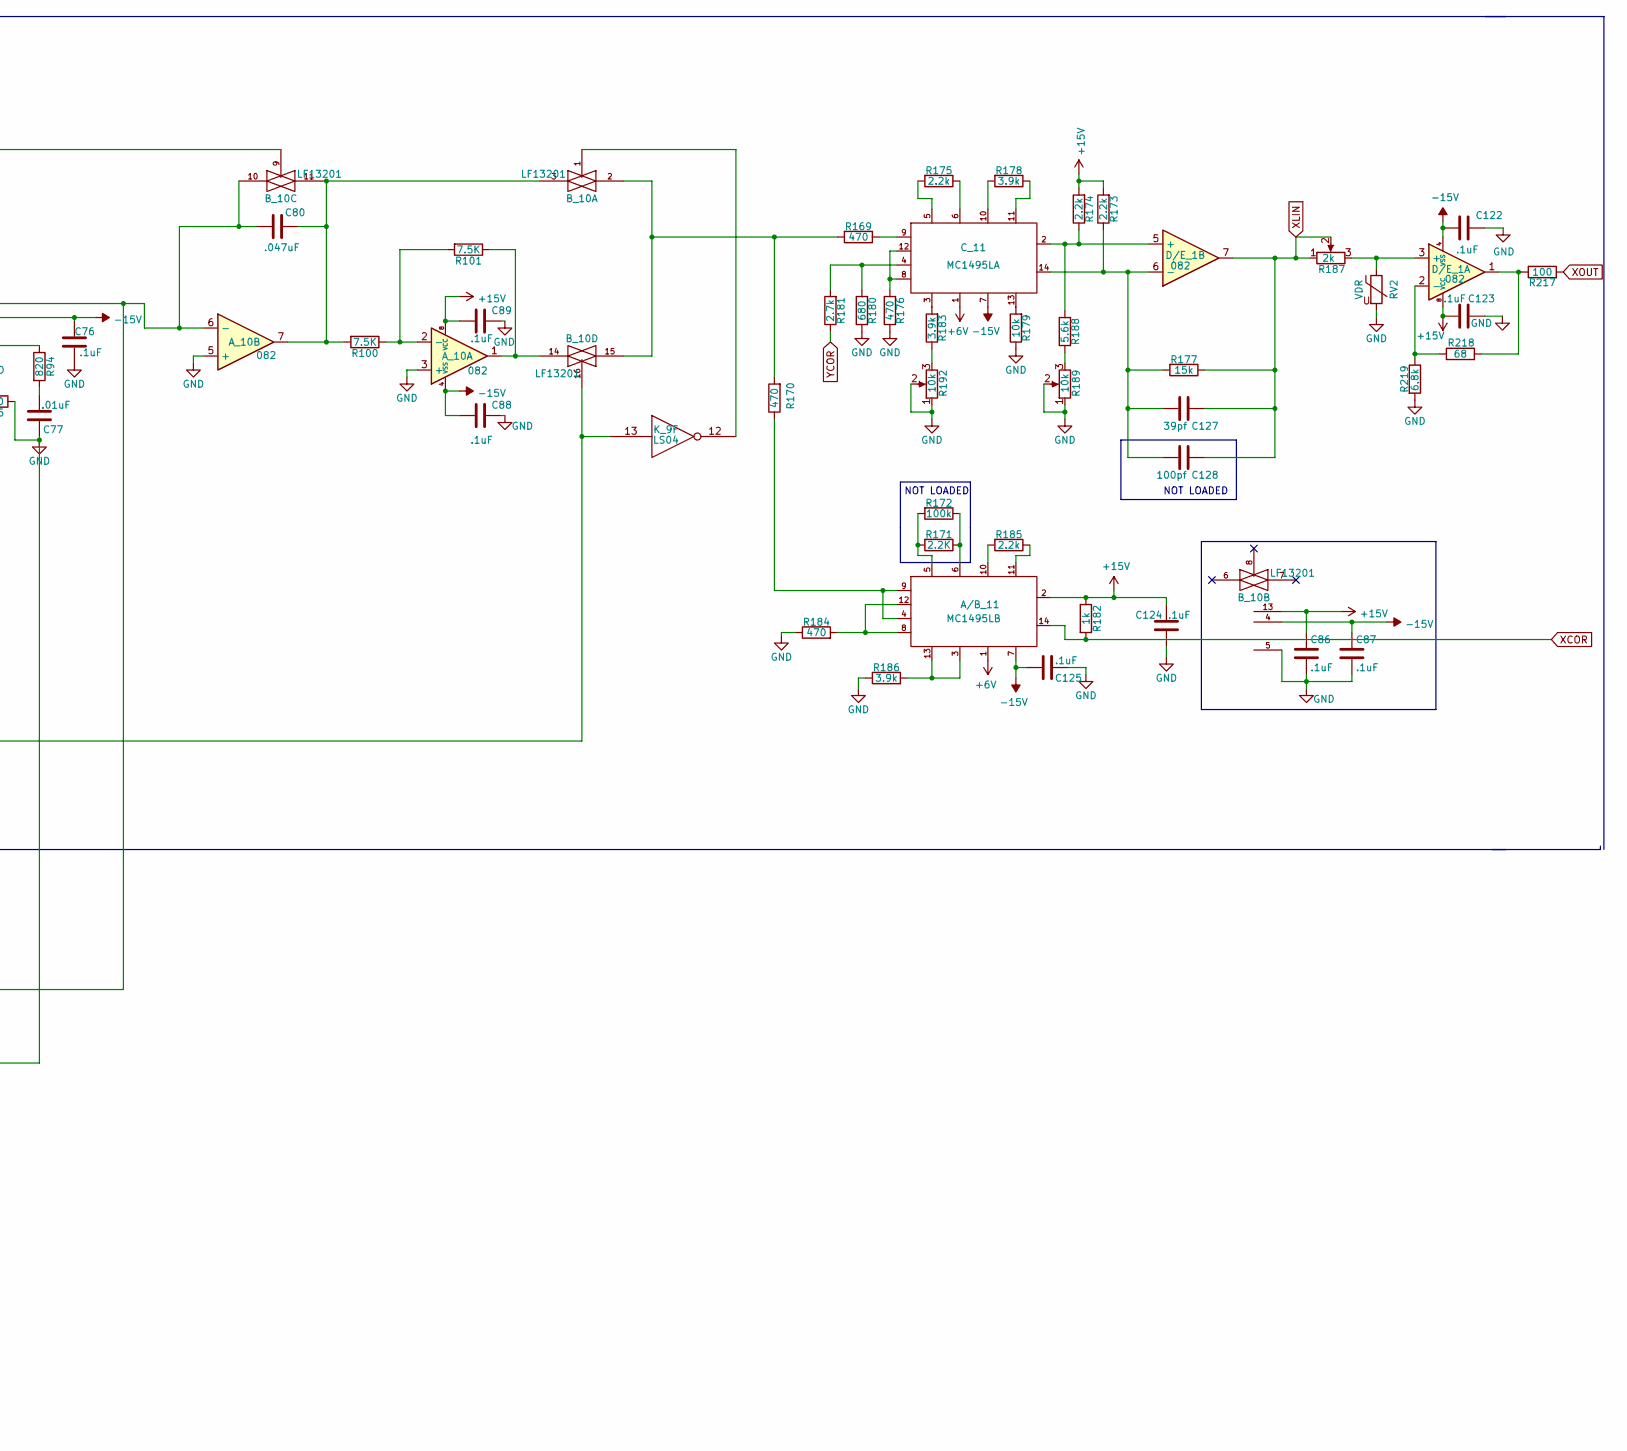
[picture p19: schematic Sheet8A.kicad_sch, part in row 1, column 2]

Parts:
A/B_9: AM6012
A/B_11: MC1495LB
A_10: 082
B_10: LF13201
C70, C73, C76, C78, C86, C87, C88, C89, C122, C123, C124, C125: .1uF
C71, C77: .01uF
C80: .047uF
C85: 10pF
C112: 39pF
C113: 150pF
C127: 39pf
C128: 100pf
CR4: 1N914
C_11: MC1495LA
D/E_1: 082
D_9: DAC_8
E_8: LS273B
K_9: LS04
Q11: 2N3906; TO-92_Inline
Q12: 2N3904
R74, R75, R76, R77, R78, R79, R80, R81: 100K
R87, R88, R100, R101, R166, R167: 7.5K
R89: 3.9K
R90, R91, R217: 100
R94, R95: 820
R98, R99: 500
R159: 10K
R160: 1K
R161: 15K
R162, R163: 7K
R164: 560
R165, R168: 7.5k
R169, R170, R176, R184: 470
R171: 2.2K
R172: 100k
R173, R174, R175, R185: 2.2k
R177: 15k
R178, R183, R186: 3.9k
R179, R189, R192: 10k
R180: 680
R181: 2.7k
R182: 1k
R187: 2k
R188: 5.6k
R218: 68
R219: 6.8k
RV2: VDR

Connections:
+5V: A/B_9.20 (VCC), C73.1, C78.1, D_9.13 (V+), E_8.20 (VCC)
+6V: A/B_11.1, C_11.1
+15V: A/B_11.2, A_10.8 (VCC), B_10.13, C86.1, C89.2, C123.2, C124.2, D/E_1.8 (VCC), Q11.1 (E), R87.1, R88.1, R160.2, R173.2, R174.2, R182.1
-15V: A/B_9.17 (V-), A/B_11.7, A_10.4 (VSS), B_10.4, C70.1, C71.1, C76.2, C87.1, C88.2, C122.2, C125.2, C_11.7, D/E_1.4 (VSS), D_9.3 (V-)
DVX3: A/B_9.11 (B11)
DVX4: A/B_9.10 (B10)
DVX5: A/B_9.9 (B9)
DVX6: A/B_9.8 (B8)
DVX7: A/B_9.7 (B7)
DVX8: A/B_9.6 (B6)
DVX9: A/B_9.5 (B5)
DVX10: A/B_9.4 (B4)
DVX11: A/B_9.3 (B3)
DVY0: E_8.14 (D5)
DVY1: E_8.7 (D2)
DVY2: E_8.13 (D4)
DVY3: E_8.8 (D3)
DVY4: E_8.4 (D1)
DVY5: E_8.18 (D7)
DVY6: E_8.3 (D0)
DVY7: E_8.17 (D6)
GND: A/B_9.1 (B1), A/B_9.12 (B12), A/B_9.13 (GND), A/B_9.19 (~IO), A_10.3 (+), A_10.5 (+), B_10.5, C70.2, C73.2, C76.1, C77.1, C78.2, C85.1, C86.2, C87.2, C88.1, C89.1, C122.1, C123.1, C124.1, C125.1, CR4.2 (A), D_9.2 (~IO), E_8.10 (GND), Q12.1 (E), R74.1, R75.1, R76.1, R77.1, R78.2, R79.2, R80.2, R81.2, R89.1, R91.1, R95.1, R164.1, R176.1, R179.1, R180.1, R184.1, R186.1, R189.1, R189.2, R192.1, R192.2, R219.2, RV2.2
INVERTX: B_10.16, K_9.13
unnamed: A/B_9.14 (VR+), R94.1
unnamed: A/B_9.15 (VR-), R95.2
unnamed: A/B_11.4, A/B_11.9, R170.1
unnamed: A/B_11.5, R171.2, R172.2
unnamed: A/B_11.6, R171.1, R172.1
unnamed: A/B_11.10, R185.2
unnamed: A/B_11.11, R185.1
unnamed: A/B_11.8, A/B_11.12, R184.2
unnamed: A/B_11.3, A/B_11.13, R186.2
unnamed: A_10.1, B_10.14, R101.1
unnamed: A_10.2 (-), R100.1, R101.2
unnamed: A_10.7, B_10.3, B_10.11, C80.1, R100.2
unnamed: B_10.1, K_9.12
unnamed: B_10.2, B_10.15, R169.2, R170.2
unnamed: C71.2, D_9.16 (C)
unnamed: C77.2, R94.2
unnamed: C85.2, CR4.1 (K), D_9.4 (IO), R162.1, R163.1, R165.2, R166.2, R167.2, R168.2
unnamed: C112.1, Q11.2 (B), R159.1
unnamed: C112.2, Q12.3 (C), R159.2, R160.1
unnamed: C113.1, Q12.2 (B), R161.1
unnamed: C127.2, C128.2, C_11.14, D/E_1.6 (-), R173.1, R177.2
unnamed: C_11.2, D/E_1.5 (+), R174.1, R188.2
unnamed: C_11.3, R183.2
unnamed: C_11.4, R180.2, R181.2
unnamed: C_11.5, R175.2
unnamed: C_11.6, R175.1
unnamed: C_11.9, R169.1
unnamed: C_11.10, R178.2
unnamed: C_11.11, R178.1
unnamed: C_11.8, C_11.12, R176.2
unnamed: C_11.13, R179.2
unnamed: D/E_1.1, R217.1, R218.2
unnamed: D/E_1.2 (-), R218.1, R219.1
unnamed: D/E_1.3 (+), R187.3, RV2.1
unnamed: D_9.5 (B1), E_8.16 (Q6), R78.1
unnamed: D_9.6 (B2), E_8.2 (Q0), R81.1
unnamed: D_9.7 (B3), E_8.19 (Q7), R80.1
unnamed: D_9.8 (B4), E_8.5 (Q1), R79.1
unnamed: D_9.9 (B5), E_8.9 (Q3), R74.2
unnamed: D_9.10 (B6), E_8.12 (Q4), R75.2
unnamed: D_9.11 (B7), E_8.6 (Q2), R76.2
unnamed: D_9.12 (B8), E_8.15 (Q5), R77.2
unnamed: D_9.14 (VR+), R87.2, R88.2
unnamed: D_9.15 (VR-), R89.2
unnamed: Q11.3 (C), R162.2, R163.2, R164.2
unnamed: R98.3, R165.1
unnamed: R90.2, R166.1
unnamed: R91.2, R167.1
unnamed: R99.3, R168.1
unnamed: R183.1, R192.3
unnamed: R188.1, R189.3
VCTR: C113.2, R161.2
XBIP: A/B_9.18 (IO), A_10.6 (-), B_10.10, C80.2, R99.1, R99.2
XCOR: A/B_11.14, R182.2
XLIN: C127.1, C128.1, D/E_1.7, R177.1, R187.1, R187.2
XOUT: R217.2
YBIP: R98.1, R98.2
YCOR: R181.1
YREF: R90.1
~CENTER: B_10.9
~DISRST: E_8.1 (C)
~DVX12: A/B_9.2 (B2)
~SCALELD: E_8.11 (CK)
~VCTR: D_9.1 (TH)

Notes on the sheet:
NOT LOADED
X-AXIS Output
DAC Reference and Bipolar Current Sources
