nmikstas/atari_gravitar_black_widow/kicad/atari_gravitar_black_widow/SheetMisc.kicad_sch

## KiCad design kicad/atari_gravitar_black_widow/SheetMisc.kicad_sch (2022-02-09, an earlier design)

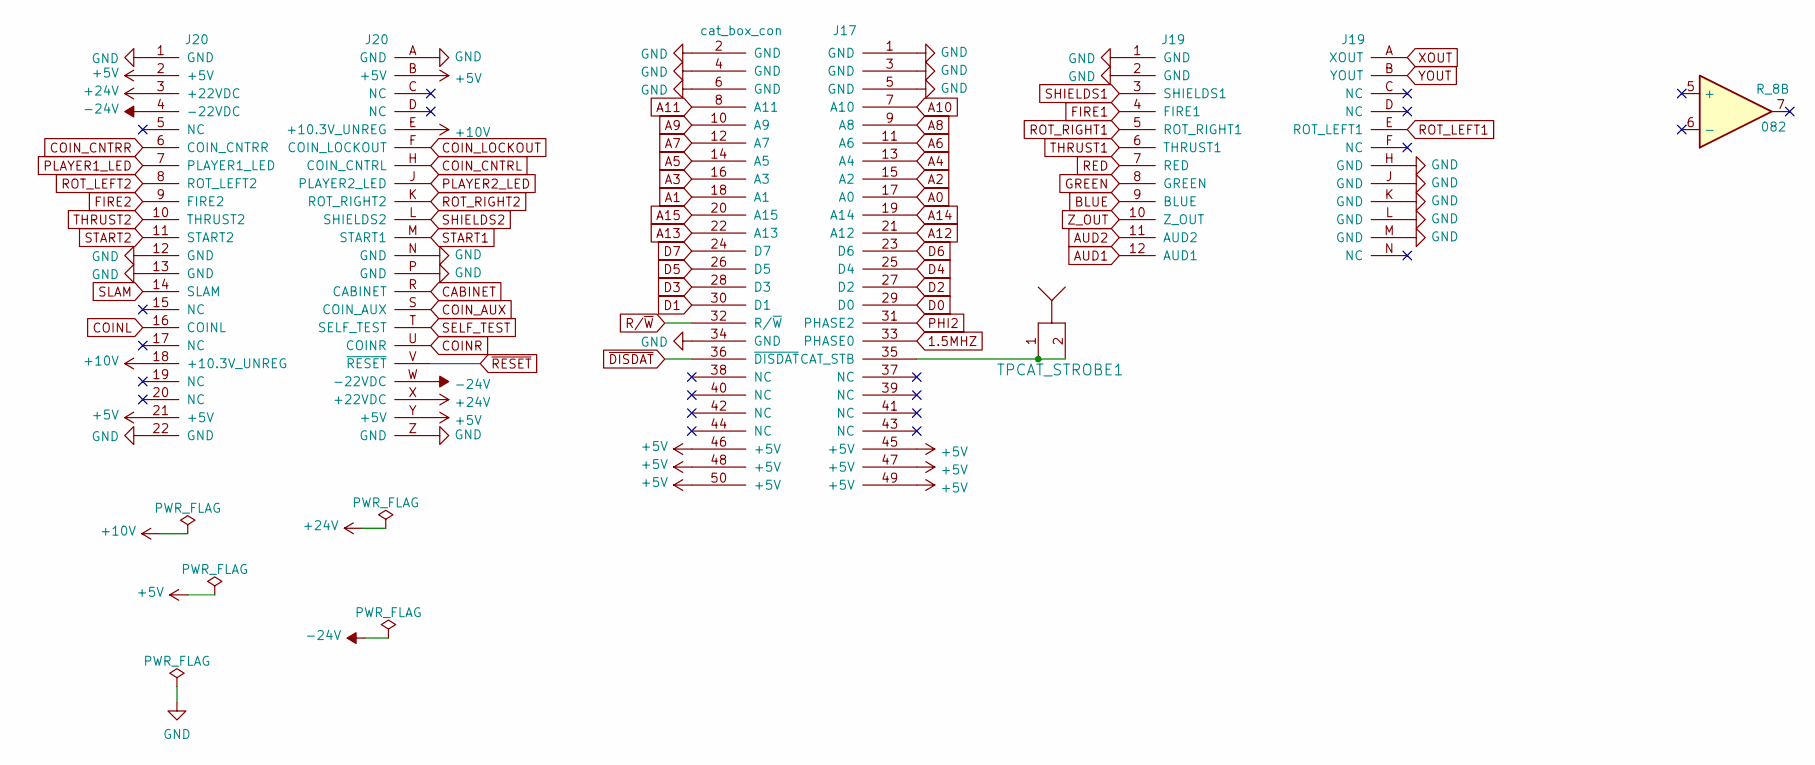
[picture p20: schematic SheetMisc.kicad_sch]

Parts:
J17: cat_box_con
J19: J19
J20: J20
R_8: 082
TPCAT_STROBE1: TP

Connections:
1.5MHZ: J17.33 (PHASE0)
+5V: J17.45 (+5V), J17.46 (+5V), J17.47 (+5V), J17.48 (+5V), J17.49 (+5V), J17.50 (+5V), J20.2 (+5V), J20.21 (+5V), J20.B (+5V), J20.Y (+5V)
+10V: J20.18 (+10.3V_UNREG), J20.E (+10.3V_UNREG)
+24V: J20.3 (+22VDC), J20.X (+22VDC)
-24V: J20.4 (-22VDC), J20.W (-22VDC)
A0: J17.17 (A0)
A1: J17.18 (A1)
A2: J17.15 (A2)
A3: J17.16 (A3)
A4: J17.13 (A4)
A5: J17.14 (A5)
A6: J17.11 (A6)
A7: J17.12 (A7)
A8: J17.9 (A8)
A9: J17.10 (A9)
A10: J17.7 (A10)
A11: J17.8 (A11)
A12: J17.21 (A12)
A13: J17.22 (A13)
A14: J17.19 (A14)
A15: J17.20 (A15)
AUD1: J19.12 (AUD1)
AUD2: J19.11 (AUD2)
BLUE: J19.9 (BLUE)
CABINET: J20.R (CABINET)
COINL: J20.16 (COINL)
COINR: J20.U (COINR)
COIN_AUX: J20.S (COIN_AUX)
COIN_CNTRL: J20.H (COIN_CNTRL)
COIN_CNTRR: J20.6 (COIN_CNTRR)
COIN_LOCKOUT: J20.F (COIN_LOCKOUT)
D0: J17.29 (D0)
D1: J17.30 (D1)
D2: J17.27 (D2)
D3: J17.28 (D3)
D4: J17.25 (D4)
D5: J17.26 (D5)
D6: J17.23 (D6)
D7: J17.24 (D7)
FIRE1: J19.4 (FIRE1)
FIRE2: J20.9 (FIRE2)
GND: J17.1 (GND), J17.2 (GND), J17.3 (GND), J17.4 (GND), J17.5 (GND), J17.6 (GND), J17.34 (GND), J19.1 (GND), J19.2 (GND), J19.H (GND), J19.J (GND), J19.K (GND), J19.L (GND), J19.M (GND), J20.1 (GND), J20.12 (GND), J20.13 (GND), J20.22 (GND), J20.A (GND), J20.N (GND), J20.P (GND), J20.Z (GND)
GREEN: J19.8 (GREEN)
unnamed: J17.35 (CAT_STB), TPCAT_STROBE1.1, TPCAT_STROBE1.2
PHI2: J17.31 (PHASE2)
PLAYER1_LED: J20.7 (PLAYER1_LED)
PLAYER2_LED: J20.J (PLAYER2_LED)
RED: J19.7 (RED)
ROT_LEFT1: J19.E (ROT_LEFT1)
ROT_LEFT2: J20.8 (ROT_LEFT2)
ROT_RIGHT1: J19.5 (ROT_RIGHT1)
ROT_RIGHT2: J20.K (ROT_RIGHT2)
R/~W: J17.32 (R/~W)
SELF_TEST: J20.T (SELF_TEST)
SHIELDS1: J19.3 (SHIELDS1)
SHIELDS2: J20.L (SHIELDS2)
SLAM: J20.14 (SLAM)
START1: J20.M (START1)
START2: J20.11 (START2)
THRUST1: J19.6 (THRUST1)
THRUST2: J20.10 (THRUST2)
XOUT: J19.A (XOUT)
YOUT: J19.B (YOUT)
Z_OUT: J19.10 (Z_OUT)
~DISDAT: J17.36 (~DISDAT)
~RESET: J20.V (~RESET)
