nmikstas/atari_gravitar_black_widow/kicad/atari_gravitar_black_widow/untitled.kicad_sch

## KiCad design kicad/atari_gravitar_black_widow/untitled.kicad_sch (2022-02-09, an earlier design)

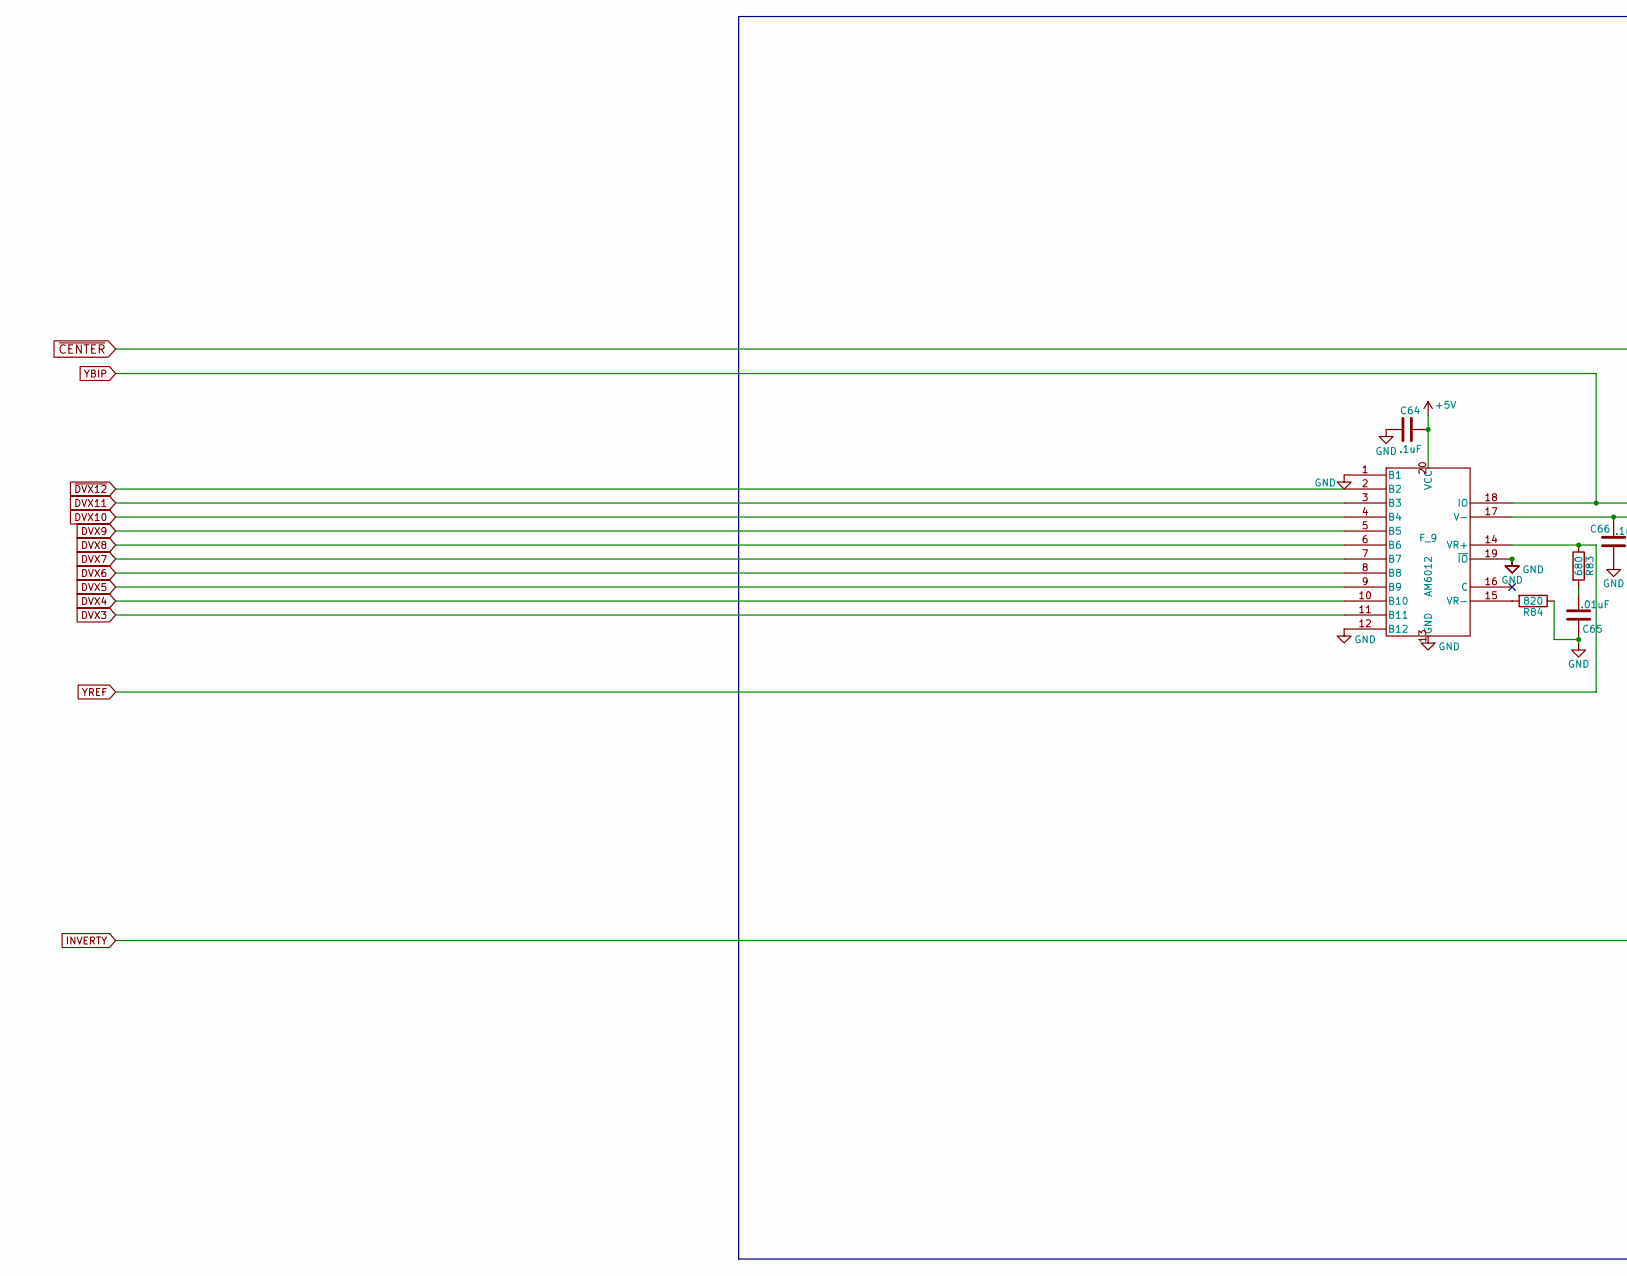
[picture p21: schematic untitled.kicad_sch, part in row 1, column 1]

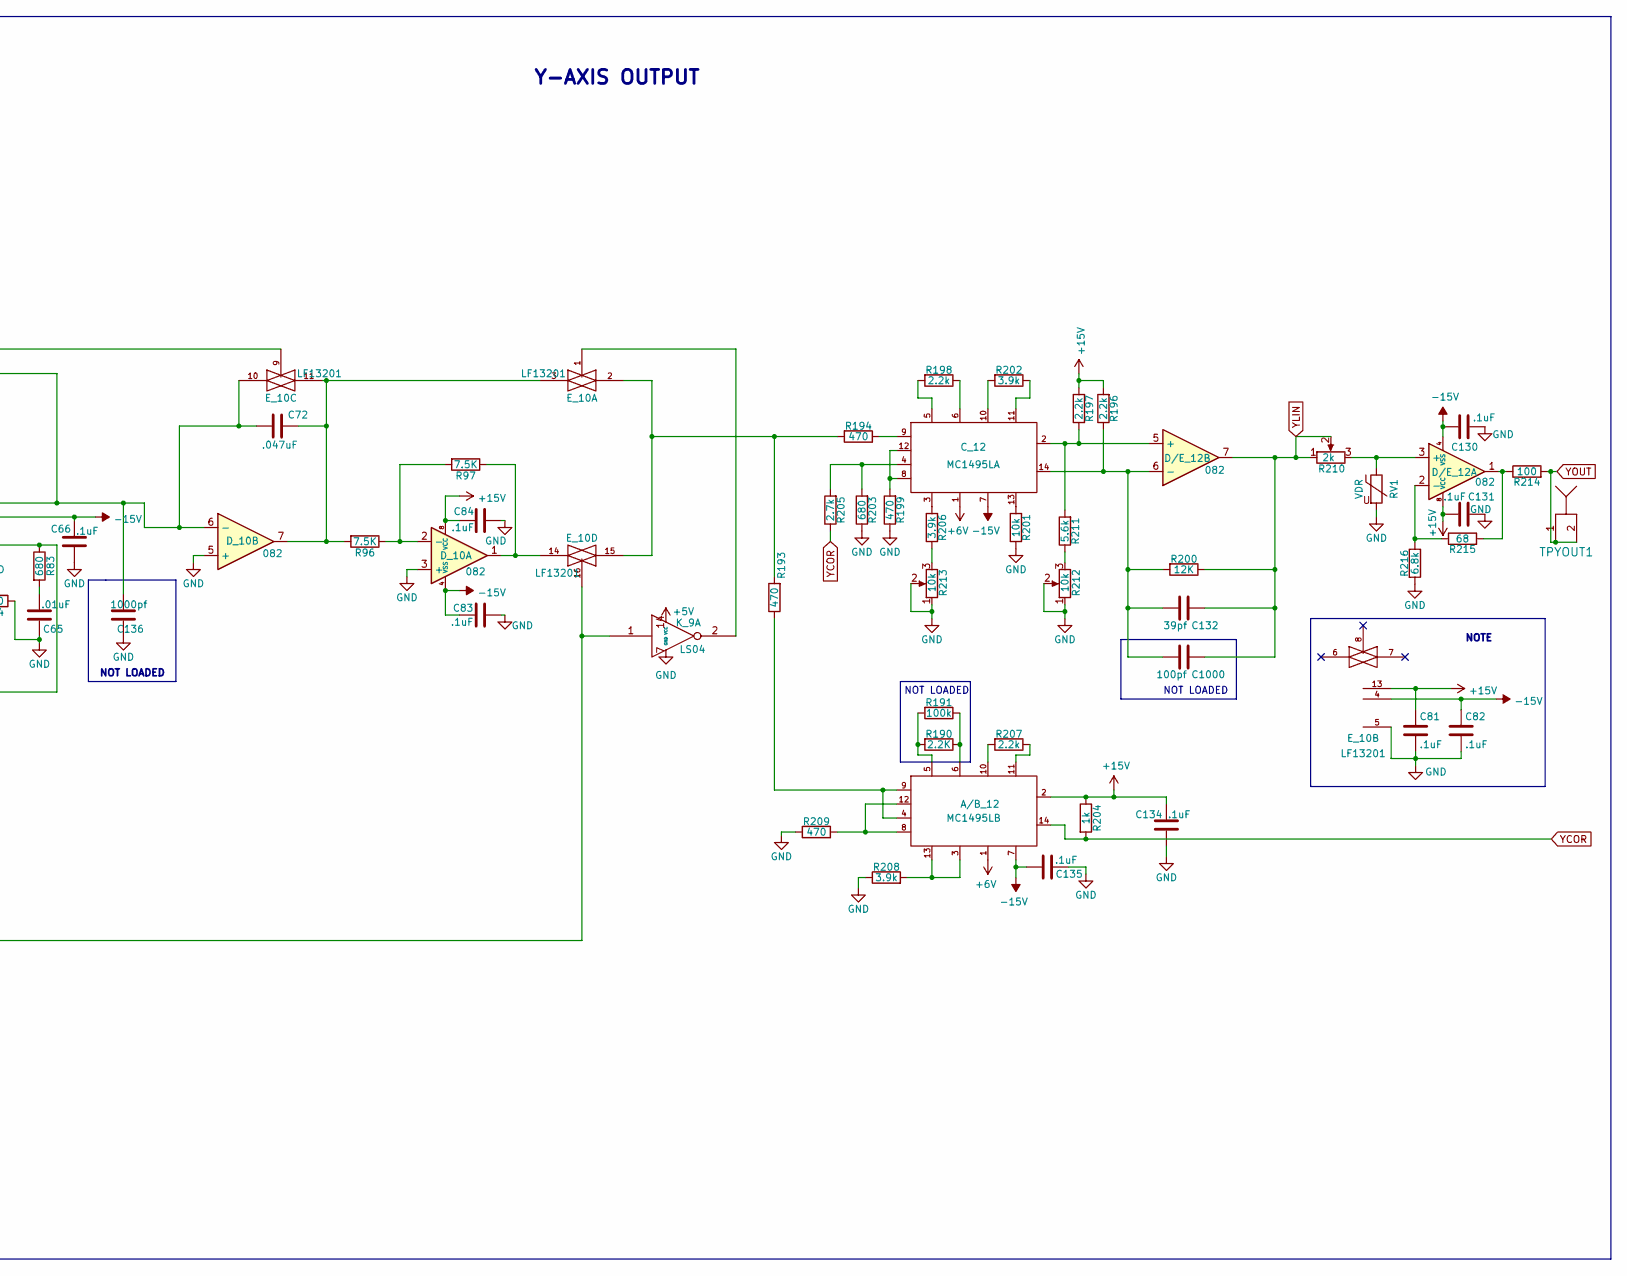
[picture p22: schematic untitled.kicad_sch, part in row 1, column 2]

Parts:
A/B_12: MC1495LB
C64, C66, C81, C82, C83, C84, C130, C131, C134, C135: .1uF
C65: .01uF
C72: .047uF
C132: 39pf
C136: 1000pf
C1000: 100pf
C_12: MC1495LA
D/E_12: 082
D_10: 082
E_10: LF13201
F_9: AM6012
K_9: LS04
R83, R203: 680
R84: 820
R96, R97: 7.5K
R190: 2.2K
R191: 100k
R193, R194, R199, R209: 470
R196, R197, R198, R207: 2.2k
R200: 12K
R201, R212, R213: 10k
R202, R206, R208: 3.9k
R204: 1k
R205: 2.7k
R210: 2k
R211: 5.6k
R214: 100
R215: 68
R216: 6.8k
RV1: VDR
TPYOUT1: TP

Connections:
+5V: C64.1, F_9.20 (VCC), K_9.14 (VCC)
+6V: A/B_12.1, C_12.1
+15V: A/B_12.2, C81.1, C84.2, C131.2, C134.2, D/E_12.8 (VCC), D_10.8 (VCC), E_10.13, R196.2, R197.2, R204.1
-15V: A/B_12.7, C66.2, C82.1, C83.2, C130.2, C135.2, C_12.7, D/E_12.4 (VSS), D_10.4 (VSS), E_10.4, F_9.17 (V-)
DVX3: F_9.11 (B11)
DVX4: F_9.10 (B10)
DVX5: F_9.9 (B9)
DVX6: F_9.8 (B8)
DVX7: F_9.7 (B7)
DVX8: F_9.6 (B6)
DVX9: F_9.5 (B5)
DVX10: F_9.4 (B4)
DVX11: F_9.3 (B3)
GND: C64.2, C65.1, C66.1, C81.2, C82.2, C83.1, C84.1, C130.1, C131.1, C134.1, C135.1, C136.1, D_10.3 (+), D_10.5 (+), E_10.5, F_9.1 (B1), F_9.12 (B12), F_9.13 (GND), F_9.19 (~IO), K_9.7 (GND), R84.1, R199.1, R201.1, R203.1, R208.1, R209.1, R212.1, R212.2, R213.1, R213.2, R216.2, RV1.2
INVERTY: E_10.16, K_9.1
unnamed: A/B_12.4, A/B_12.9, R193.1
unnamed: A/B_12.5, R190.2, R191.2
unnamed: A/B_12.6, R190.1, R191.1
unnamed: A/B_12.10, R207.2
unnamed: A/B_12.11, R207.1
unnamed: A/B_12.8, A/B_12.12, R209.2
unnamed: A/B_12.3, A/B_12.13, R208.2
unnamed: C65.2, R83.2
unnamed: C72.1, D_10.7, E_10.3, E_10.11, R96.2
unnamed: C132.2, C1000.2, C_12.14, D/E_12.6 (-), R196.1, R200.2
unnamed: C_12.2, D/E_12.5 (+), R197.1, R211.2
unnamed: C_12.3, R206.2
unnamed: C_12.4, R203.2, R205.2
unnamed: C_12.5, R198.2
unnamed: C_12.6, R198.1
unnamed: C_12.9, R194.1
unnamed: C_12.10, R202.2
unnamed: C_12.11, R202.1
unnamed: C_12.8, C_12.12, R199.2
unnamed: C_12.13, R201.2
unnamed: D/E_12.1, R214.1, R215.2
unnamed: D/E_12.2 (-), R215.1, R216.1
unnamed: D/E_12.3 (+), R210.3, RV1.1
unnamed: D_10.1, E_10.14, R97.1
unnamed: D_10.2 (-), R96.1, R97.2
unnamed: E_10.1, K_9.2
unnamed: E_10.2, E_10.15, R193.2, R194.2
unnamed: F_9.15 (VR-), R84.2
unnamed: R206.1, R213.3
unnamed: R211.1, R212.3
YBIP: C72.2, C136.2, D_10.6 (-), E_10.10, F_9.18 (IO)
YCOR: A/B_12.14, R204.2, R205.1
YLIN: C132.1, C1000.1, D/E_12.7, R200.1, R210.1, R210.2
YOUT: R214.2, TPYOUT1.1, TPYOUT1.2
YREF: F_9.14 (VR+), R83.1
~CENTER: E_10.9
~DVX12: F_9.2 (B2)

Notes on the sheet:
Y-AXIS OUTPUT
NOTE
NOT LOADED
NOT LOADED
