nmikstas/atari_gravitar_black_widow/address_decoders/kicad/GAL_to_bipolar/GAL_to_bipolar.kicad_sch

## KiCad design address_decoders/kicad/GAL_to_bipolar/GAL_to_bipolar.kicad_sch (2022-03-15)

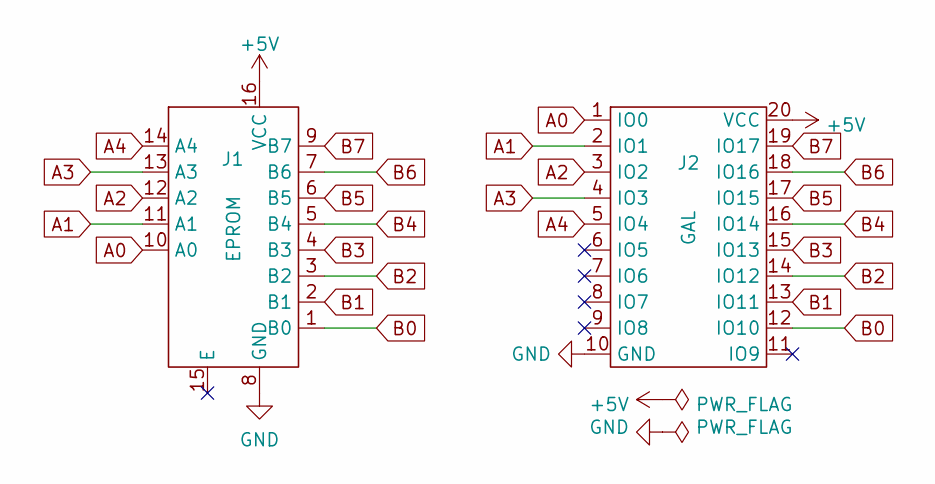
[picture p23: schematic GAL_to_bipolar.kicad_sch]

Parts:
J1: EPROM; DIP-16
J2: GAL; DIP-20

Connections:
+5V: J1.16 (VCC), J2.20 (VCC)
A0: J1.10 (A0), J2.1 (IO0)
A1: J1.11 (A1), J2.2 (IO1)
A2: J1.12 (A2), J2.3 (IO2)
A3: J1.13 (A3), J2.4 (IO3)
A4: J1.14 (A4), J2.5 (IO4)
B0: J1.1 (B0), J2.12 (IO10)
B1: J1.2 (B1), J2.13 (IO11)
B2: J1.3 (B2), J2.14 (IO12)
B3: J1.4 (B3), J2.15 (IO13)
B4: J1.5 (B4), J2.16 (IO14)
B5: J1.6 (B5), J2.17 (IO15)
B6: J1.7 (B6), J2.18 (IO16)
B7: J1.9 (B7), J2.19 (IO17)
GND: J1.8 (GND), J2.10 (GND)
