nmikstas/atari_gravitar_black_widow/(commit log)

2021-10-08 First commit - AVG & VSM
    [atari_gravitar_black_widow.sch]
2021-10-14 6B
    More sheet 6B (but not all)
    [atari_gravitar_black_widow.sch]
2021-10-17 sheet 6B
    Almost done
    [atari_gravitar_black_widow.sch]
2021-11-29 6A
    Op Code and Intensity Latches
    [atari_gravitar_black_widow.sch]
2021-12-03 Vector Data shifters
    [atari_gravitar_black_widow.sch]
2021-12-08 too much information
    added wrong (!) imports from Q, Ast, and SW
    WIll need to be altered to match Grav
    [atari_gravitar_black_widow.sch]
2021-12-29 Added PCB connectors to schematic
    [atari_gravitar_black_widow.sch]
2022-01-01 Completed sheet 6A
    [Sheet3B.sch, Sheet4A.sch, Sheet6A.sch, atari_gravitar_black_widow.sch]
2022-01-01 Rearranged the schematic sheets layout
    [Sheet3B.sch, Sheet4B.sch, Sheet5A.sch, Sheet5B.sch, Sheet6A.sch, Sheet6B.sch, Sheet7A.sch, Sheet7B.sch]
2022-01-02 Completed sheet 3B
    [Sheet3B.sch, SheetMisc.sch, atari_gravitar_black_widow.sch]
2022-01-02 Completed sheet 6B
    [Sheet6A.sch, Sheet6B.sch, atari_gravitar_black_widow.sch]
2022-01-03 Worked on sheet 7A
    [Sheet7A.sch]
2022-01-03 JBB worked on sheet 7a
    [Sheet7A.sch]
2022-01-03 JBB Sheet 7a
    [Sheet7A.sch]
2022-01-03 More Sheet 7a
    [Sheet7A.sch, SheetMisc.sch, atari_gravitar_black_widow.sch]
2022-01-03 Power for John
    sheet 7B
    [Sheet3B.sch, Sheet7A.sch]
2022-01-04 SHEET 7A
    [Sheet7A.sch]
2022-01-05 7a v1 completed
    [Sheet3B.kicad_sch, Sheet6A.kicad_sch, Sheet6B.kicad_sch, Sheet7A.kicad_sch, SheetMisc.kicad_sch, atari_gravitar_black_widow.kicad_sch]
2022-01-05 7a draft
    [atari_gravitar_black_widow.kicad_sch]
2022-01-06 start 8a
    [Sheet8A.kicad_sch, atari_gravitar_black_widow.kicad_sch]
2022-01-07 8A DRAFT DONE
    [Sheet8A.kicad_sch, atari_gravitar_black_widow.kicad_sch]
2022-01-07 8B COMPLETED
    [Sheet3B.kicad_sch, Sheet6B.kicad_sch, Sheet7A.kicad_sch, Sheet8B.kicad_sch, atari_gravitar_black_widow.kicad_sch]
2022-01-08 4A DONE
    [Sheet3B.kicad_sch, Sheet4A.kicad_sch, Sheet6B.kicad_sch, Sheet7A.kicad_sch, atari_gravitar_black_widow.kicad_sch]
2022-01-09 4B COMPLETED
    [Sheet3B.kicad_sch, Sheet4A.kicad_sch, Sheet4B.kicad_sch, Sheet6B.kicad_sch, Sheet7A.kicad_sch, atari_gravitar_black_widow.kicad_sch]
2022-01-09 workiing on 7b
    [Sheet4A.kicad_sch, Sheet4B.kicad_sch, Sheet7B.kicad_sch, atari_gravitar_black_widow.kicad_sch]
2022-01-10 7B COMPLETED
    [Sheet4A.kicad_sch, Sheet4B.kicad_sch, Sheet7B.kicad_sch, atari_gravitar_black_widow.kicad_sch]
2022-01-10 added footprint libaries
    [Sheet4A.kicad_sch, Sheet4B.kicad_sch, Sheet7B.kicad_sch, atari_gravitar_black_widow.kicad_sch]
2022-01-10 REVIEW 4A DONE
    [Sheet3B.kicad_sch, Sheet4A.kicad_sch, Sheet4B.kicad_sch, Sheet6A.kicad_sch, Sheet6B.kicad_sch, Sheet7A.kicad_sch, Sheet7B.kicad_sch, Sheet8A.kicad_sch]
2022-01-11 Sheet 5B
    needs signatures
    [Sheet5B.kicad_sch]
2022-01-12 Sheets 5A and 5B
    Also subbed Φ for PHI in Φ2, BΦ2 and ~{BΦ2}
    [Sheet3B.kicad_sch, Sheet4A.kicad_sch, Sheet4B.kicad_sch, Sheet5A.kicad_sch, Sheet5B.kicad_sch, Sheet6A.kicad_sch, Sheet6B.kicad_sch, Sheet7A.kicad_sch]
2022-01-14 reviewed first two sheets
    see notes on individual sheets
    [Sheet3B.kicad_sch, Sheet4A.kicad_sch, Sheet4B.kicad_sch, Sheet5A.kicad_sch, SheetMisc.kicad_sch, atari_gravitar_black_widow.kicad_sch]
2022-01-15 Fri Night
    various reviews
    [Sheet3B.kicad_sch, Sheet4A.kicad_sch, Sheet4B.kicad_sch, Sheet5A.kicad_sch, Sheet5B.kicad_sch, Sheet6A.kicad_sch, Sheet6B.kicad_sch, Sheet7A.kicad_sch]
2022-01-15 REVIEWS AND FINALS
    [Sheet4B.kicad_sch, Sheet5A.kicad_sch, Sheet5B.kicad_sch, Sheet6B.kicad_sch, Sheet7A.kicad_sch, Sheet7B.kicad_sch, Sheet8A.kicad_sch, atari_gravitar_black_widow.kicad_sch]
2022-01-16 20 errors left
    [Sheet3B.kicad_sch, Sheet4A.kicad_sch, Sheet5A.kicad_sch, Sheet5B.kicad_sch, Sheet7A.kicad_sch, Sheet7B.kicad_sch, Sheet8B.kicad_sch, atari_gravitar_black_widow.kicad_sch]
2022-01-16 19 errors left
    [Sheet4B.kicad_sch, Sheet5A.kicad_sch, Sheet7A.kicad_sch, Sheet8A.kicad_sch, Sheet8B.kicad_sch]
2022-01-17 Fixed most errors
    [Sheet3B.kicad_sch, Sheet4A.kicad_sch, Sheet4B.kicad_sch, Sheet5A.kicad_sch, Sheet7A.kicad_sch, Sheet8A.kicad_sch, Sheet8B.kicad_sch, SheetMisc.kicad_sch]
2022-01-17 Worked on removing the warnings
    [Sheet3B.kicad_sch, Sheet4A.kicad_sch, Sheet4B.kicad_sch, Sheet5A.kicad_sch, Sheet7A.kicad_sch, Sheet8A.kicad_sch, SheetMisc.kicad_sch, atari_gravitar_black_widow.kicad_sch]
2022-01-17 Removed more warnings - 25 warnings remain
    [Sheet3B.kicad_sch, Sheet4A.kicad_sch, Sheet5A.kicad_sch, Sheet5B.kicad_sch, Sheet7A.kicad_sch, Sheet7B.kicad_sch, Sheet8A.kicad_sch, SheetMisc.kicad_sch]
2022-01-17 Removed text from top level schematic
    [atari_gravitar_black_widow.kicad_sch]
2022-01-18 20 warnings left kicad 6.0
    [Sheet4B.kicad_sch, Sheet5A.kicad_sch, Sheet6B.kicad_sch, Sheet7A.kicad_sch, Sheet7B.kicad_sch, Sheet8A.kicad_sch, SheetMisc.kicad_sch, atari_gravitar_black_widow.kicad_sch]
2022-01-18 all warnings mitigated!!
    [Sheet4B.kicad_sch, Sheet5A.kicad_sch, Sheet7B.kicad_sch]
2022-01-18 Fixed all warnings and errors
    [Sheet3B.kicad_sch, Sheet4A.kicad_sch, Sheet4B.kicad_sch, Sheet5A.kicad_sch, Sheet5B.kicad_sch, Sheet6A.kicad_sch, Sheet7A.kicad_sch, Sheet7B.kicad_sch]
2022-01-18 Added PCB outline
    [Sheet7A.kicad_sch, atari_gravitar_black_widow.kicad_pcb, atari_gravitar_black_widow.kicad_sch]
2022-01-19 first traces.
    [Sheet4A.kicad_sch, Sheet4B.kicad_sch, Sheet5A.kicad_sch, Sheet7A.kicad_sch, atari_gravitar_black_widow.kicad_sch]
2022-01-19 test traces
    [Sheet4B.kicad_sch, Sheet7A.kicad_sch, Sheet8A.kicad_sch]
2022-01-19 place ttl
    [Sheet4A.kicad_sch, Sheet4B.kicad_sch, Sheet5A.kicad_sch, Sheet6A.kicad_sch, Sheet6B.kicad_sch, Sheet7A.kicad_sch, Sheet8A.kicad_sch, atari_gravitar_black_widow.kicad_sch]
2022-01-20 more ttl placements
    [Sheet3B.kicad_sch, Sheet4A.kicad_sch, Sheet4B.kicad_sch, Sheet5A.kicad_sch, Sheet6A.kicad_sch, Sheet6B.kicad_sch, Sheet7A.kicad_sch, Sheet7B.kicad_sch]
2022-01-20 some routing and E2 bus fix
    [Sheet4B.kicad_sch, atari_gravitar_black_widow.kicad_sch]
2022-01-20 New footprints
    Using G parts and G solder from B&W source to try to speed up PCB layout. Next step is to decrease below 300 dpi.
2022-01-21 more routing
    program ROMs (and maybe others) need pin 24 added and connected to GND.
2022-01-21 more chip layouts
    [Sheet3B.kicad_sch, Sheet4A.kicad_sch, Sheet4B.kicad_sch, Sheet5A.kicad_sch, Sheet5B.kicad_sch, Sheet6A.kicad_sch, Sheet6B.kicad_sch, Sheet7A.kicad_sch]
2022-01-21 more row 1
    [Sheet4B.kicad_sch]
2022-01-21 TEST POINTS PLACED
    [Sheet3B.kicad_sch, Sheet4A.kicad_sch, Sheet4B.kicad_sch, Sheet5B.kicad_sch, Sheet6B.kicad_sch, Sheet7A.kicad_sch, Sheet7B.kicad_sch, Sheet8A.kicad_sch]
2022-01-22 TP vrom creation
    [Sheet5B.kicad_sch, atari_gravitar_black_widow.kicad_sch]
2022-01-22 LAST OF TP PLACEMENT
    [Sheet4B.kicad_sch, Sheet5A.kicad_sch, Sheet8A.kicad_sch, atari_gravitar_black_widow.kicad_sch]
2022-01-22 PLACED C1-C15
    [Sheet3B.kicad_sch, Sheet4B.kicad_sch, Sheet8A.kicad_sch, atari_gravitar_black_widow.kicad_sch]
2022-01-22 Modified the gitignore file
    [sdf.kicad_pcb, sdf.sch]
2022-01-24 Worked on traces and components
    [Sheet4B.kicad_sch, SheetMisc.kicad_sch, atari_gravitar_black_widow.kicad_sch]
2022-01-24 Added traces and bottom image
    [Sheet3B.kicad_sch, Sheet4B.kicad_sch, Sheet5B.kicad_sch, Sheet7A.kicad_sch, SheetMisc.kicad_sch, atari_gravitar_black_widow.kicad_sch]
2022-01-24 catbox connector
2022-01-24 more caps
    [Sheet4B.kicad_sch, Sheet5A.kicad_sch, Sheet7A.kicad_sch, SheetMisc.kicad_sch, atari_gravitar_black_widow.kicad_sch, untitled.kicad_sch]
2022-01-25 more cap placements
    [Sheet3B.kicad_sch, Sheet4B.kicad_sch, Sheet5A.kicad_sch, Sheet7A.kicad_sch, Sheet7B.kicad_sch, Sheet8A.kicad_sch, atari_gravitar_black_widow.kicad_sch, untitled.kicad_sch]
2022-01-25 caps placement up to c126
    [Sheet3B.kicad_sch, Sheet7B.kicad_sch, atari_gravitar_black_widow.kicad_sch, untitled.kicad_sch]
2022-01-25 Row one solder / ROM fix
    ROM enables were shifted on schematic
    [Sheet4B.kicad_sch, Sheet7A.kicad_sch]
2022-01-26 resistor placements R1-R153
    [Sheet3B.kicad_sch, Sheet4A.kicad_sch, Sheet4B.kicad_sch, Sheet5A.kicad_sch, Sheet5B.kicad_sch, Sheet6B.kicad_sch, Sheet7A.kicad_sch, Sheet7B.kicad_sch]
2022-01-26 more resistor placements
    [Sheet4B.kicad_sch, Sheet8A.kicad_sch, atari_gravitar_black_widow.kicad_sch]
2022-01-27 all resistors placed.
    [Sheet3B.kicad_sch, Sheet4B.kicad_sch, Sheet8A.kicad_sch, atari_gravitar_black_widow.kicad_sch, untitled.kicad_sch]
2022-01-28 r214-r18 not on PCB layout had to improvise
2022-01-28 ALL RESISTORS AND CAPS PLACED!
2022-01-28 ALL PARTS PLACED!!
    [Sheet3B.kicad_sch, Sheet4A.kicad_sch, Sheet4B.kicad_sch, Sheet5A.kicad_sch, Sheet7B.kicad_sch, Sheet8A.kicad_sch, atari_gravitar_black_widow.kicad_sch, untitled.kicad_sch]
2022-01-28 ROW 7 TOPSIDE TRACES COMPLETED
    [Sheet3B.kicad_sch, Sheet4B.kicad_sch, atari_gravitar_black_widow.kicad_sch, untitled.kicad_sch]
2022-01-28 Row 2 routing and schematic fixes
    EAROM (M2) had duplicate pins and no footprint :(
    N8 pins were in wrong order
    [Sheet4B.kicad_sch, Sheet5B.kicad_sch, atari_gravitar_black_widow.kicad_sch]
2022-01-29 Fixed all schematic warnings and fixed the edge cuts
    [Sheet3B.kicad_sch, Sheet4A.kicad_sch, Sheet4B.kicad_sch, Sheet5A.kicad_sch, Sheet5B.kicad_sch, Sheet6B.kicad_sch, Sheet7A.kicad_sch, Sheet7B.kicad_sch]
2022-01-29 Fixed all warning on PCB layout
    [Sheet3B.kicad_sch, Sheet4B.kicad_sch, Sheet5A.kicad_sch, Sheet5B.kicad_sch, Sheet6B.kicad_sch, Sheet7A.kicad_sch, Sheet7B.kicad_sch, Sheet8A.kicad_sch]
2022-01-29 resolved 1.5mhz trace top and bottom
2022-01-30 Adjusted trace spacing
    [SheetMisc.kicad_sch, atari_gravitar_black_widow.kicad_sch]
2022-01-30 more topside traces
2022-01-30 more top traces completed
    [Sheet7B.kicad_sch]
2022-01-30 more traces top left
    [Sheet7B.kicad_sch]
2022-01-31 Fixed ERC errors and added traces to the edge connectors
    [Sheet8A.kicad_sch, atari_gravitar_black_widow.kicad_sch, untitled.kicad_sch]
2022-01-31 traces and more traces
    [Sheet7A.kicad_sch, Sheet7B.kicad_sch, atari_gravitar_black_widow.kicad_sch]
2022-01-31 more traces
    [Sheet7B.kicad_sch, atari_gravitar_black_widow.kicad_sch]
2022-01-31 Row 3 - 3.5 tracess
    Also fixed some schematic errors (IO at J6, power at R4, Z out TP)
    [Sheet4A.kicad_sch, Sheet5A.kicad_sch, Sheet6B.kicad_sch, Sheet7B.kicad_sch, atari_gravitar_black_widow.kicad_sch]
2022-01-31 backside traces
2022-01-31 fixed coin door schematic issues
    [Sheet5A.kicad_sch, atari_gravitar_black_widow.kicad_sch]
2022-01-31 player 1 led issue fixed
    [Sheet5A.kicad_sch, atari_gravitar_black_widow.kicad_sch]
2022-02-01 back traces
2022-02-01 back traces done top left
2022-02-01 lots o' traces
    [Sheet4A.kicad_sch, Sheet5A.kicad_sch, Sheet6A.kicad_sch, Sheet6B.kicad_sch, Sheet7A.kicad_sch, Sheet7B.kicad_sch, atari_gravitar_black_widow.kicad_sch]
2022-02-02 traces back
    [Sheet5B.kicad_sch]
2022-02-02 Fixed 5c issues
    [Sheet5B.kicad_sch, atari_gravitar_black_widow.kicad_sch]
2022-02-02 many traces on back fixed not DVY12 on F9
    [Sheet4A.kicad_sch, Sheet6A.kicad_sch, Sheet6B.kicad_sch, Sheet7A.kicad_sch, atari_gravitar_black_widow.kicad_sch, untitled.kicad_sch]
2022-02-02 All digital done!
    Need ground flood and analog section.
    [Sheet4A.kicad_sch, Sheet5A.kicad_sch, Sheet6A.kicad_sch, Sheet6B.kicad_sch, Sheet7A.kicad_sch, atari_gravitar_black_widow.kicad_sch]
2022-02-03 back analog area traces
2022-02-03 finished most all traces in analog
    [Sheet4A.kicad_sch, Sheet6A.kicad_sch, Sheet6B.kicad_sch, Sheet7A.kicad_sch, Sheet8A.kicad_sch, atari_gravitar_black_widow.kicad_sch, untitled.kicad_sch]
2022-02-03 Analog done but for rev 2 R/Cs
    [Sheet4A.kicad_sch, Sheet6A.kicad_sch, Sheet6B.kicad_sch, Sheet7A.kicad_sch, Sheet8A.kicad_sch, untitled.kicad_sch]
2022-02-03 Just need grounds and rev 2 resistors
    [Sheet8A.kicad_sch, atari_gravitar_black_widow.kicad_sch, untitled.kicad_sch]
2022-02-03 silkscreen alignment
2022-02-03 silkscreen cosmetics completed
2022-02-04 ground plane
2022-02-04 ground plane mods
2022-02-04 rev 2 resistors and via work
    Created a home for R214-219. Replaced unpopulated vias with C9 and E9 and P9. Made sure all TPs are bridged.
    Needs holes near edge connector and "Atari" "Gravitar" and logo etc.
2022-02-04 HOLES AND signatures
2022-02-06 second to last cleanup?
    [Sheet7B.kicad_sch, Sheet8A.kicad_sch, atari_gravitar_black_widow.kicad_sch, untitled.kicad_sch]
2022-02-06 NOT LOADED PARTS ADDED
    [SheetMisc.kicad_sch, atari_gravitar_black_widow.kicad_sch]
2022-02-07 unused parts places and traced
    [SheetMisc.kicad_sch, atari_gravitar_black_widow.kicad_sch]
2022-02-07 Silkscreen cleanup
2022-02-08 Fixed various issues and generated gerber files
    [Sheet4A.kicad_sch, Sheet6A.kicad_sch, Sheet6B.kicad_sch, Sheet7A.kicad_sch, Sheet8A.kicad_sch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]
2022-02-08 Fixed the masks on the edge connectors
    [atari_gravitar_black_widow-B_Cu.gbr, atari_gravitar_black_widow-B_Mask.gbr, atari_gravitar_black_widow-B_Silkscreen.gbr, atari_gravitar_black_widow-Edge_Cuts.gbr, atari_gravitar_black_widow-F_Cu.gbr, atari_gravitar_black_widow-F_Mask.gbr, atari_gravitar_black_widow-F_Silkscreen.gbr, atari_gravitar_black_widow-NPTH.drl]
2022-02-08 Added mask to solder side of catbox connector!
    silkscreen cleanup. RTG!
    [atari_gravitar_black_widow-B_Cu.gbr, atari_gravitar_black_widow-B_Mask.gbr, atari_gravitar_black_widow-B_Silkscreen.gbr, atari_gravitar_black_widow-Edge_Cuts.gbr, atari_gravitar_black_widow-F_Cu.gbr, atari_gravitar_black_widow-F_Mask.gbr, atari_gravitar_black_widow-F_Silkscreen.gbr, atari_gravitar_black_widow-NPTH.drl]
2022-02-09 Fixed cat box connector
    [SheetMisc.kicad_sch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]
2022-02-09 Fixed several traces
    [Sheet8A.kicad_sch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]
2022-02-09 fixed silkscreen change lockout!
2022-02-09 Visual tweaks
    Added row letters and straightened traces
2022-02-10 final gerbers produced and sent to FAB
    [atari_gravitar_black_widow-B_Cu.gbr, atari_gravitar_black_widow-B_Mask.gbr, atari_gravitar_black_widow-B_Silkscreen.gbr, atari_gravitar_black_widow-Edge_Cuts.gbr, atari_gravitar_black_widow-F_Cu.gbr, atari_gravitar_black_widow-F_Mask.gbr, atari_gravitar_black_widow-F_Silkscreen.gbr, atari_gravitar_black_widow-NPTH.drl]
2022-02-11 final alpha changes
    added trace across vias for +5v on solder side near edge connector
    [atari_gravitar_black_widow-B_Cu.gbr, atari_gravitar_black_widow-B_Mask.gbr, atari_gravitar_black_widow-B_Silkscreen.gbr, atari_gravitar_black_widow-Edge_Cuts.gbr, atari_gravitar_black_widow-F_Cu.gbr, atari_gravitar_black_widow-F_Mask.gbr, atari_gravitar_black_widow-F_Silkscreen.gbr, atari_gravitar_black_widow.drl]
2022-02-11 GWBWFinal Gerbers made
    [atari_gravitar_black_widow-B_Cu.gbr, atari_gravitar_black_widow-B_Mask.gbr, atari_gravitar_black_widow-B_Silkscreen.gbr, atari_gravitar_black_widow-Edge_Cuts.gbr, atari_gravitar_black_widow-F_Cu.gbr, atari_gravitar_black_widow-F_Mask.gbr, atari_gravitar_black_widow-F_Silkscreen.gbr, atari_gravitar_black_widow-NPTH.drl]
2022-02-14 Added adapter board for the 2 address decoders along with GAL code
    [GAL_to_bipolar-B_Cu.gbr, GAL_to_bipolar-B_Mask.gbr, GAL_to_bipolar-B_Silkscreen.gbr, GAL_to_bipolar-Edge_Cuts.gbr, GAL_to_bipolar-F_Cu.gbr, GAL_to_bipolar-F_Mask.gbr, GAL_to_bipolar-F_Silkscreen.gbr, GAL_to_bipolar-NPTH.drl]
2022-03-07 Changed position of rev 2 resistors, straightened some misaligned chips & traces.
2022-03-15 Fixed the reversed address bits in the GAL adapter PCB
    [GAL_to_bipolar.kicad_sch]
2022-03-16 caps polarity, c39, c38, transistors holes to .125 mil
    [Sheet4B.kicad_sch, Sheet5A.kicad_sch, Sheet6A.kicad_sch, Sheet6B.kicad_sch, atari_gravitar_black_widow.kicad_sch]
2022-03-18 Fixed silkscreen issues
    [Sheet4B.kicad_sch]
2022-03-22 Fixed C34 and 6MHZ trace
    [Sheet5A.kicad_sch, atari_gravitar_black_widow.kicad_sch]
2022-03-23 Fixed the silkscreen
2023-12-24 Fixed schematic and PCB errors. Added BOM
    [Sheet6A.kicad_sch, Sheet6B.kicad_sch]
